ErickCalle/Monitoreo-Consumo-Combustible-La-Paz-Bolivia/CAP5/cap5.tex

% !TEX root = ../main.tex
% ============================================================================
% CAPÍTULO 5 — ANÁLISIS DE COSTOS Y PRESUPUESTO
% ============================================================================

\chapter{ANÁLISIS DE COSTOS Y PRESUPUESTO}

Este capítulo cuantifica el costo de desarrollar, fabricar y validar el sistema descrito en los Capítulos 3 y 4, y evalúa su viabilidad económica frente a alternativas comerciales existentes. El desglose sigue el mismo criterio de agrupación funcional ya establecido en la lista de materiales del Capítulo~3 (Tabla~\ref{bom}) y en la tabla de componentes del prototipo del Capítulo~4 (Tabla~\ref{tab:componentes_protoboard}). Así, cada partida de costo puede rastrearse hasta el componente físico concreto que la origina, en lugar de quedar como una cifra agregada sin respaldo.

Los montos se expresan en bolivianos (Bs), moneda de referencia ya utilizada en el resto del proyecto de grado (por ejemplo, \texttt{FUEL\_PRICE\_BS\_PER\_L} en el firmware), con una columna equivalente en dólares (USD) para los componentes que se cotizan internacionalmente (LCSC, JLCPCB, AliExpress). Dado que el tipo de cambio BOB/USD ha tenido variaciones significativas en el mercado boliviano en los últimos años, las conversiones de este capítulo usan el tipo de cambio paralelo vigente al momento de la cotización, 11,60\,Bs/USD (agosto de 2026), y no un valor fijo asumido de antemano ni el tipo de cambio oficial, que en este periodo no refleja el costo real de acceso a dólares para la importación de componentes.

\section{Costos de componentes electrónicos}

Esta sección desglosa el costo de los componentes electrónicos en los mismos cuatro bloques funcionales de la Tabla~\ref{bom}: procesamiento, alimentación, interfaz CAN y periféricos. Las cantidades de cada fila provienen directamente de esa tabla; aquí solo se añaden el precio unitario y el subtotal por bloque.

\subsection{Costos del módulo de procesamiento (ESP32-S3)}

\begin{table}[H]
	\centering
	\captionsetup{labelformat=simple, labelsep=newline, textfont=it, labelfont=bf, justification=raggedright, singlelinecheck=false}
	\caption{Costo del módulo de procesamiento}
	\label{tab:costo_procesamiento}
	\begin{tabularx}{\textwidth}{X >{\centering\arraybackslash}p{1.6cm} >{\centering\arraybackslash}p{2.6cm} >{\centering\arraybackslash}p{2.6cm} >{\centering\arraybackslash}p{2.6cm}}
		\toprule
		\rowcolor[rgb]{0.851, 0.851, 0.851}
		Componente & Cant. & Precio unit. (USD) & Precio unit. (Bs) & Subtotal (Bs) \\
		\midrule
		Módulo ESP32-S3-WROOM-1-N16R8 (DevKitC-1, prototipo) & 1 & 9,48 & 110 & 110 \\
		\bottomrule
	\end{tabularx}
	\vspace{2mm}
	\\
	\begin{minipage}{\linewidth}
		\small
		\textit{Nota.} Precio del módulo de desarrollo completo (\textit{DevKitC-1}); la versión final en PCB propia podría usar el módulo suelto a menor costo, a cambio de requerir un programador externo para el primer flasheo.
	\end{minipage}
\end{table}

\subsection{Costos de la etapa de alimentación (buck y LDOs)}

\begin{table}[H]
	\centering
	\captionsetup{labelformat=simple, labelsep=newline, textfont=it, labelfont=bf, justification=raggedright, singlelinecheck=false}
	\caption{Costo de la etapa de alimentación de dos rieles}
	\label{tab:costo_alimentacion}
	\begin{tabularx}{\textwidth}{X >{\centering\arraybackslash}p{1.6cm} >{\centering\arraybackslash}p{2.6cm} >{\centering\arraybackslash}p{2.6cm} >{\centering\arraybackslash}p{2.6cm}}
		\toprule
		\rowcolor[rgb]{0.851, 0.851, 0.851}
		Componente & Cant. & Precio unit. (USD) & Precio unit. (Bs) & Subtotal (Bs) \\
		\midrule
		Convertidor buck síncrono TPS54302DDCR & 1 & 0,2538 & 2,94 & 2,94 \\
		LDO AMS1117-3,3 (riel 1) & 1 & 0,2039 & 2,37 & 2,37 \\
		LDO AP2112K-3,3TRG1 (riel 2) & 1 & 0,2043 & 2,37 & 2,37 \\
		Diodo Schottky SS34 (protección polaridad) & 1 & 0,039 & 0,45 & 0,45 \\
		Fusible PTC reseteable 1812L150/33GR & 1 & 0,0575 & 0,67 & 0,67 \\
		Inductor de potencia 10~\textmu H & 1 & 1,3769 & 15,97 & 15,97 \\
		Condensadores y resistencias pasivas (Tabla~\ref{bom}) & 16 & 0,7323 & 8,49 & 135,91 \\
		\bottomrule
	\end{tabularx}
	\vspace{2mm}
	\\
	\begin{minipage}{\linewidth}
		\small
		\textit{Nota.} Los pasivos se cotizan por cinta/carrete completo, por lo que a cantidad de prototipo su costo unitario es mayor que en producción en volumen; se diluye al escalar (Subsección~\ref{sec:costo_beneficio}).
	\end{minipage}
\end{table}

\subsection{Costos de la interfaz CAN (transceptor y protección)}

\begin{table}[H]
	\centering
	\captionsetup{labelformat=simple, labelsep=newline, textfont=it, labelfont=bf, justification=raggedright, singlelinecheck=false}
	\caption{Costo de la interfaz de bus CAN}
	\label{tab:costo_can}
	\begin{tabularx}{\textwidth}{X >{\centering\arraybackslash}p{1.6cm} >{\centering\arraybackslash}p{2.6cm} >{\centering\arraybackslash}p{2.6cm} >{\centering\arraybackslash}p{2.6cm}}
		\toprule
		\rowcolor[rgb]{0.851, 0.851, 0.851}
		Componente & Cant. & Precio unit. (USD) & Precio unit. (Bs) & Subtotal (Bs) \\
		\midrule
		Transceptor CAN SN65HVD230 & 1 & 1,5216 & 17,65 & 17,65 \\
		Resistor control de pendiente (10~k$\Omega$) & 1 & 0,0912 & 1,06 & 1,06 \\
		Resistor de terminación 120~$\Omega$ (\textit{footprint} opcional, no poblado) & 0 & --- & --- & 0{,}00 \\
		Condensador de desacople & 1 & 0,4296 & 4,98 & 4,98 \\
		\bottomrule
	\end{tabularx}
	\vspace{2mm}
	\\
	\begin{minipage}{\linewidth}
		\small
		\textit{Nota.} El resistor de terminación no se puebla por defecto (Tabla~\ref{bom}, nota $^{a}$): el dispositivo se conecta en derivación a un bus CAN que el vehículo ya termina, por eso su costo es cero y no una omisión.
	\end{minipage}
\end{table}

\subsection{Costos de periféricos (MicroSD, OLED, conectores)}

\begin{table}[H]
	\centering
	\captionsetup{labelformat=simple, labelsep=newline, textfont=it, labelfont=bf, justification=raggedright, singlelinecheck=false}
	\caption{Costo de periféricos de almacenamiento, visualización y conexión}
	\label{tab:costo_perifericos}
	\begin{tabularx}{\textwidth}{X >{\centering\arraybackslash}p{1.6cm} >{\centering\arraybackslash}p{2.6cm} >{\centering\arraybackslash}p{2.6cm} >{\centering\arraybackslash}p{2.6cm}}
		\toprule
		\rowcolor[rgb]{0.851, 0.851, 0.851}
		Componente & Cant. & Precio unit. (USD) & Precio unit. (Bs) & Subtotal (Bs) \\
		\midrule
		Zócalo MicroSD (\textit{push-push}) & 1 & 0,1318 & 1,53 & 1,53 \\
		Tarjeta MicroSD (capacidad de referencia) & 1 & 3,2141 & 37,28 & 37,28 \\
		Pantalla OLED SSD1306 I\textsuperscript{2}C 0,96 & 1 & 2,686 & 31,16 & 31,16 \\
		Conector OBD-II tipo A con cable & 1 & 0,8 & 9,28 & 9,28 \\
		LEDs indicadores + resistencias limitadoras & 4 & 0,2120 & 2,46 & 9,84 \\
		Resistencias \textit{pull-up} SPI/I\textsuperscript{2}C (Tabla~\ref{bom}) & 6 & 0,0460 & 0,53 & 3,20 \\
		\bottomrule
	\end{tabularx}
	\vspace{2mm}
	\\
	\begin{minipage}{\linewidth}
		\small
		\textit{Nota.} La capacidad de la tarjeta MicroSD es más una decisión de autonomía de registro que de costo: dado el tamaño de fila estimado en el Capítulo~4 ($\approx$100 bytes/fila a 1 muestra/s), incluso una tarjeta de 8~GB excede ampliamente los requisitos de años de uso continuo, así que pagar por mayor capacidad no tiene sentido.
	\end{minipage}
\end{table}

\section{Costos de desarrollo y software}

El conjunto de herramientas de desarrollo de firmware empleado (Visual Studio Code, la extensión PlatformIO IDE y el \textit{framework} \texttt{arduino-esp32}) es de uso libre y sin costo de licenciamiento, criterio de selección ya justificado en la Sección de herramientas del Capítulo~3. El costo real de esta partida no está en licencias, entonces, sino en el tiempo de ingeniería invertido en el diseño de hardware, el firmware y la interfaz web. La tarifa de la Tabla~\ref{tab:costo_horas} se deja deliberadamente en 0\,Bs/h: el objetivo de este capítulo es el costo de materiales y fabricación, no el valor de mercado de las horas de un proyecto de grado, así que el total de horas queda documentado como referencia de esfuerzo, no como partida monetaria.

\begin{table}[H]
	\centering
	\captionsetup{labelformat=simple, labelsep=newline, textfont=it, labelfont=bf, justification=raggedright, singlelinecheck=false}
	\caption{Costo estimado de horas de ingeniería por etapa de desarrollo}
	\label{tab:costo_horas}
	\begin{tabularx}{\textwidth}{X >{\centering\arraybackslash}p{2.6cm} >{\centering\arraybackslash}p{2.6cm} >{\centering\arraybackslash}p{2.6cm}}
		\toprule
		\rowcolor[rgb]{0.851, 0.851, 0.851}
		Etapa & Horas estimadas & Tarifa (Bs/h) & Subtotal (Bs) \\
		\midrule
		Diseño de esquemático y PCB & 8 & 0 & 0 \\
		Desarrollo de firmware (adquisición, cálculo, almacenamiento) & 28 & 0 & 0 \\
		Desarrollo del panel web (HMI) & 28 & 0 & 0 \\
		Pruebas, calibración y depuración & 120 & 0 & 0 \\
		\midrule
		\textbf{Total} & \textbf{184} & --- & \textbf{0} \\
		\bottomrule
	\end{tabularx}
	\vspace{2mm}
	\\
	\begin{minipage}{\linewidth}
		\small
		\textit{Nota.} Horas estimadas a partir de la dedicación real del autor ($\approx$4\,h/día): 2 días para la PCB, 1 semana para firmware y panel web cada uno, y 1 mes para la calibración.
	\end{minipage}
\end{table}

\section{Costos de fabricación y ensamblaje}

\subsection{Costos de la placa preliminar (Robokit)}
\label{sec:costo_pcb_preliminar}

La placa preliminar en Altium Designer descrita en la Sección~\ref{sec:placa_preliminar} (Capítulo~4) es, hasta el momento, la única placa de este proyecto efectivamente fabricada y ensamblada; por eso es la que se usa como \textbf{costo real del prototipo} en el presupuesto consolidado de este capítulo (Tabla~\ref{tab:presupuesto_total}). Se encargó localmente a Robokit (La Paz), lo que evita el envío internacional y la aduana que sí aplican a una fabricación en JLCPCB (Subsección~\ref{sec:costo_pcb_final}).

\begin{table}[H]
	\centering
	\captionsetup{labelformat=simple, labelsep=newline, textfont=it, labelfont=bf, justification=raggedright, singlelinecheck=false}
	\caption{Costo de fabricación de la placa preliminar en Robokit}
	\label{tab:costo_pcb_preliminar}
	\begin{tabularx}{\textwidth}{X >{\centering\arraybackslash}p{2cm} >{\centering\arraybackslash}p{2.6cm}}
		\toprule
		\rowcolor[rgb]{0.851, 0.851, 0.851}
		Concepto & Cantidad & Subtotal (Bs) \\
		\midrule
		Fabricación de PCB (Robokit, La Paz) & 1 & 150,00 \\
		Ensamblaje (soldadura manual, propia) & --- & 0,00 \\
		\midrule
		\textbf{Total} & --- & \textbf{150,00} \\
		\bottomrule
	\end{tabularx}
	\vspace{2mm}
	\\
	\begin{minipage}{\linewidth}
		\small
		\textit{Nota.} Cotización y fabricación locales (La Paz), sin envío internacional ni aduana; el ensamblaje manual, hecho por el propio autor, no tiene costo adicional (mismo criterio de tarifa 0\,Bs/h de la Tabla~\ref{tab:costo_horas}).
	\end{minipage}
\end{table}

La lista de materiales real de esta placa (16 referencias, exportada desde Altium Designer) muestra que su etapa de alimentación es una regulación lineal simple (7805 + transistor de paso TIP42C) y no la conversión conmutada de dos rieles de la Tabla~\ref{tab:costo_alimentacion} —esa etapa es específica de la placa final—; el módulo ESP32-S3, el transceptor CAN, la pantalla OLED y la tarjeta microSD son los mismos ya presupuestados en las Tablas~\ref{tab:costo_procesamiento}, \ref{tab:costo_can} y~\ref{tab:costo_perifericos}, reutilizados desde la etapa de protoboard y conectados a esta placa mediante los conectores de la Tabla~\ref{tab:costo_placa_preliminar_bom} en vez de cableado suelto. Los indicadores LED y sus resistencias limitadoras también coinciden con los ya contabilizados en la Tabla~\ref{tab:costo_perifericos}, por lo que no se repiten aquí. Los precios de la Tabla~\ref{tab:costo_placa_preliminar_bom} se tomaron de LCSC a partir de las referencias de fabricante exportadas desde Altium Designer; las tres partidas sin coincidencia exacta en el catálogo (capacitor de 22\,\textmu F, header de 8 pines y conector de 4 pines) se estiman por interpolación directa desde variantes de la misma familia con precio confirmado, no por un valor arbitrario.

\begin{table}[H]
	\centering
	\captionsetup{labelformat=simple, labelsep=newline, textfont=it, labelfont=bf, justification=raggedright, singlelinecheck=false}
	\caption{Componentes adicionales de la placa preliminar (etapa de alimentación y conectores)}
	\label{tab:costo_placa_preliminar_bom}
	\begin{tabularx}{\textwidth}{X >{\centering\arraybackslash}p{1.6cm} >{\centering\arraybackslash}p{2.2cm} >{\centering\arraybackslash}p{2.2cm} >{\centering\arraybackslash}p{2.2cm}}
		\toprule
		\rowcolor[rgb]{0.851, 0.851, 0.851}
		Componente & Cant. & Precio unit. (USD) & Precio unit. (Bs) & Subtotal (Bs) \\
		\midrule
		Regulador lineal 7805 (TO-252) & 1 & 0,0979 & 1,14 & 1,14 \\
		Transistor de paso TIP42C (TO-220) & 1 & 0,1777 & 2,06 & 2,06 \\
		Capacitor electrolítico 220\,\textmu F & 1 & 0,1400 & 1,62 & 1,62 \\
		Capacitor electrolítico 22\,\textmu F & 1 & 0,1200 & 1,39 & 1,39 \\
		Capacitor cerámico 100\,nF & 2 & 0,0200 & 0,23 & 0,46 \\
		Resistor THT 47\,$\Omega$ 1\,W & 1 & 0,0112 & 0,13 & 0,13 \\
		Conector de entrada de alimentación, 4~pines (WJ301V-5.0) & 1 & 0,1700 & 1,97 & 1,97 \\
		Header 4~pines (pantalla OLED) & 1 & 0,0198 & 0,23 & 0,23 \\
		Header 6~pines (transceptor SN65HVD230) & 1 & 0,0298 & 0,35 & 0,35 \\
		Header 8~pines (módulo microSD) & 1 & 0,0400 & 0,46 & 0,46 \\
		\midrule
		\textbf{Total} & --- & --- & --- & \textbf{9,81} \\
		\bottomrule
	\end{tabularx}
	\vspace{2mm}
	\\
	\begin{minipage}{\linewidth}
		\small
		\textit{Nota.} Precios de referencia LCSC (por ejemplo, \texttt{KS104M050C07RR0VH2FP0} para el capacitor de 100\,nF), convertidos a bolivianos al tipo de cambio de este capítulo (11,60\,Bs/USD).
	\end{minipage}
\end{table}

\subsection{Costo de la carcasa del prototipo}

La carcasa impresa en 3D para la placa preliminar (Capítulo~3, Sección~\ref{sec:carcasa_prototipo}) se costea por peso de material: PLA a 130\,Bs el rollo de 1\,kg, impresión con impresora propia (sin costo de servicio de impresión).

\begin{table}[H]
	\centering
	\captionsetup{labelformat=simple, labelsep=newline, textfont=it, labelfont=bf, justification=raggedright, singlelinecheck=false}
	\caption{Costo de material de la carcasa del prototipo}
	\label{tab:costo_carcasa}
	\begin{tabularx}{\textwidth}{X >{\centering\arraybackslash}p{2cm} >{\centering\arraybackslash}p{2.6cm}}
		\toprule
		\rowcolor[rgb]{0.851, 0.851, 0.851}
		Pieza & Peso (g) & Subtotal (Bs) \\
		\midrule
		Base (impresa) & 21 & 2,73 \\
		Tapa (impresa) & 16 & 2,08 \\
		\midrule
		\textbf{Total} & \textbf{37} & \textbf{4,81} \\
		\bottomrule
	\end{tabularx}
	\vspace{2mm}
	\\
	\begin{minipage}{\linewidth}
		\small
		\textit{Nota.} PLA a 130\,Bs/kg (0,13\,Bs/g); no incluye costo de mano de obra propia (Tabla~\ref{tab:costo_horas}) ni desgaste de la impresora.
	\end{minipage}
\end{table}

\subsection{Costos de manufactura de la placa final (JLCPCB)}
\label{sec:costo_pcb_final}

A diferencia de la placa preliminar, la placa final documentada en el Capítulo~3 (diseñada en Altium Designer) todavía no se ha mandado a fabricar; esta subsección presenta su cotización de referencia, relevante si el proyecto avanza hacia esa versión más profesional o hacia una serie piloto para varios vehículos de transporte público. Se cotiza sobre el lote mínimo estándar de JLCPCB para placas de dos capas (Tabla~\ref{jlcpcb}, Capítulo~3), habitualmente de 5 unidades, que es también el tamaño de lote recomendado para tener margen ante fallas de soldadura o defectos de una unidad individual durante las pruebas iniciales.

\begin{table}[H]
	\centering
	\captionsetup{labelformat=simple, labelsep=newline, textfont=it, labelfont=bf, justification=raggedright, singlelinecheck=false}
	\caption{Costo de fabricación de PCB en JLCPCB}
	\label{tab:costo_pcb}
	\begin{tabularx}{\textwidth}{X >{\centering\arraybackslash}p{1.6cm} >{\centering\arraybackslash}p{2.2cm} >{\centering\arraybackslash}p{2.2cm} >{\centering\arraybackslash}p{2.2cm}}
		\toprule
		\rowcolor[rgb]{0.851, 0.851, 0.851}
		Concepto & Cantidad & Precio unit. (USD) & Precio unit. (Bs) & Subtotal (Bs) \\
		\midrule
		Fabricación de PCB (lote mínimo, 2 capas, 1~oz) & 1 & 4,00 & 46,40 & 46,40 \\
		Envío internacional (DHL/courier) & 1 & 38,00 & 440,80 & 440,80 \\
		Impuestos/aduana de importación (si aplica) & 1 & - & - & - \\
		\bottomrule
	\end{tabularx}
	\vspace{2mm}
	\\
	\begin{minipage}{\linewidth}
		\small
		\textit{Nota.} El envío y la aduana suelen pesar más que la fabricación misma en lotes de prototipo pequeños importados a Bolivia; conviene cotizarlos por separado.
	\end{minipage}
\end{table}

\subsection{Costos de ensamblaje SMD de la placa final}

Para la placa final, el ensamblaje de los componentes de montaje superficial puede resolverse por dos vías con una disyuntiva clara de costo contra riesgo: el servicio de ensamblaje (PCBA) del propio fabricante, o el soldado manual con estación de aire caliente/soldadora de precisión. La placa preliminar (Sección~\ref{sec:costo_pcb_preliminar}), en cambio, ya se ensambló manualmente por el propio autor, sin necesidad de esta disyuntiva.

\begin{table}[H]
	\centering
	\captionsetup{labelformat=simple, labelsep=newline, textfont=it, labelfont=bf, justification=raggedright, singlelinecheck=false}
	\caption{Comparación de estrategias de ensamblaje SMD}
	\label{tab:costo_ensamblaje}
	\begin{tabularx}{\textwidth}{>{\raggedright\arraybackslash}p{3.2cm} X X}
		\toprule
		\rowcolor[rgb]{0.851, 0.851, 0.851}
		Criterio & Ensamblaje PCBA (JLCPCB) & Soldadura manual \\
		\midrule
		Costo & 1\,440,60 Bs (124,19 USD; incluye \textit{setup} + componentes + mano de obra) & Solo costo de componentes; tiempo propio no facturado \\
		Riesgo técnico & Bajo: máquina \textit{pick-and-place} coloca el TPS54302DDCR (SOT-23-6) sin riesgo de puente de soldadura & Medio-alto en los pasivos 0603 y el regulador \textit{buck}, componentes de paso fino \\
		Tiempo de entrega & Sujeto al lote de fabricación + envío & Inmediato una vez recibida la PCB desnuda \\
		Recomendado cuando & Se fabrica más de una unidad, o no se dispone de estación de retrabajo SMD & Se ensambla una sola unidad de prototipo y ya se cuenta con el equipo de soldadura \\
		\bottomrule
	\end{tabularx}
	\vspace{2mm}
	\\
	\begin{minipage}{\linewidth}
		\small
		\textit{Nota.} Comparación de referencia para la futura placa final; la placa preliminar ya construida (Tabla~\ref{tab:costo_pcb_preliminar}) usó soldadura manual (columna derecha). Elaboración propia.
	\end{minipage}
\end{table}

\section{Costos de pruebas y validación}

El precio del litro de gasolina (6,96\,Bs) es el mismo valor de referencia (\texttt{FUEL\_PRICE\_BS\_PER\_L}) que usa el firmware para calcular el costo del viaje (Capítulo~3), y los 22,03~L de combustible corresponden a la suma de los totales reales de aforo tanque lleno del Capítulo~4 (Nissan Vanette 12,96~L + Changan Honor 9,07~L, Tablas~\ref{tab:comparacion_consumo_vanette}/\ref{tab:comparacion_consumo_changan}): el consumo efectivamente gastado en los nueve tramos de prueba, no la capacidad de los tanques.

\begin{table}[H]
	\centering
	\captionsetup{labelformat=simple, labelsep=newline, textfont=it, labelfont=bf, justification=raggedright, singlelinecheck=false}
	\caption{Costos asociados a la fase de pruebas y validación (Capítulo 4)}
	\label{tab:costo_pruebas}
	\begin{tabularx}{\textwidth}{X >{\centering\arraybackslash}p{2.6cm} >{\centering\arraybackslash}p{2.6cm} >{\centering\arraybackslash}p{2.6cm}}
		\toprule
		\rowcolor[rgb]{0.851, 0.851, 0.851}
		Concepto & Cantidad & Precio unit. (Bs) & Subtotal (Bs) \\
		\midrule
		Adaptador ELM327 Bluetooth (referencia de validación) & 1 & 85,00 & 85,00 \\
		Suscripción \textit{Car Scanner} Premium (3 meses) & 1 & 22,99 & 22,99 \\
		Combustible para trayectos de prueba tanque a tanque (Sección~\ref{sec:protocolo_tanque}, Cap.~4) & 22,03~L & 6,96 & 153,33 \\
		Instrumento de medición de corriente (tester) & 1 & 55,00 & 55,00 \\
		\midrule
		\textbf{Total} & --- & --- & \textbf{316,32} \\
		\bottomrule
	\end{tabularx}
	\vspace{2mm}
	\\
	\begin{minipage}{\linewidth}
		\small
		\textit{Nota.} Elaboración propia.
	\end{minipage}
\end{table}

\section{Presupuesto total del proyecto}

La Tabla~\ref{tab:presupuesto_total} consolida los subtotales de las secciones anteriores, usando la placa preliminar de Robokit (Sección~\ref{sec:costo_pcb_preliminar}) como fabricación real del prototipo. El presupuesto se presenta también en su forma de \textit{costo marginal por unidad adicional} (Tabla~\ref{tab:presupuesto_total}, última fila), escalando esta vez hacia la placa final en Altium Designer y su fabricación en JLCPCB (Sección~\ref{sec:costo_pcb_final}), relevante si el proyecto avanza hacia esa versión más profesional o hacia una pequeña serie de dispositivos para varios vehículos de transporte público, escenario directamente ligado a la motivación planteada en el Capítulo~1.

\begin{table}[H]
	\centering
	\captionsetup{labelformat=simple, labelsep=newline, textfont=it, labelfont=bf, justification=raggedright, singlelinecheck=false}
	\caption{Presupuesto total del proyecto, por categoría}
	\label{tab:presupuesto_total}
	\begin{tabularx}{\textwidth}{X >{\centering\arraybackslash}p{3.5cm} >{\centering\arraybackslash}p{3cm}}
		\toprule
		\rowcolor[rgb]{0.851, 0.851, 0.851}
		Categoría & Subtotal (Bs) & \%~del total \\
		\midrule
		Componentes electrónicos (Tablas~\ref{tab:costo_procesamiento}, \ref{tab:costo_can}, \ref{tab:costo_perifericos} y~\ref{tab:costo_placa_preliminar_bom}) & 235,79 & 33,35\,\% \\
		Desarrollo y software (Tabla~\ref{tab:costo_horas}) & 0,00 & 0,00\,\% \\
		Fabricación y ensamblaje, placa preliminar (Tablas~\ref{tab:costo_pcb_preliminar} y~\ref{tab:costo_carcasa}) & 154,81 & 21,90\,\% \\
		Pruebas y validación (Tabla~\ref{tab:costo_pruebas}) & 316,32 & 44,75\,\% \\
		\midrule
		\textbf{Total del prototipo} & \textbf{706,92} & \textbf{100\,\%} \\
		\midrule
		Costo marginal estimado por unidad adicional, placa final$^{a}$ & 772,22 & --- \\
		\bottomrule
	\end{tabularx}
	\vspace{2mm}
	\\
	\begin{minipage}{\linewidth}
		\small
		\textit{Nota.} $^{a}$Estimado para la placa final (JLCPCB), no para el total del prototipo (placa preliminar de Robokit); detalle del cálculo a continuación.
	\end{minipage}
\end{table}

El costo marginal excluye las horas de diseño de hardware/firmware (Tabla~\ref{tab:costo_horas}), un costo de desarrollo único (\textit{non-recurring engineering}) que no se repite por unidad fabricada, e incluye los componentes (386,66\,Bs) más la fabricación de PCB y el ensamblaje PCBA a prorrata del lote mínimo de 5 unidades de JLCPCB (Tablas~\ref{tab:costo_pcb}/\ref{tab:costo_ensamblaje}: $(487{,}20+1\,440{,}60)/5 = 385{,}56$\,Bs), es decir $386{,}66+385{,}56=772{,}22$\,Bs por unidad adicional dentro del mismo lote.

\begin{figure}[H]
	\centering
	\caption{Distribución porcentual del presupuesto total del proyecto por categoría}
	\label{fig:pastel_presupuesto}
	

	\vspace{2pt}
	{\footnotesize\textit{Nota.} Gráfico de pastel: las cuatro categorías son mutuamente excluyentes y suman el 100\,\%~del presupuesto, lo que comunica de forma más directa que una tabla de números. Elaboración propia a partir de \texttt{CODIGOS/presupuesto\_pie.py} \citep{CalleGitHub2026}.}
\end{figure}

\subsection{Precio de venta estimado (utilidad e IVA)}

Los costos anteriores son costos directos, sin margen de ganancia ni impuestos. La Tabla~\ref{tab:precio_venta} aplica una utilidad del 20\,\%, valor de referencia habitual en la formulación de proyectos de la carrera, y luego el Impuesto al Valor Agregado (IVA) vigente en Bolivia (13\,\%) sobre el precio ya con utilidad, sobre tres bases de costo distintas. La primera y la tercera parten del prototipo tal como se construyó (706,92\,Bs, fila ``Total del prototipo'' de la Tabla~\ref{tab:presupuesto_total}); la tercera, además, resta el combustible de las pruebas tanque a tanque (153,33\,Bs, Tabla~\ref{tab:costo_pruebas}), bajo el supuesto de que esas pruebas ya se realizaron y ese gasto no se traslada a un comprador de esta misma unidad. La segunda es el costo marginal por unidad adicional si se escalara a la placa final (772,22\,Bs, fila ``Costo marginal estimado por unidad adicional'' de la misma tabla), que ya excluye por completo la Tabla~\ref{tab:costo_pruebas} (no solo el combustible, también ELM327 y el tester), al no ser un gasto que se repita al producir una unidad adicional.

\begin{table}[H]
	\centering
	\captionsetup{labelformat=simple, labelsep=newline, textfont=it, labelfont=bf, justification=raggedright, singlelinecheck=false}
	\caption{Precio de venta estimado, prototipo actual vs. unidad adicional}
	\label{tab:precio_venta}
	\begin{tabularx}{\textwidth}{X >{\centering\arraybackslash}p{2.4cm} >{\centering\arraybackslash}p{2.6cm} >{\centering\arraybackslash}p{2.6cm}}
		\toprule
		\rowcolor[rgb]{0.851, 0.851, 0.851}
		Concepto & Este prototipo (Bs) & Unidad adicional, placa final (Bs) & Este prototipo, sin combustible de prueba$^{a}$ (Bs) \\
		\midrule
		Costo directo (Tabla~\ref{tab:presupuesto_total}) & 706,92 & 772,22 & 553,59 \\
		Utilidad (20\,\%) & 141,38 & 154,44 & 110,72 \\
		\midrule
		Subtotal (costo + utilidad) & 848,30 & 926,66 & 664,31 \\
		IVA (13\,\%) & 110,28 & 120,47 & 86,36 \\
		\midrule
		\textbf{Precio de venta estimado} & \textbf{958,58} & \textbf{1\,047,13} & \textbf{750,67} \\
		\bottomrule
	\end{tabularx}
	\vspace{2mm}
	\\
	\begin{minipage}{\linewidth}
		\small
		\textit{Nota.} Utilidad y IVA aplicados de forma secuencial (utilidad sobre el costo directo, IVA sobre el precio ya con utilidad), no simultánea sobre el mismo costo base. El 20\,\%~de utilidad es un valor de referencia, no una cotización de mercado; puede ajustarse sin afectar el resto del capítulo. $^{a}$706,92\,Bs $-$ 153,33\,Bs de combustible (Tabla~\ref{tab:costo_pruebas}) $=$ 553,59\,Bs; a diferencia de la columna del centro, aquí sí se conservan el ELM327 y el tester dentro del costo, ya que son instrumentos físicos y no un insumo consumido.
	\end{minipage}
\end{table}

\section{Análisis de viabilidad económica}

\subsection{Comparación con soluciones comerciales existentes}

El sistema propuesto se contrasta contra dos categorías de alternativas ya mencionadas en los Antecedentes del Capítulo~1: los adaptadores OBD-II genéricos de bajo costo combinados con una aplicación móvil (por ejemplo, ELM327 + \textit{Car Scanner}, ya usado como referencia de validación en el Capítulo~4), y las plataformas de telemetría de flota comerciales orientadas a empresas de transporte.

\begin{table}[H]
	\centering
	\captionsetup{labelformat=simple, labelsep=newline, textfont=it, labelfont=bf, justification=raggedright, singlelinecheck=false}
	\caption{Comparación funcional y de costo frente a alternativas comerciales}
	\label{tab:comparacion_comercial}
	\begin{tabularx}{\textwidth}{>{\raggedright\arraybackslash}p{3.4cm} X X X}
		\toprule
		\rowcolor[rgb]{0.851, 0.851, 0.851}
		Criterio & Sistema propuesto & ELM327 + app comercial & Telemetría de flota comercial \\
		\midrule
		Costo inicial & 772,22 Bs$^{a}$ (Tabla~\ref{tab:presupuesto_total}) & 85,00 Bs (Tabla~\ref{tab:costo_pruebas}) & Desde 58\,000 Bs$^{b}$ (USD 5\,000, \textit{FuelForce}, pago único); el resto de proveedores cobra el hardware por separado, sin monto público \\
		Costo recurrente & Ninguno (sin suscripción) & Suscripción \textit{Car Scanner} Premium: 22,99\,Bs cada 3 meses & USD 4 a 100 por vehículo/mes según proveedor$^{b}$ ($\approx$46 a 1\,160\,Bs/mes) \\
		Registro local sin conexión a internet & Sí (microSD) & Depende de la app & Generalmente requiere conectividad \\
		Panel propio, sin dependencia de un tercero & Sí (SoftAP local) & No (depende del proveedor de la app) & No (plataforma del proveedor) \\
		Código y diseño abiertos, personalizables & Sí & No & No \\
		Corrección/\allowbreak calibración específica del vehículo & Sí (\texttt{FUEL\_\allowbreak CALIBRATION\_\allowbreak FACTOR}, tabla VE) & Limitada o inexistente & Variable según proveedor \\
		\bottomrule
	\end{tabularx}
	\vspace{2mm}
	\\
	\begin{minipage}{\linewidth}
		\small
		\textit{Nota.} Elaboración propia. $^{a}$Costo marginal escalando a la placa final (Tabla~\ref{tab:presupuesto_total}), no el total del prototipo, que aún incluye instrumentos de validación ajenos a una unidad desplegable. $^{b}$Precios internacionales de referencia; fuentes detalladas a continuación.
	\end{minipage}
\end{table}

Los precios de telemetría de flota no tienen cotización pública para el mercado boliviano; se tomaron de \textit{Fleetio}, ``6 Best Fuel Monitoring Systems: 2025 Comparison Guide'' (\texttt{fleetio.com/blog/fuel-monitoring-systems}, consultado en agosto de 2026): Fleetio USD 4--10/vehículo/mes; Motive desde USD~25/vehículo/mes más costo de dispositivos ELD; Samsara USD 27--33/vehículo/mes (software; hardware aparte); Geotab USD 35--100/vehículo/mes (software; hardware aparte); y FuelForce desde USD~5\,000 en pago único por funcionalidad, en vez de suscripción. La conversión a bolivianos usa el mismo tipo de cambio de este capítulo (11,60\,Bs/USD).

\begin{figure}[H]
	\centering
	\caption{Comparación de costo inicial entre el sistema propuesto y alternativas comerciales}
	\label{fig:barras_comparacion_comercial}
	

	\vspace{2pt}
	{\footnotesize\textit{Nota.} Barras horizontales: los nombres de las tres alternativas se leen mejor como etiquetas de eje. Escala logarítmica en el costo porque los valores abarcan casi tres órdenes de magnitud (85 a 58\,000\,Bs), con el valor exacto en cada barra. El dato de telemetría de flota es de un único proveedor (\textit{FuelForce}, pago único; Tabla~\ref{tab:comparacion_comercial}), no un promedio del rubro. Elaboración propia.}
\end{figure}

\subsection{Análisis costo-beneficio}
\label{sec:costo_beneficio}

El beneficio económico del sistema no proviene de evitar un gasto de compra (como en la comparación anterior), sino de la reducción de consumo de combustible que su uso puede inducir en el conductor al hacer visible, en tiempo real, un comportamiento de manejo ineficiente. El mecanismo exacto por el que un sistema de monitoreo reduce el consumo es de naturaleza conductual (retroalimentación al conductor) y no una modificación mecánica del vehículo, así que su magnitud solo puede estimarse una vez completada la comparación de consumo del Capítulo~4 (Tablas~\ref{tab:comparacion_consumo_vanette} y~\ref{tab:comparacion_consumo_changan}) entre trayectos con y sin atención activa al panel del dispositivo.

El periodo de recuperación de la inversión (\textit{payback period}) se estima como:

\begin{equation}
	T_{recuperación}\,[\text{meses}] = \frac{\text{Costo total del prototipo (Tabla~\ref{tab:presupuesto_total})}}{\text{Ahorro mensual estimado}\,[\text{Bs/mes}]}
	\label{eq:payback}
\end{equation}

donde el ahorro mensual se obtiene de multiplicar la reducción porcentual de consumo por retroalimentación al conductor (valor de literatura, ya que no se midió en este proyecto) por el gasto mensual de combustible típico del vehículo evaluado, a su vez estimado a partir del kilometraje mensual habitual (también de literatura) y el consumo promedio real observado en el Capítulo~4 (totales de aforo de las Tablas~\ref{tab:comparacion_consumo_vanette}/\ref{tab:comparacion_consumo_changan}).

El kilometraje mensual no se midió para estos vehículos: se usa un valor representativo (200\,km/día $\times$ 30 días) dentro del rango de 150 a 300\,km/día que reporta la literatura de operación de buses urbanos en servicio de todo el día \citep{PPIAF_UrbanBusToolkit_kpvpd}, igual para ambos vehículos al no existir un dato diferenciado por unidad. El consumo promedio sí es un dato real: el total de aforo de tanque lleno entre la distancia total recorrida en los nueve tramos de prueba del Capítulo~4. La reducción de consumo atribuible al monitoreo tampoco se midió en este proyecto —requeriría un diseño experimental adicional, por ejemplo contrastar el mismo trayecto con el panel visible frente al panel oculto para el conductor—; se usa en su lugar el efecto promedio reportado por un metaanálisis de 17 estudios sobre sistemas de retroalimentación \textit{eco-driving} a bordo, $6{,}6\,\%$ de mejora en economía de combustible \citep{Sanguinetti2020EcoDriving}.

\begin{table}[H]
	\centering
	\captionsetup{labelformat=simple, labelsep=newline, textfont=it, labelfont=bf, justification=raggedright, singlelinecheck=false}
	\caption{Estimación del periodo de recuperación de la inversión}
	\label{tab:payback}
	\begin{tabularx}{\textwidth}{X >{\centering\arraybackslash}p{3.5cm} >{\centering\arraybackslash}p{3.5cm}}
		\toprule
		\rowcolor[rgb]{0.851, 0.851, 0.851}
		Variable & Changan Honor & Nissan Vanette \\
		\midrule
		Kilometraje mensual estimado (km)$^{a}$ & 6\,000 & 6\,000 \\
		Consumo promedio (L/100\,km, Cap.~4)$^{b}$ & 7,94 & 10,43 \\
		Gasto mensual de combustible (Bs) & 3\,315,74 & 4\,355,57 \\
		Reducción de consumo atribuible al monitoreo (\%)$^{c}$ & 6,6 & 6,6 \\
		Ahorro mensual estimado (Bs/mes) & 218,84 & 287,47 \\
		Periodo de recuperación (meses) & 3,23 & 2,46 \\
		\bottomrule
	\end{tabularx}
	\vspace{2mm}
	\\
	\begin{minipage}{\linewidth}
		\small
		\textit{Nota.} $^{a}$Valor de literatura, no medido. $^{b}$Dato real: Nissan Vanette $12{,}96/124{,}26\times100$; Changan Honor $9{,}07/114{,}25\times100$ (Tablas~\ref{tab:comparacion_consumo_vanette}/\ref{tab:comparacion_consumo_changan}). $^{c}$Valor de literatura, no medido en este proyecto; ver detalle en el texto anterior.
	\end{minipage}
\end{table}

\begin{figure}[H]
	\centering
	\caption{Punto de equilibrio (\textit{breakeven}) entre el costo del dispositivo y el ahorro acumulado de combustible}
	\label{fig:breakeven}
	

	\vspace{2pt}
	{\footnotesize\textit{Nota.} Gráfico de líneas: costo fijo y ahorro acumulado son funciones continuas del tiempo, y lo relevante es el punto de cruce entre ambas. Los periodos de recuperación (2,46 y 3,23 meses) dependen de los valores de literatura de la Tabla~\ref{tab:payback} (kilometraje y reducción de consumo), así que deben leerse como una estimación, no como una garantía. Elaboración propia.}
\end{figure}

La viabilidad económica de este proyecto, para cerrar el capítulo, no depende únicamente de recuperar el costo de un prototipo individual: depende de su potencial de escalar a una pequeña serie de unidades para el transporte público de La Paz. En ese escenario, el costo marginal por unidad (Tabla~\ref{tab:presupuesto_total}), ya sin las horas de diseño amortizadas por este primer desarrollo, es la cifra económicamente relevante, y no el presupuesto total del prototipo aquí calculado.
