ErickCalle/Monitoreo-Consumo-Combustible-La-Paz-Bolivia/CAP2/CAP2.1.tex

\section{Sistema de inyección electrónica}
\subsection{Evolución de los sistemas de alimentación de combustible}

La evolución de los sistemas de alimentación de combustible en los vehículos ha pasado desde el carburador mecánico hasta sistemas electrónicos de inyección monopunto, multipunto e inyección directa, cada uno asociado a cambios normativos sobre emisiones y avances en electrónica del motor\citep{web1,web10,web14}.

\begin{itemize}
    \item \textbf{Finales del siglo XIX -- 1900}:  
    Los primeros motores de gasolina utilizan mezcladores mecánicos rudimentarios; el carburador se consolida como dispositivo estándar para crear la mezcla aire–combustible\citep{web10, web14}.

    \item \textbf{1912 -- 1930s}:  
    Primeros ensayos de bombas de inyección de gasolina en motores de aviación; en 1937 se aplica en serie la inyección de combustible en motores de avión, sentando las bases para los sistemas de inyección modernos\citep{web14}.

    \item \textbf{1945 -- 1950s}:  
    Primera aplicación en serie de inyección de gasolina en vehículos de carretera; se mantienen sistemas principalmente mecánicos o electromecánicos, usados en modelos deportivos o de alta gama\citep{web14}.

    \item \textbf{1967}:  
    Bosch introduce el sistema D‑Jetronic, el primer sistema de inyección electrónica de gasolina de producción masiva, sustituyendo parcialmente al carburador en Europa\citep{web1}.

    \item \textbf{1970s}:  
    La crisis del petróleo y las normas de emisiones obligan a abandonar parcialmente el carburador; se extienden sistemas de inyección electrónica continuos (por ejemplo KE‑Jetronic) y se empiezan a usar en modelos de serie de fabricantes como Mercedes‑Benz y otros\citep{web1,web14}.

    \item \textbf{1980s}:  
    Aparecen sistemas digitales de gestión del motor (por ejemplo Motronic de Bosch), integrando inyección electrónica multipunto y encendido electrónico; marcas como Volkswagen, BMW y Mercedes adoptan estos sistemas en múltiples modelos\citep{web7}.

    \item \textbf{1990}:  
    Se difunden sistemas de inyección electrónica monopunto y multipunto indirecta en vehículos comerciales de bajo costo (por ejemplo Suzuki Samurai 1990 y Suzuki Jimny 2000)\citep{web10}.

    \item \textbf{1990s -- 2000s}:  
    Implantación masiva del carburador en motores de gasolina reemplazado por inyección electrónica multipunto (por ejemplo General Motors, Ford, Honda, etc.); se adopta el catalizador de tres vías, lo que exige un control muy preciso de la mezcla aire–combustible\citep{web1,web7,web10}.

    \item \textbf{2000s -- 2010s}:  
    Desarrollo de sistemas de inyección directa de gasolina (GDI) en modelos de alta eficiencia y potencia (por ejemplo Toyota, Mazda, BMW, VW, GM); se combinan turbocompresores y control electrónico avanzado para reducir consumo y emisiones\citep{web1,web7}.

    \item \textbf{2010 -- actualidad}:  
    La inyección directa se vuelve estándar en muchos motores de gasolina y se introducen sistemas flexibles de inyección múltiple por ciclo, combinados con sistemas híbridos y electrificación parcial de la alimentación (bomba eléctrica de alta presión, inyección piezoeléctrica en diesel)\citep{web1,web7}.
\end{itemize}

\begin{figure}[h]
	\centering
	
	% 1. El caption automático estilo APA 7 (Título conciso arriba)
	\caption{Línea de tiempo de la evolución en los sistemas de alimentación de combustible}
	\label{fig:evolucion_combustible}
	\vspace{0.3cm}
	
	% 2. La imagen ajustada exactamente al límite del margen del texto
	
	\vspace{0.2cm}
	
	% 3. La nota de la figura según APA 7 (Con descripción técnica)
	\begin{flushleft}
		\footnotesize \textit{Nota.} Cronología del desarrollo tecnológico en la dosificación de combustible, destacando la transición desde sistemas mecánicos por carburador hasta esquemas de inyección electrónica directa controlados por computadora. Elaboración propia con base en \citep{web1}, \citep{web10} y \citep{web7}.
	\end{flushleft}
\end{figure}

\subsection{Tipos de sistemas de inyección electrónica}% (monopunto, multipunto, directa)

Los sistemas de inyección electrónica pueden clasificarse según la forma en que suministran el combustible hacia el motor. Entre los más utilizados se encuentran la inyección monopunto, multipunto y directa, cada una con diferentes características de funcionamiento, eficiencia y complejidad tecnológica \citep{Bosch_Automotive, web_inyeccion1}.

\subsubsection{Inyección monopunto}

La inyección monopunto, también conocida como \textit{Single Point Injection} (SPI) o \textit{Throttle Body Injection} (TBI), utiliza un único inyector ubicado en el cuerpo de aceleración para suministrar combustible a todos los cilindros del motor. Su funcionamiento es similar al carburador, pero con control electrónico de la dosificación de combustible \citep{Bosch_Automotive}.

Este sistema fue ampliamente utilizado durante la transición entre carburadores y sistemas de inyección electrónica modernos debido a su bajo costo y simplicidad. Sin embargo, presenta menor precisión en la distribución del combustible y menor eficiencia energética en comparación con sistemas más avanzados \citep{web_inyeccion2}.

Entre sus principales ventajas se encuentran:
\begin{itemize}
    \item Menor costo de implementación.
    \item Diseño simple y mantenimiento reducido.
    \item Mejor control de emisiones respecto al carburador.
\end{itemize}

No obstante, sus desventajas incluyen:
\begin{itemize}
    \item Distribución desigual del combustible.
    \item Menor rendimiento y eficiencia.
    \item Mayor consumo comparado con sistemas modernos.
\end{itemize}

\subsubsection{Inyección multipunto}

La inyección multipunto o \textit{Multi Point Injection} (MPI) emplea un inyector independiente para cada cilindro del motor. Los inyectores se encuentran ubicados en el múltiple de admisión, permitiendo una dosificación más precisa de combustible hacia cada cilindro \citep{Bosch_Automotive, web_inyeccion1}.

Este sistema mejora significativamente el rendimiento del motor, el consumo de combustible y las emisiones contaminantes. Dependiendo de la estrategia de control de la ECU, la inyección puede realizarse de forma simultánea, secuencial o semisecuencial \citep{web_inyeccion2}.

Entre sus ventajas destacan:
\begin{itemize}
    \item Mejor atomización y distribución del combustible.
    \item Reducción del consumo y emisiones.
    \item Mayor eficiencia y respuesta del motor.
\end{itemize}

Sin embargo:
\begin{itemize}
    \item Requiere mayor cantidad de sensores y componentes electrónicos.
    \item Presenta mayor complejidad de diagnóstico y mantenimiento.
\end{itemize}

\subsubsection{Diferencia entre monopunto y multipunto}
De acuerdo con Motorpasión, la inyección directa puede considerarse una evolución de la inyección multipunto, debido a que ambos sistemas utilizan un inyector por cilindro, pero difieren principalmente en la ubicación donde se introduce el combustible. En la inyección multipunto, el combustible es suministrado en el colector de admisión antes de ingresar a la cámara de combustión ver Figura \ref{fig:Multi}, mientras que en la inyección directa el combustible es pulverizado directamente dentro del cilindro, permitiendo una combustión más eficiente y un mejor aprovechamiento energético \citep{Motorpasion_Inyeccion}.

\begin{figure}[h]
	\centering
	
	% 1. El caption automático estilo APA 7 (Título conciso arriba)
	\caption{Diferencias estructurales entre los sistemas de inyección monopunto y multipunto}
	\label{fig:Multi}
	\vspace{0.3cm}
	
	% 2. La imagen ajustada proporcionalmente al ancho del texto
	
	\vspace{0.2cm}
	
	% 3. La nota de la figura según APA 7 (Con descripción técnica)
	\begin{flushleft}
		\footnotesize \textit{Nota.} Comparación esquemática del posicionamiento y cantidad de inyectores en la galería de admisión, contrastando el suministro centralizado (monopunto) frente al flujo independiente por cilindro (multipunto). Tomado de \citep{Motorpasion_Inyeccion}.
	\end{flushleft}
\end{figure}

\subsubsection{Inyección directa}

La inyección directa de gasolina o \textit{Gasoline Direct Injection} (GDI) introduce el combustible directamente dentro de la cámara de combustión a alta presión, eliminando el paso previo por el múltiple de admisión \citep{Bosch_GDI, web_inyeccion3}.

Este sistema permite un control mucho más preciso de la mezcla aire-combustible, incrementando la eficiencia térmica del motor y reduciendo el consumo de combustible. Además, puede trabajar junto con turbocompresores y estrategias avanzadas de \mbox{control electrónico \citep{Bosch_GDI}}.

Entre sus principales ventajas se encuentran:
\begin{itemize}
    \item Mayor eficiencia energética.
    \item Mejor desempeño y potencia.
    \item Reducción de emisiones contaminantes.
\end{itemize}

Como desventajas:
\begin{itemize}
    \item Mayor complejidad electrónica y mecánica.
    \item Costos elevados de mantenimiento.
    \item Sensibilidad a la calidad del combustible.
\end{itemize}

A continuacion en la Tabla \ref{tab:INye} se compara los distintos tipos de sistemas de inyección electrónica.

\begin{table}[h]
	\centering
	% Título separado bajo norma estricta APA 7
	\captionsetup{labelformat=simple, labelsep=newline, textfont=it, labelfont=bf}
	\caption{Comparación entre los tipos de sistemas de inyección electrónica}
	\label{tab:INye}
	\vspace{0.3cm}
	
	% Se usa tabularx para un autoajuste milimétrico a los márgenes
	\begin{tabularx}{\linewidth}{p{3.8cm} X X X}
		\toprule % Línea superior APA 7
		\rowcolor[rgb]{0.851, 0.851, 0.851}
		\textbf{Característica} & \textbf{Inyección monopunto} & \textbf{Inyección multipunto} & \textbf{Inyección directa} \\
		\midrule % Línea divisoria de encabezado APA 7
		Cantidad de inyectores & Un solo inyector para todos los cilindros & Un inyector por cilindro & Un inyector por cilindro \\
		\addlinespace
		Ubicación de inyección & Cuerpo de aceleración & Colector de admisión & Dentro de la cámara de combustión \\
		\addlinespace
		Formación de mezcla & Antes del múltiple de admisión & Antes de ingresar al cilindro & Dentro del cilindro \\
		\addlinespace
		Precisión de dosificación & Baja & Media-Alta & Alta \\
		\addlinespace
		Consumo de combustible & Mayor & Moderado & Menor \\
		\addlinespace
		Eficiencia energética & Baja & Buena & Muy alta \\
		\addlinespace
		Complejidad electrónica & Baja & Media & Alta \\
		\bottomrule % Línea inferior de cierre APA 7
	\end{tabularx}
	\vspace{0.2cm}
	
	\begin{flushleft}
		\footnotesize \textit{Nota.} Elaboración propia con base en~\citep{Motorpasion_Inyeccion}, \citep{Bosch_Automotive} y~\citep{Bosch_GDI}.
	\end{flushleft}
\end{table}

Actualmente, la inyección directa es ampliamente utilizada en vehículos modernos debido a sus ventajas en eficiencia, desempeño y cumplimiento de normativas ambientales \citep{Bosch_GDI, web_inyeccion3}.

\subsection{Componentes principales del sistema de inyección}% (inyectores, bomba, regulador, sensores)

El sistema de inyección electrónica está conformado por diversos componentes encargados de suministrar, regular y controlar la cantidad de combustible necesaria para el correcto funcionamiento del motor. Estos elementos trabajan de manera conjunta bajo la supervisión de la unidad de control electrónico (ECU), permitiendo optimizar el rendimiento, el consumo de combustible y las emisiones contaminantes \citep{Bosch_Automotive, Bosch_GDI}.

\subsubsection{Inyectores}

Los inyectores son dispositivos electromecánicos encargados de pulverizar el combustible hacia el múltiple de admisión o directamente dentro de la cámara de combustión, dependiendo del tipo de sistema de inyección utilizado. Su funcionamiento es controlado electrónicamente por la ECU mediante pulsos eléctricos que determinan el tiempo de apertura y la cantidad de combustible inyectada \citep{Bosch_GDI}.

La correcta atomización del combustible es fundamental para lograr una combustión eficiente, reducir emisiones contaminantes y mejorar el desempeño del motor. En sistemas modernos de inyección directa, los inyectores trabajan a altas presiones y permiten múltiples inyecciones por ciclo de combustión.

Entre las principales funciones de los inyectores se encuentran:
\begin{itemize}
    \item Dosificar la cantidad de combustible requerida.
    \item Pulverizar el combustible en partículas finas.
    \item Mejorar la mezcla aire-combustible.
    \item Reducir consumo y emisiones.
\end{itemize}

\subsubsection{Bomba de combustible}

La bomba de combustible tiene la función de suministrar el combustible desde el tanque hacia los inyectores manteniendo una presión adecuada dentro del sistema. En vehículos modernos generalmente se utiliza una bomba eléctrica ubicada dentro del tanque de combustible \citep{web_bomba_combustible}.

La presión generada por la bomba depende del tipo de sistema de inyección. Los sistemas multipunto trabajan con presiones moderadas, mientras que los sistemas de inyección directa requieren bombas de alta presión capaces de alimentar los inyectores directamente en la cámara de combustión.

Entre sus funciones principales destacan:
\begin{itemize}
    \item Transportar combustible desde el tanque.
    \item Mantener presión constante en el sistema.
    \item Garantizar el suministro adecuado al motor.
\end{itemize}

\subsubsection{Regulador de presión}

El regulador de presión es el componente encargado de mantener estable la presión del combustible dentro del riel de inyectores ver Figura \ref{fig:Inye}, evitando variaciones que puedan afectar la mezcla aire-combustible \citep{Bosch_Automotive}.

Cuando la presión excede el valor establecido, el regulador permite el retorno del exceso de combustible hacia el tanque. En sistemas modernos, esta regulación puede realizarse electrónicamente mediante sensores y módulos de control integrados.

Sus principales funciones son:
\begin{itemize}
    \item Estabilizar la presión de combustible.
    \item Proteger inyectores y conductos.
    \item Garantizar una dosificación precisa.
\end{itemize}

\begin{figure}[h]
	\centering
	
	% 1. El caption automático estilo APA 7 (Título conciso arriba)
	\caption{Componentes principales y distribución del sistema de inyección electrónica}
	\label{fig:Inye}
	\vspace{0.3cm}
	
	% 2. La imagen ajustada proporcionalmente al ancho del texto
	
	\vspace{0.2cm}
	
	% 3. La nota de la figura según APA 7 (Con descripción técnica)
	\begin{flushleft}
		\footnotesize \textit{Nota.} Disposición física y conectividad de los elementos constitutivos del sistema, incluyendo unidades de control, sensores de monitoreo de parámetros y actuadores para la dosificación de combustible. Elaboración propia con base en~\citep{Fundamentos_Inyeccion}.
	\end{flushleft}
\end{figure}

\subsubsection{Sensores}

Los sensores son dispositivos encargados de medir diferentes variables de funcionamiento del motor y enviar esta información a la ECU para que pueda calcular la cantidad exacta de combustible necesaria en cada condición de operación \citep{Bosch_Automotive, web_sensores_motor}.

Entre los sensores más importantes del sistema de inyección electrónica se encuentran:
\begin{itemize}
    \item Sensor MAF (\textit{Mass Air Flow}): mide el flujo de aire que ingresa al motor.
    \item Sensor MAP (\textit{Manifold Absolute Pressure}): mide la presión del múltiple de admisión.
    \item Sensor TPS (\textit{Throttle Position Sensor}): detecta la posición de la mariposa de aceleración.
    \item Sensor ECT (\textit{Engine Coolant Temperature}): mide la temperatura del refrigerante.
    \item Sensor de oxígeno o lambda: controla la cantidad de oxígeno presente en los gases de escape.
\end{itemize}

La información proporcionada por estos sensores permite que la ECU ajuste continuamente la mezcla aire-combustible, optimizando el rendimiento del motor y reduciendo emisiones contaminantes.

\subsection{Control de la mezcla aire-combustible}

El control de la mezcla aire-combustible constituye uno de los procesos fundamentales en los sistemas modernos de inyección electrónica, debido a su influencia directa sobre la eficiencia térmica del motor, el consumo de combustible y la formación de emisiones contaminantes durante la combustión \citep{Fundamentos_Inyeccion, Bosch_GDI}.

La mezcla aire-combustible se define como la proporción entre la masa de aire y la masa de combustible que ingresa al cilindro para llevar a cabo el proceso de combustión. En motores a gasolina, la relación estequiométrica ideal se aproxima a 14,7:1, es decir, 14,7 partes de aire por cada parte de combustible \citep{Bosch_Automotive}. Esta condición permite una combustión más eficiente y favorece el funcionamiento adecuado del convertidor catalítico.

Para evaluar la calidad de la mezcla, se utiliza el factor lambda ($\lambda$), definido como:

\begin{equation}
	\lambda = \frac{(A/F)_{\mathrm{real}}}{(A/F)_{\mathrm{estequiometrico}}}
	\label{eq:lambda}
\end{equation}

Donde $(A/F)_{\mathrm{real}}$ representa la relación aire-combustible presente en el motor y $(A/F)_{\mathrm{estequiometrico}}$ corresponde a la relación ideal para la combustión completa.

Las variaciones del factor lambda afectan de manera significativa tanto las emisiones contaminantes como el desempeño del motor. Las mezclas ricas incrementan la emisión de monóxido de carbono (CO) e hidrocarburos no quemados (HC), mientras que las mezclas pobres pueden favorecer la formación de óxidos de nitrógeno (NO$_x$) y provocar una disminución de la potencia entregada por el motor \citep{Combustion_Emissions_2020}.

El control de esta mezcla es realizado por la unidad de control electrónico (ECU), la cual recibe información de distintos sensores del motor para ajustar de forma continua el tiempo de inyección y mantener condiciones de combustión adecuadas. Entre los sensores más relevantes se encuentran el sensor MAF, el sensor MAP, el sensor TPS, el sensor ECT y, de manera especial, el sensor de oxígeno o sensor lambda, encargado de medir la concentración de oxígeno presente en los gases de escape \citep{Bosch_Automotive, Fundamentos_Inyeccion}.

A partir de la señal proporcionada por el sensor lambda, la ECU puede implementar un control en lazo cerrado (\textit{closed loop}), mediante el cual corrige de forma dinámica la cantidad de combustible inyectado para mantener el valor de $\lambda$ cercano a 1. Este mecanismo mejora la eficiencia del motor, reduce el consumo de combustible y contribuye a la disminución de las emisiones contaminantes \citep{Bosch_GDI}.

Finalmente, diversos estudios han demostrado que un control preciso de la mezcla aire-combustible tiene un impacto significativo en la reducción de emisiones vehiculares y en la optimización del desempeño energético de los motores de combustión interna. En este sentido, el desarrollo de estrategias avanzadas de control electrónico ha permitido mejorar el funcionamiento del motor bajo diferentes condiciones de carga, velocidad y operación \citep{Combustion_Emissions_2020}.

\subsection{Relación del sistema de inyección con el consumo de combustible}

El sistema de inyección electrónica tiene una relación directa con el consumo de combustible, debido a que la cantidad de combustible suministrada al motor depende del tiempo de apertura del inyector. En este contexto, la duración del pulso de inyección constituye una variable fundamental para estimar el consumo instantáneo, ya que representa el tiempo durante el cual el inyector permanece abierto y permite el paso del combustible hacia la cámara de combustión \citep{article2020fuelconsumption}.

De acuerdo con el artículo de referencia, el consumo instantáneo puede determinarse a partir de la medición de la duración del pulso de inyección, estableciéndose una correlación muy alta entre ambas variables, con un coeficiente de 0,99 \cite{article2020fuelconsumption}. Esto indica que, al incrementarse el ancho del pulso, aumenta también la cantidad de combustible inyectado; por el contrario, una reducción del tiempo de apertura disminuye el caudal de combustible y, en consecuencia, el consumo del motor \citep{article2020fuelconsumption}.

\begin{figure}[h]
	\centering
	
	% 1. El caption automático estilo APA 7 (Título conciso arriba)
	\caption{Relación entre el sistema de inyección y el consumo de combustible}
	\label{fig:sistema_inyeccion}
	\vspace{0.3cm}
	
	% 2. La imagen ajustada proporcionalmente al ancho del texto
	
	\vspace{0.2cm}
	
	% 3. La nota de la figura según APA 7 (Con descripción técnica)
	\begin{flushleft}
		\footnotesize \textit{Nota.} Diagrama de bloques que ilustra cómo los parámetros medidos por la ECU (tiempo de inyección y flujo de masa de aire) impactan en el cálculo matemático del consumo instantáneo de combustible. Tomado de~\citep{Youtube_Inyeccion_2024}.
	\end{flushleft}
\end{figure}

La Figura \ref{fig:sistema_inyeccion} ilustra el proceso de adquisición y procesamiento de señales dentro del sistema de gestión del motor, donde las variables de entrada son procesadas por la unidad de control hasta generar la salida hacia el inyector. En particular, la señal de salida del pulso de inyección es el parámetro que permite regular la mezcla aire-combustible y, por tanto, influye de manera directa en el gasto de combustible durante la operación del motor \citep{article2020fuelconsumption}.

Por ello, el análisis del pulso de inyección resulta útil para estudiar el comportamiento real del motor bajo diferentes condiciones de operación, así como para evaluar estrategias orientadas a mejorar la eficiencia energética y reducir el consumo específico de combustible \citep{article2020fuelconsumption}.
%-------------------------2.6----------------
\section{Modelos matemáticos para el consumo del combustible}
\subsection{Concepto de consumo de combustible}

El consumo de combustible se define como la cantidad de combustible que utiliza un motor o vehículo para desarrollar un recorrido o mantener su operación durante un periodo determinado. Este parámetro constituye una de las variables más importantes en el análisis del desempeño automotriz, debido a que refleja de manera directa la eficiencia energética del sistema de propulsión y su impacto económico y ambiental \citep{PosadaHenao2016, EstimacionAlgoritmoUPS}.

Desde el punto de vista técnico, el consumo puede expresarse en términos de volumen o masa de combustible por unidad de distancia recorrida, como litros por cada 100 km (L/100 km), o por unidad de tiempo, como litros por hora (L/h), dependiendo del tipo de evaluación que se requiera \citep{PosadaHenao2016}. En motores de combustión interna, este indicador no solo depende de la demanda de potencia, sino también de las condiciones de operación del vehículo, tales como la velocidad, la carga, la pendiente del terreno, la resistencia aerodinámica y el estado del sistema de inyección \citep{ConsumoVehiculos2002, PosadaHenao2016}.

En términos generales, un menor consumo de combustible se asocia con una mejor eficiencia del motor, siempre que se mantengan condiciones adecuadas de potencia y funcionamiento. Sin embargo, este comportamiento puede variar en función de la estrategia de control del motor, la calidad de la combustión y las características del trayecto o ciclo de conducción \citep{EstimacionAlgoritmoUPS, ConsumoVehiculos2002}.

Por esta razón, el estudio del consumo de combustible constituye una base fundamental para el desarrollo de modelos matemáticos que permitan estimar, comparar y optimizar el desempeño de los motores en diferentes condiciones de operación \citep{PosadaHenao2016}.

\subsection{Métodos de estimación del consumo}

La estimación del consumo de combustible ha sido abordada mediante distintos enfoques matemáticos y experimentales, cuyo objetivo principal es determinar con precisión la cantidad de combustible utilizada por un vehículo durante su operación. En términos generales, estos métodos pueden clasificarse en modelos basados en variables de conducción, modelos fundamentados en parámetros del motor y modelos estadísticos o híbridos que combinan distintas señales del sistema vehicular \citep{EstimacionConsumoTransporte2004, EstimacionAlgoritmoUPS}.

Los modelos basados en variables de conducción utilizan información como la velocidad, la distancia recorrida, la aceleración y las condiciones de operación del vehículo para aproximar el consumo. Este tipo de enfoque resulta útil cuando no se dispone de acceso directo a variables internas del motor, aunque su precisión puede verse limitada por las variaciones propias del ciclo de conducción y por la topografía de la ruta \citep{ConsumoVehiculos2002, EstimacionConsumoTransporte2004}.

Por otro lado, los modelos basados en parámetros del motor emplean señales obtenidas desde la unidad de control electrónico o mediante el puerto OBD-II, tales como el flujo másico de aire (MAF), la posición del acelerador (TPS), las revoluciones por minuto (RPM) y la relación aire-combustible. Estos modelos presentan una mayor capacidad de representación del comportamiento real del motor, ya que incorporan variables directamente relacionadas con la formación de la mezcla y la entrega de combustible \citep{MAFFuelConsumption2024, ResearchOBD2018}.

Adicionalmente, existen métodos estadísticos y de aprendizaje automático que permiten construir relaciones empíricas entre variables de operación y consumo de combustible. Aunque estos enfoques pueden ofrecer buenos niveles de predicción, requieren bases de datos representativas y procesos de calibración adecuados para asegurar su validez en diferentes condiciones de uso \citep{EstimatingRegression2018, ResearchOBD2018}.

En este contexto en la Tabla \ref{tab:estim} se muestra, la selección del método de estimación depende de la disponibilidad de datos, el nivel de precisión requerido y la complejidad aceptable del modelo . Para aplicaciones en tiempo real, los modelos basados en sensores como el MAF representan una alternativa adecuada, debido a que permiten relacionar directamente la masa de aire admitida por el motor con la cantidad de combustible necesaria para mantener una combustión eficiente \citep{MAFFuelConsumption2024, Bosch_GDI}.

\begin{table}[h]
	\centering
	% Título separado bajo norma estricta APA 7
	\captionsetup{labelformat=simple, labelsep=newline, textfont=it, labelfont=bf}
	\caption{Comparación de métodos para la estimación del consumo de combustible}
	\label{tab:estim}
	\vspace{0.3cm}
	
	% Usamos tabularx para una distribución fluida y equilibrada de las columnas
	\begin{tabularx}{\linewidth}{p{2.5cm} X X X}
		\toprule % Línea superior APA 7
		\rowcolor[rgb]{0.851, 0.851, 0.851}
		\textbf{Método} & \textbf{Principio} & \textbf{Ventajas} & \textbf{Limitaciones} \\
		\midrule % Línea divisoria de encabezado APA 7
		Estadístico & Relaciona consumo con variables observables como velocidad o distancia. & Simple y económico. & Menor precisión en condiciones variables. \\
		\addlinespace
		Mecanicista & Usa fuerzas resistivas y demanda de potencia del vehículo. & Más físico y explicativo. & Requiere mayor cantidad de parámetros y calibración. \\
		\addlinespace
		Basado en sensores & Utiliza señales directas de la ECU como MAF, MAP, TPS o sonda lambda. & Ideal para la estimación y monitoreo en tiempo real. & Depende de la tasa de refresco y calidad de los sensores. \\
		\bottomrule % Línea inferior de cierre APA 7
	\end{tabularx}
	\vspace{0.2cm}
	
	\begin{flushleft}
		\footnotesize \textit{Nota.} Elaboración propia.
	\end{flushleft}
\end{table}

\subsection{Relación aire-combustible (AFR)}

La relación aire-combustible, conocida como \textit{Air-Fuel Ratio} (AFR), expresa la proporción existente entre la masa de aire y la masa de combustible que ingresan al cilindro durante el proceso de combustión. Este parámetro es fundamental en el análisis del funcionamiento de los motores de combustión interna, ya que determina la calidad de la mezcla y condiciona directamente la eficiencia térmica, el consumo de combustible y la generación de emisiones contaminantes \citep{AFRLambdaHPAcademy, AFRAnsed}.

En motores a gasolina, la relación estequiométrica de referencia es aproximadamente 14,7:1, lo que significa que se requieren 14,7 partes de aire por cada parte de combustible para lograr una combustión ideal \citep{AFRLambdaHPAcademy, Bosch_Automotive}. Bajo esta condición, el combustible puede oxidarse de manera más completa y se favorece el funcionamiento adecuado de los sistemas de postratamiento, como el convertidor catalítico.

Cuando la relación aire-combustible es inferior a la estequiométrica, la mezcla se considera rica, debido al exceso de combustible presente en la cámara de combustión. En este caso, aumenta la probabilidad de generar monóxido de carbono (CO) e hidrocarburos no quemados (HC), debido a una combustión incompleta \citep{AFRAnsed}. Por el contrario, cuando la relación aire-combustible es superior a la estequiométrica, la mezcla es pobre, lo que implica un exceso de aire. Esta condición puede disminuir el consumo de combustible, pero también puede afectar la potencia del motor y favorecer la formación de óxidos de nitrógeno (NO$_x$) \citep{AFRLambdaHPAcademy, Combustion_Emissions_2020}.

\begin{figure}[h]
	\centering
	
	% 1. El caption automático estilo APA 7 (Título conciso arriba)
	\caption{Curva estequiométrica del factor lambda y respuesta del sensor de oxígeno}
	\label{fig:factor_lambda}
	\vspace{0.3cm}
	
	% 2. La imagen ajustada proporcionalmente al ancho del texto
	
	\vspace{0.2cm}
	
	% 3. La nota de la figura según APA 7 (Con descripción técnica)
	\begin{flushleft}
		\footnotesize \textit{Nota.} Comportamiento de la señal de voltaje generada por el sensor de oxígeno en función del factor lambda, detallando las regiones de transición entre mezcla rica y mezcla pobre. Adaptado de~\citep{Fundamentos_Inyeccion}.
	\end{flushleft}
\end{figure}

La AFR está estrechamente relacionada con el factor lambda ($\lambda$), el cual permite expresar qué tan lejos se encuentra la mezcla real respecto de la condición estequiométrica ver Tabla \ref{tab:afr} En términos generales, el control de la AFR constituye una estrategia esencial para mantener una combustión eficiente y adaptar la entrega de combustible a las condiciones de carga, velocidad y demanda del motor \citep{Bosch_GDI, Fundamentos_Inyeccion}.

Para el cálculo final del consumo, es fundamental definir la relación aire-combustible ($AFR$), la cual se expresa como la proporción entre la masa de aire y la masa de combustible:

\begin{equation}
	AFR = \frac{m_{aire}}{m_{combustible}}
\end{equation}

En los sistemas de gestión modernos, esta relación se normaliza mediante el factor $\lambda$ (lambda), que relaciona el $AFR$ real medido por la sonda de oxígeno con el valor estequiométrico ideal:

\begin{equation}
	\lambda = \frac{AFR_{real}}{AFR_{estequiometrico}}
\end{equation}

Si $\lambda = 1$, la mezcla es estequiométrica; si $\lambda < 1$, la mezcla es rica (exceso de combustible), y si $\lambda > 1$, la mezcla es pobre (exceso de aire) ver Figura \ref{fig:factor_lambda}.

Por esta razón, el análisis de la relación aire-combustible es indispensable dentro de los modelos matemáticos de estimación del consumo de combustible, ya que permite vincular la cantidad de aire admitida con la masa de combustible requerida para sostener una operación eficiente del motor.

\begin{table}[htbp]
	\centering
	% Título separado bajo norma estricta APA 7
	\captionsetup{labelformat=simple, labelsep=newline, textfont=it, labelfont=bf}
	\caption{Interpretación de la relación aire-combustible y el factor lambda}
	\label{tab:afr}
	\vspace{0.3cm}
	
	% Usamos tabularx para un autoajuste milimétrico a los márgenes
	\begin{tabularx}{\linewidth}{p{3.8cm} p{2.8cm} p{2.2cm} X}
		\toprule % Línea superior APA 7
		\rowcolor[rgb]{0.851, 0.851, 0.851}
		\textbf{Condición} & \textbf{Relación AFR} & \textbf{Factor $\lambda$} & \textbf{Efecto principal y aplicación} \\
		\midrule % Línea divisoria de encabezado APA 7
		\textbf{Mezcla rica} & AFR $<$ 14,7:1 & $\lambda < 1$ & Mayor consumo de combustible y aumento de emisiones de CO y HC. Típica en aceleraciones a plena carga. \\
		\addlinespace
		\textbf{Mezcla estequiométrica} & AFR = 14,7:1 & $\lambda = 1$ & Combustión completa y eficiente, operación óptima del catalizador. Condición ideal de crucero. \\
		\addlinespace
		\textbf{Mezcla pobre} & AFR $>$ 14,7:1 & $\lambda > 1$ & Menor consumo de combustible, incremento de temperatura en la cámara y emisiones de NOx. \\
		\bottomrule % Línea inferior de cierre APA 7
	\end{tabularx}
	\vspace{0.2cm}
	
	\begin{flushleft}
		\footnotesize \textit{Nota.} Comportamiento físico-químico de la dosificación de la mezcla aire-combustible en motores de gasolina y su impacto en la eficiencia y emisiones. Elaboración propia.
	\end{flushleft}
\end{table}

\subsection{Modelo basado en el sensor MAF}

El sensor MAF (\textit{Mass Air Flow}) es uno de los sensores más importantes dentro de los sistemas modernos de inyección electrónica, debido a que permite medir la cantidad de aire que ingresa al motor. Esta información es utilizada por la unidad de control electrónico (ECU) para calcular la cantidad adecuada de combustible necesaria para mantener una combustión eficiente \citep{Bosch_Automotive, Fundamentos_Inyeccion}. 

El funcionamiento del sensor MAF se basa generalmente en el principio de hilo caliente (\textit{Hot Wire}). En este sistema, un filamento metálico es calentado eléctricamente a una temperatura constante. Cuando el aire atraviesa el conducto de admisión, enfría el filamento y provoca una variación en la corriente eléctrica necesaria para mantener la temperatura estable. La ECU interpreta esta variación como una medida del flujo de aire que entra al motor \citep{Hella_MAF, Bosch_GDI}.

La información proporcionada por el sensor MAF permite mejorar el control de la mezcla aire–combustible, optimizar el consumo de combustible y reducir emisiones contaminantes. Además, este sensor es ampliamente utilizado en estrategias de monitoreo y diagnóstico automotriz debido a que el flujo de aire está directamente relacionado con la cantidad de combustible consumida por el motor \citep{Fundamentos_Inyeccion}.

La Figura \ref{fig:maf_sensor} muestra la ubicación típica y el principio de funcionamiento de un sensor MAF dentro del sistema de admisión del motor.

\begin{figure}[h]
	\centering
	
	% 1. El caption automático estilo APA 7 (Título descriptivo arriba)
	\caption{Principio de funcionamiento eléctrico y térmico del sensor MAF}
	\label{fig:maf_sensor}
	\vspace{0.3cm}
	
	% 2. La imagen ajustada proporcionalmente al ancho del texto
	
	\vspace{0.2cm}
	
	% 3. La nota de la figura según APA 7 (Con descripción técnica)
	\begin{flushleft}
		\footnotesize \textit{Nota.} Diagrama del comportamiento del flujo de masa de aire sobre el elemento térmico (hilo caliente), ilustrando cómo la transferencia de calor altera la resistencia eléctrica y la señal de salida hacia la ECU. Adaptado de~\citep{Hella_MAF}.
	\end{flushleft}
\end{figure}

Uno de los métodos más utilizados para estimar el consumo de combustible en tiempo real consiste en emplear directamente la señal del sensor MAF. Este enfoque se basa en la relación estequiométrica aire–combustible, considerando que para motores a gasolina la mezcla ideal es aproximadamente 14,7:1 \citep{Bosch_Automotive}.

El consumo de combustible puede calcularse mediante la siguiente expresión:

\begin{equation}
	FuelConsumption_{(L/h)} = \frac{MAF_{(g/s)} \times 3600}{14{,}7 \times 745}
\end{equation}

En esta expresión, los valores constantes representan:
\begin{itemize}
	\item \textbf{3600}: Factor de conversión de segundos a horas.
	\item \textbf{14,7}: Relación aire-combustible estequiométrica ideal para la gasolina.
	\item \textbf{745}: Densidad aproximada de la gasolina en $g/L$ (este valor puede oscilar entre $720$ y $775$ $g/L$ según la temperatura y el octanaje).
\end{itemize}

donde:

Para el cálculo operativo en motores a gasolina, se asumen valores estándar que permiten simplificar la monitorización en tiempo real. En este modelo, se consideran las siguientes constantes:

\begin{equation}
	AFR_{estequiometrico} = 14{,}7
\end{equation}

\begin{equation}
	\rho_{fuel} \approx 750 \, \mathrm{g/L}
\end{equation}

Es importante destacar que la densidad de la gasolina es una variable sensible a la composición química, el porcentaje de aditivos y las condiciones ambientales. En el contexto de \textbf{Bolivia}, la gasolina comercial incorpora mezclas de bioetanol (como la Gasolina Especial Plus o la Súper Etanol), lo que puede generar variaciones en la densidad y en el poder calorífico respecto a las gasolinas convencionales puras \citep{ANH_Gasolina_87}.

Sustituyendo estos valores en la fórmula general, la ecuación de consumo instantáneo se simplifica mediante un factor de conversión aproximado:

\begin{equation}
	FuelConsumption_{(L/h)} \approx MAF_{(g/s)} \times 0{,}33
\end{equation}

\subsection{Ejemplo de Cálculo Instantáneo}

Para ilustrar la sensibilidad del modelo, se propone el siguiente escenario: si el sistema (vía sensores MAP+IAT o MAF) registra un flujo de masa de aire de $10 \, g/s$, el consumo instantáneo se calcula como:

\begin{equation}
	FuelConsumption = \frac{10 \times 3600}{14{,}7 \times 745}
\end{equation}

\begin{equation}
	FuelConsumption \approx 3{,}29 \, \mathrm{L/h}
\end{equation}

Este resultado permite al sistema de gestión o al usuario final visualizar el gasto volumétrico de combustible en función de la carga del motor en un momento determinado.

Este modelo permite obtener estimaciones relativamente precisas del consumo instantáneo de combustible utilizando únicamente información proveniente del sistema OBD-II. Debido a su simplicidad y facilidad de implementación, es ampliamente utilizado en aplicaciones de telemetría, monitoreo vehicular y análisis de eficiencia energética \citep{CSSElectronics_OBD2, Hella_MAF}.

En el presente proyecto, este modelo constituye una de las principales estrategias para estimar el consumo de combustible en tiempo real mediante la adquisición de datos desde la ECU del vehículo a través del protocolo OBD-II.

\subsection{El Método Speed-Density: Origen y Evolución}

El modelo basado en los sensores MAP e IAT es técnicamente denominado el método \textbf{Speed-Density} (Velocidad-Densidad). Recibe este nombre porque el flujo de masa de aire no se mide directamente, sino que se infiere a partir de la \textit{velocidad} del motor (RPM) y la \textit{densidad} del aire en el colector de admisión.

Aunque el concepto de densidad de gases se remonta a la termodinámica clásica, su aplicación en el control electrónico de motores (ECU) fue impulsada por la necesidad de cumplir con las normativas de emisiones contaminantes en la década de 1970.
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
