ErickCalle/Monitoreo-Consumo-Combustible-La-Paz-Bolivia/GLOSARIO/glosario.tex

% !TEX root = ../main.tex
\addcontentsline{toc}{section}{GLOSARIO Y LISTA DE ABREVIATURAS}
\begin{center}
	\textbf{\Large GLOSARIO Y LISTA DE ABREVIATURAS}
\end{center}
\vspace{4mm}

Se listan a continuación, en orden alfabético, las siglas y los términos técnicos empleados a lo largo del documento cuyo significado no siempre se repite en cada capítulo donde aparecen.
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
