ErickCalle/Monitoreo-Consumo-Combustible-La-Paz-Bolivia/Images/1.png

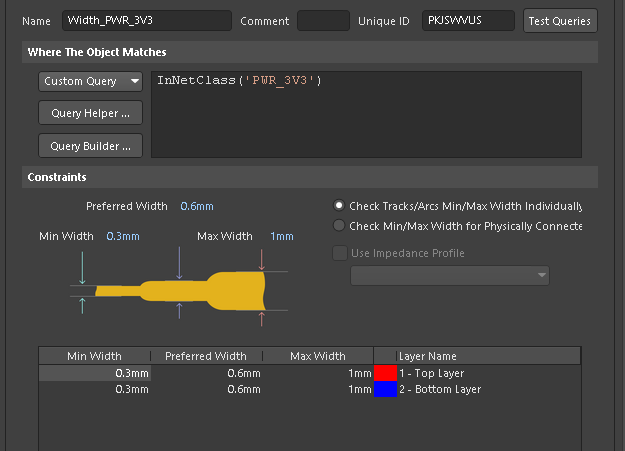
Images/1.png
