ErickCalle/Monitoreo-Consumo-Combustible-La-Paz-Bolivia/Images/2.png

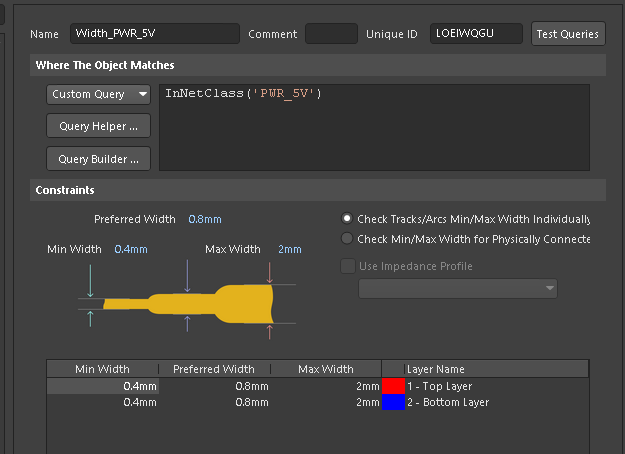
Images/2.png
