ErickCalle/Monitoreo-Consumo-Combustible-La-Paz-Bolivia/Images/3.png

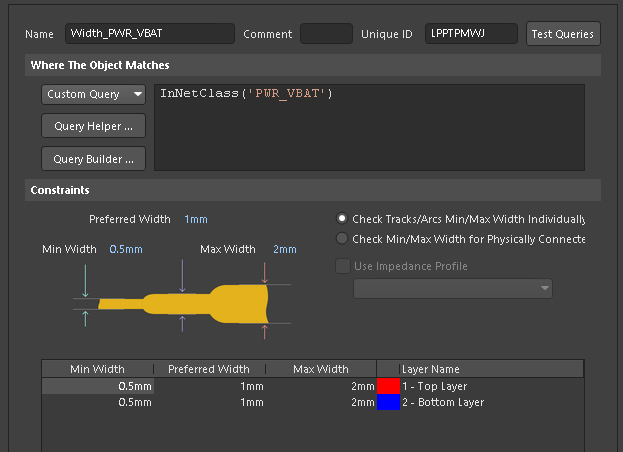
Images/3.png
