ErickCalle/Monitoreo-Consumo-Combustible-La-Paz-Bolivia/Images/3D.png

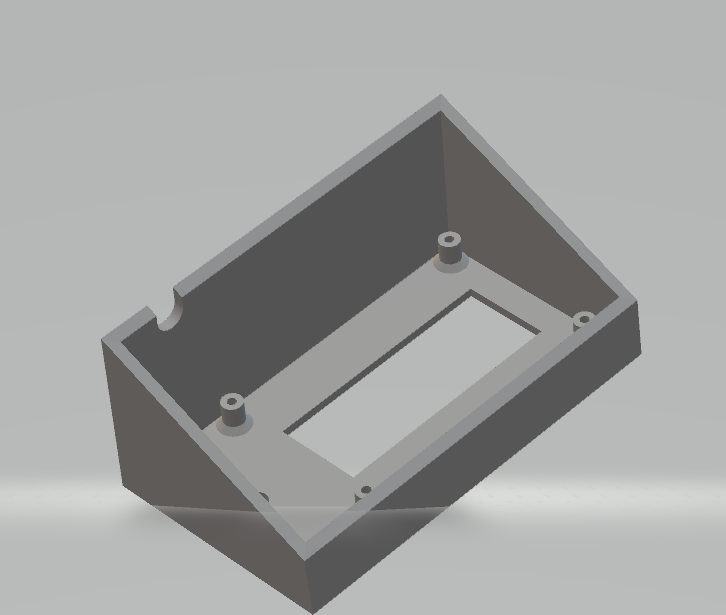
Images/3D.png
