ErickCalle/Monitoreo-Consumo-Combustible-La-Paz-Bolivia/Images/3D_PCB.png

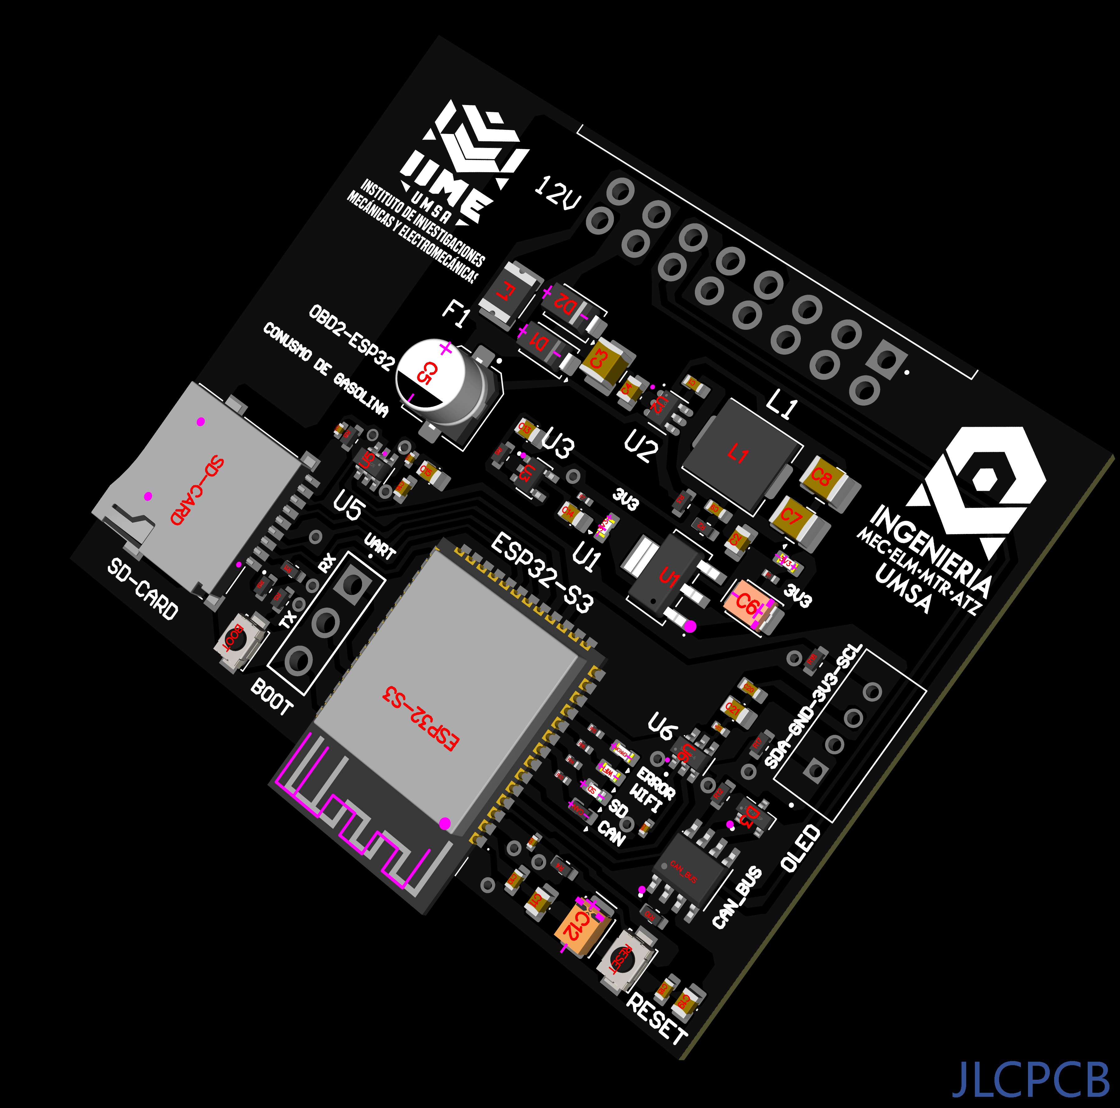
Images/3D_PCB.png
