ErickCalle/Monitoreo-Consumo-Combustible-La-Paz-Bolivia/Images/10.7_CHANGAN.png

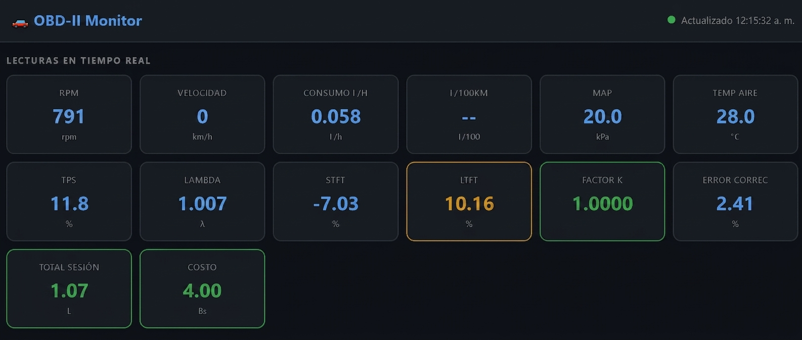
Images/10.7_CHANGAN.png
