ErickCalle/Monitoreo-Consumo-Combustible-La-Paz-Bolivia/Images/21.4 _NISSAN.png

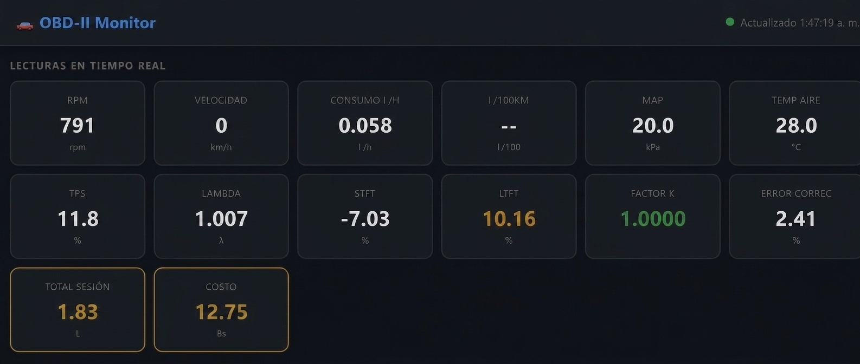
Images/21.4 _NISSAN.png
