ErickCalle/Monitoreo-Consumo-Combustible-La-Paz-Bolivia/Images/ALI.png

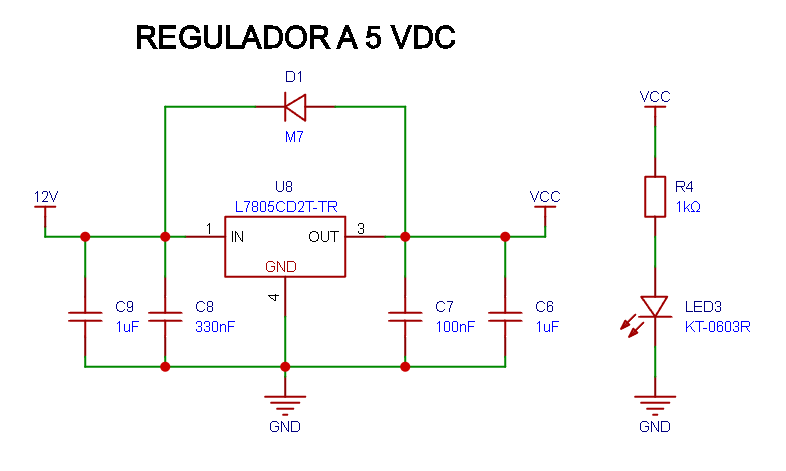
Images/ALI.png
