ErickCalle/Monitoreo-Consumo-Combustible-La-Paz-Bolivia/Images/ANH.png

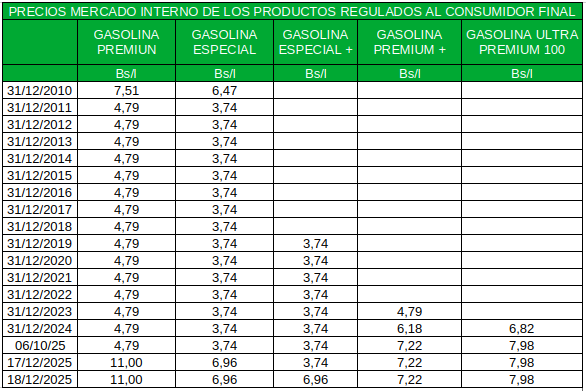
Images/ANH.png
