ErickCalle/Monitoreo-Consumo-Combustible-La-Paz-Bolivia/Images/BARRAS_CHANGAN.png

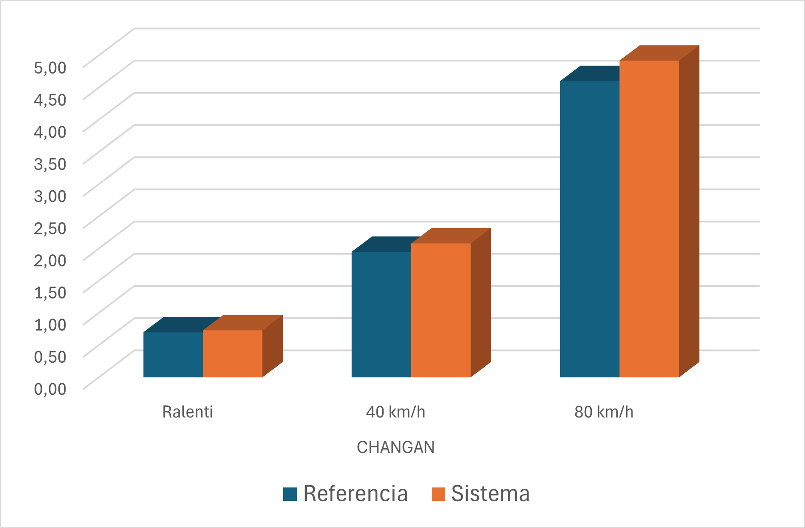
Images/BARRAS_CHANGAN.png
