ErickCalle/Monitoreo-Consumo-Combustible-La-Paz-Bolivia/Images/BDC.png

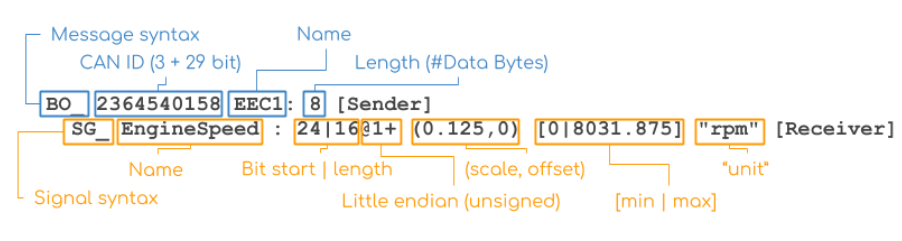
Images/BDC.png
