ErickCalle/Monitoreo-Consumo-Combustible-La-Paz-Bolivia/Images/botom.png

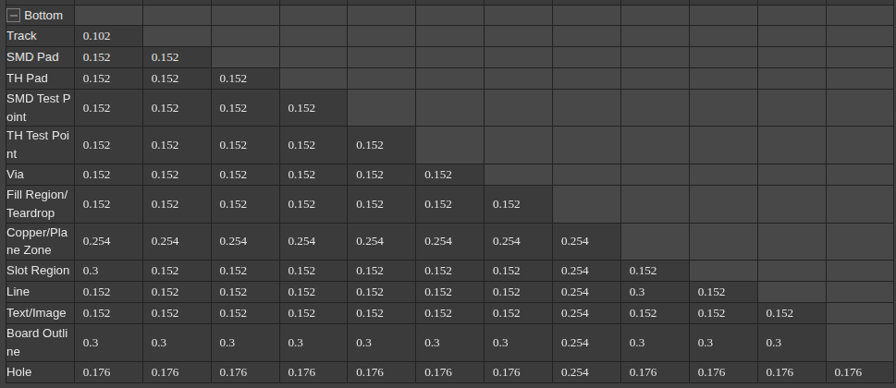
Images/botom.png
