ErickCalle/Monitoreo-Consumo-Combustible-La-Paz-Bolivia/Images/bottom_pcb_proto.jpeg

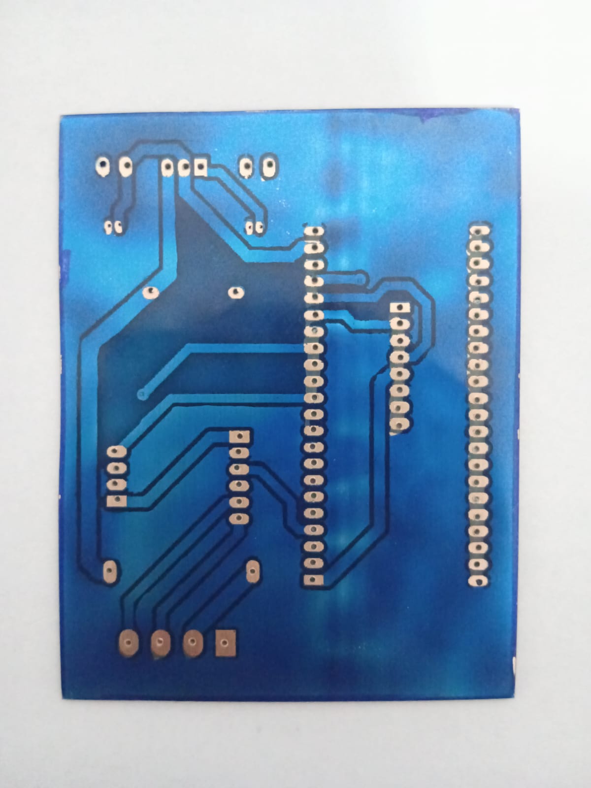
Images/bottom_pcb_proto.jpeg
