ErickCalle/Monitoreo-Consumo-Combustible-La-Paz-Bolivia/Images/can cable.png

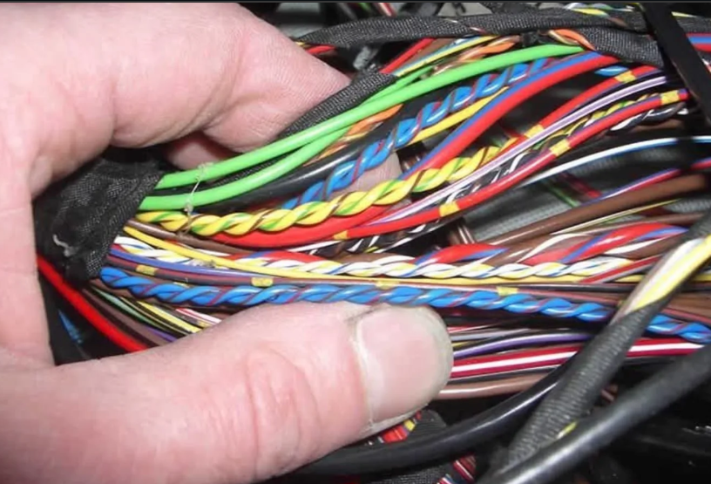
Images/can cable.png
