ErickCalle/Monitoreo-Consumo-Combustible-La-Paz-Bolivia/Images/CAN-Frame.png

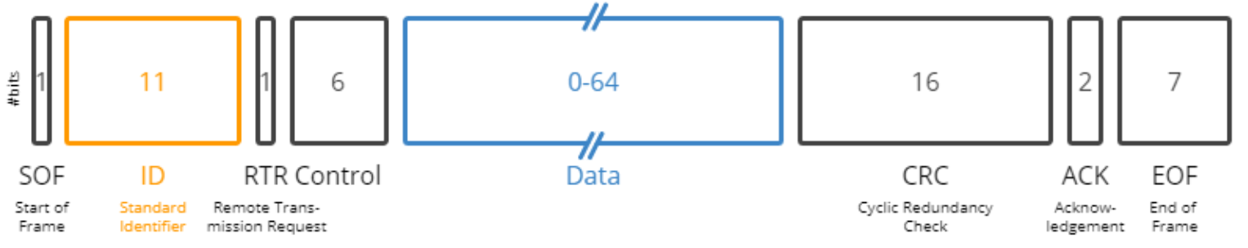
Images/CAN-Frame.png
