ErickCalle/Monitoreo-Consumo-Combustible-La-Paz-Bolivia/Images/CAN_B.png

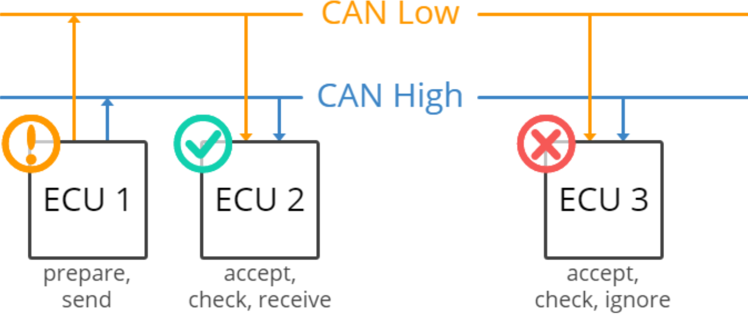
Images/CAN_B.png
