ErickCalle/Monitoreo-Consumo-Combustible-La-Paz-Bolivia/Images/can_bench.jpg

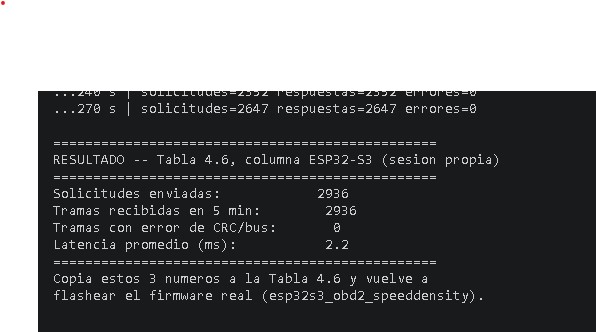
Images/can_bench.jpg
