ErickCalle/Monitoreo-Consumo-Combustible-La-Paz-Bolivia/Images/Can_Volt.png

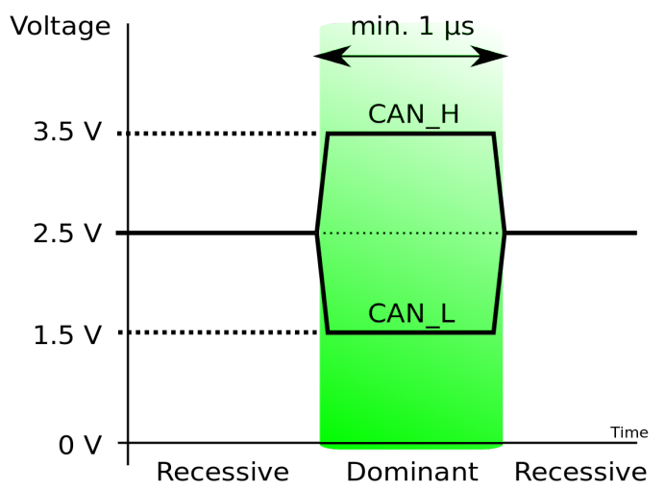
Images/Can_Volt.png
