ErickCalle/Monitoreo-Consumo-Combustible-La-Paz-Bolivia/Images/CANBUS.png

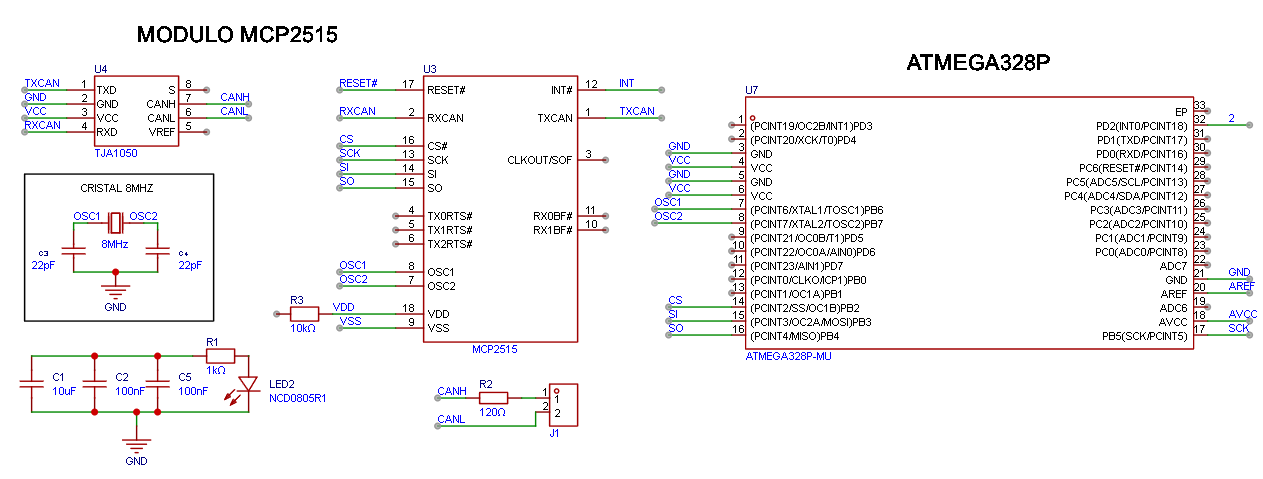
Images/CANBUS.png
