ErickCalle/Monitoreo-Consumo-Combustible-La-Paz-Bolivia/Images/Captura de pantalla 2026-03-07 124207.png

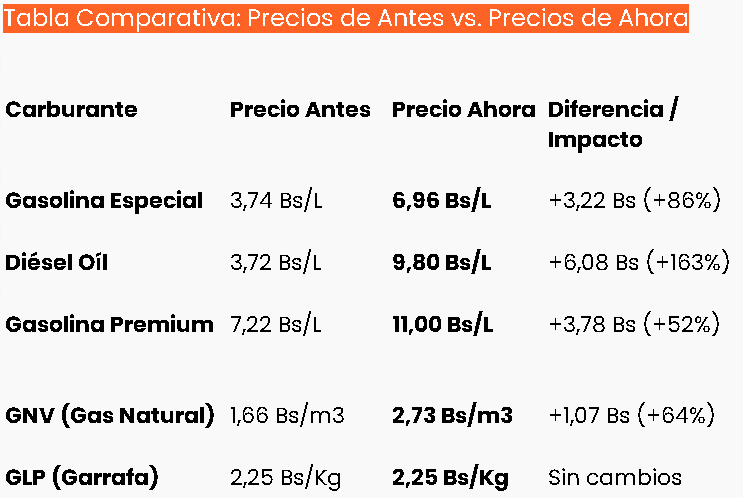
Images/Captura de pantalla 2026-03-07 124207.png
