ErickCalle/Monitoreo-Consumo-Combustible-La-Paz-Bolivia/Images/capturaCAN.png

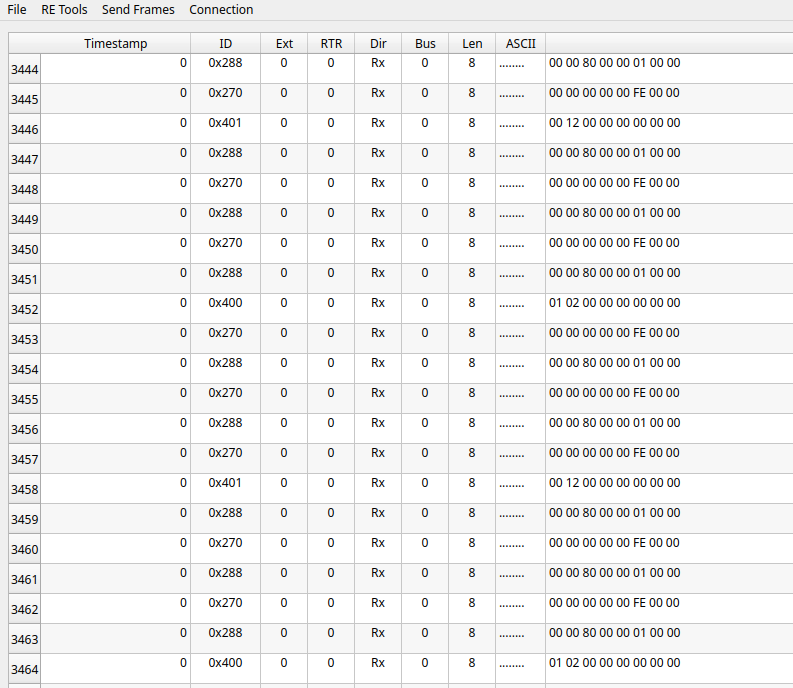
Images/capturaCAN.png
