ErickCalle/Monitoreo-Consumo-Combustible-La-Paz-Bolivia/Images/CARCASA_3D.jpg

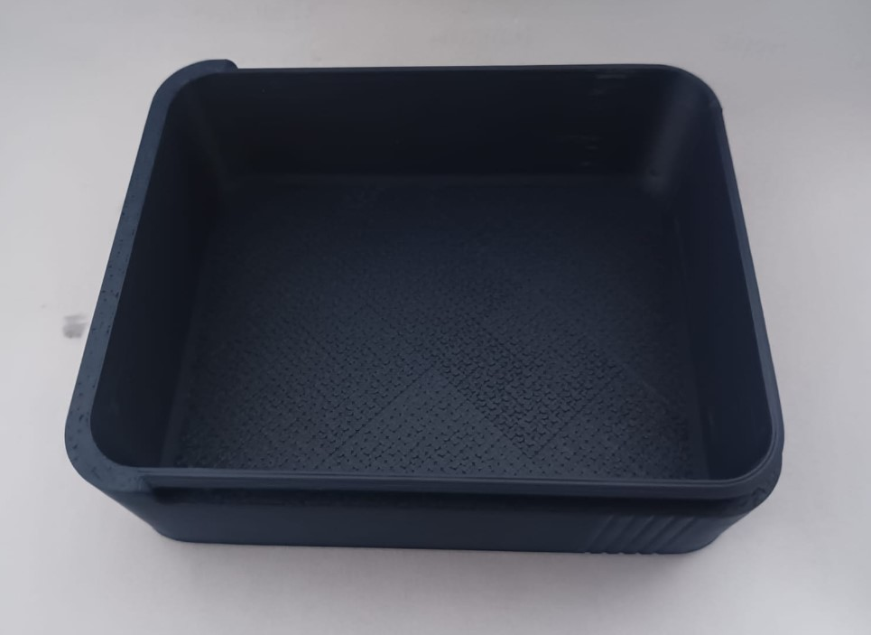
Images/CARCASA_3D.jpg
