ErickCalle/Monitoreo-Consumo-Combustible-La-Paz-Bolivia/Images/CASE3D.png

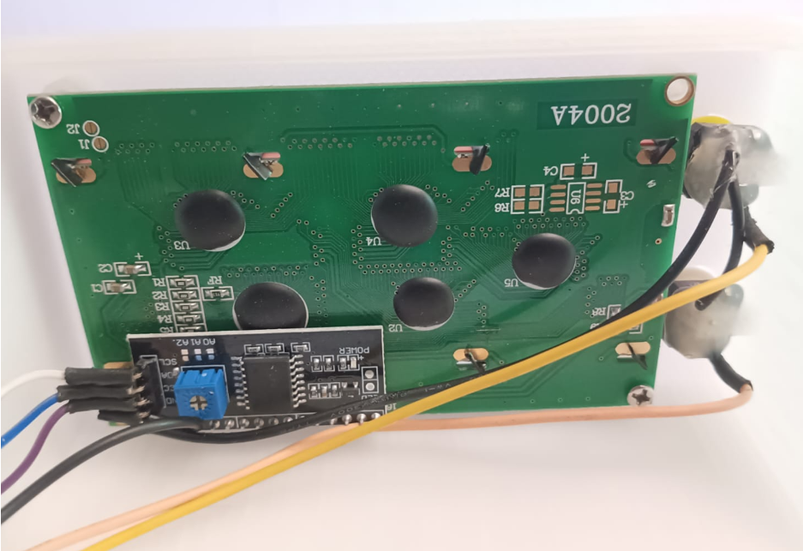
Images/CASE3D.png
