ErickCalle/Monitoreo-Consumo-Combustible-La-Paz-Bolivia/Images/changan.png

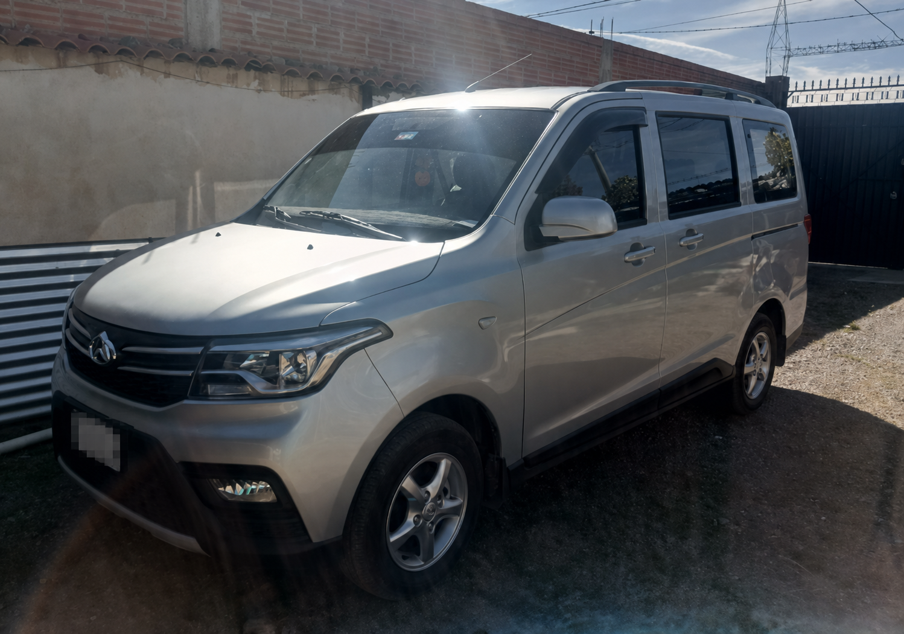
Images/changan.png
