ErickCalle/Monitoreo-Consumo-Combustible-La-Paz-Bolivia/Images/ChatGPT.png

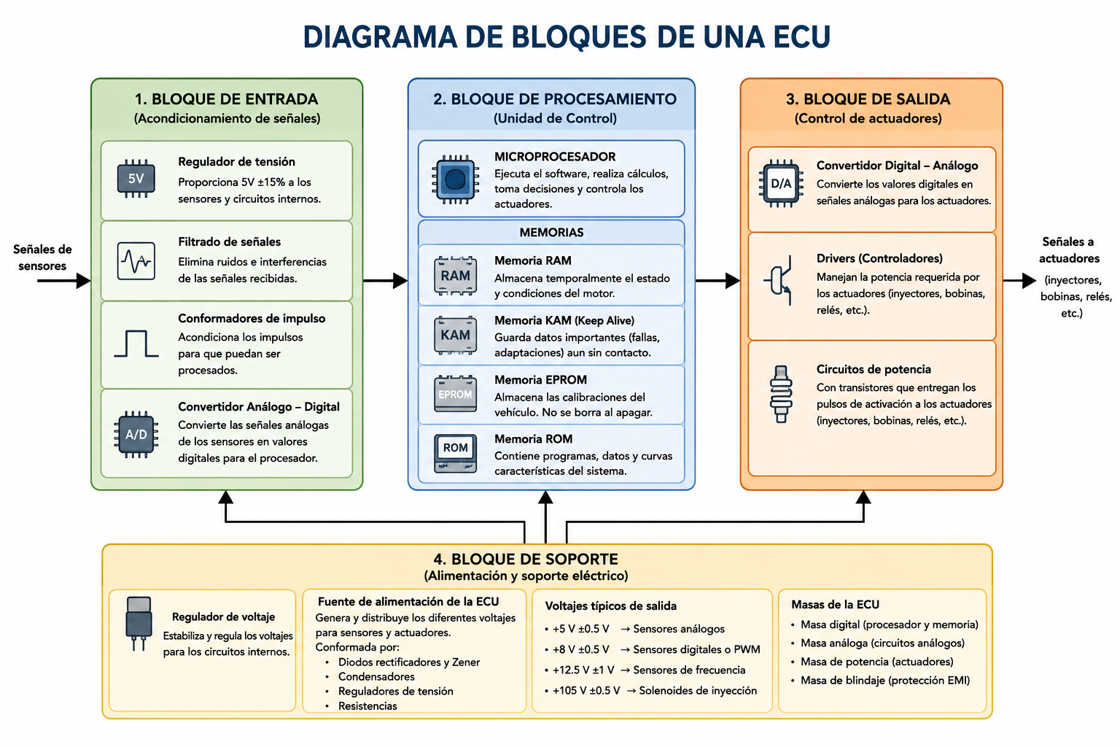
Images/ChatGPT.png
