ErickCalle/Monitoreo-Consumo-Combustible-La-Paz-Bolivia/Images/combu.png

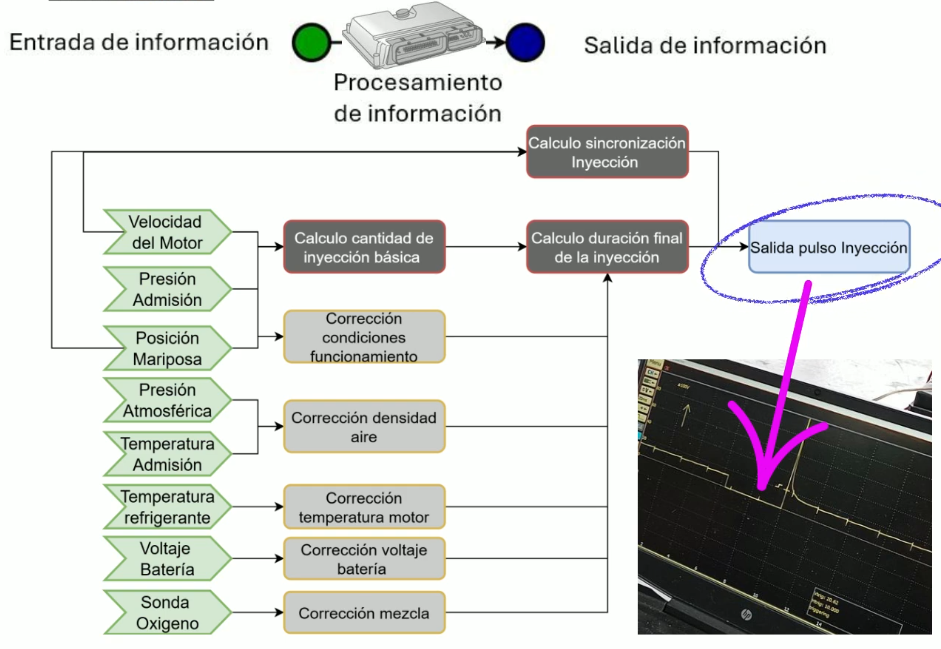
Images/combu.png
