ErickCalle/Monitoreo-Consumo-Combustible-La-Paz-Bolivia/Images/COMESP32.png

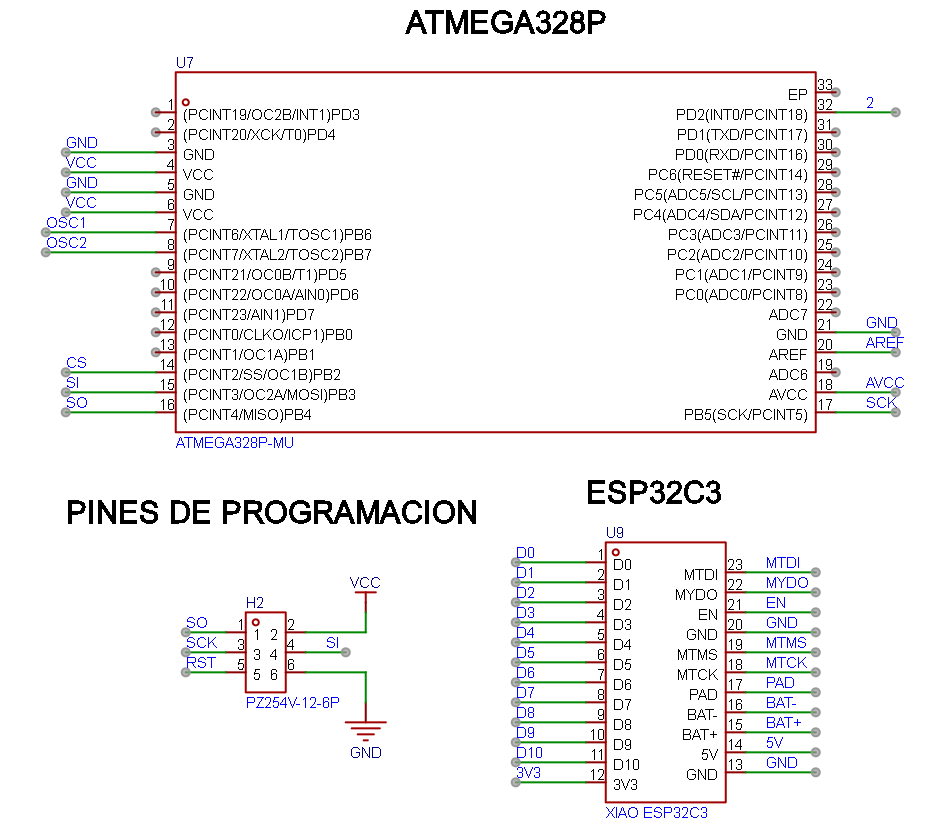
Images/COMESP32.png
