ErickCalle/Monitoreo-Consumo-Combustible-La-Paz-Bolivia/Images/COMPA.png

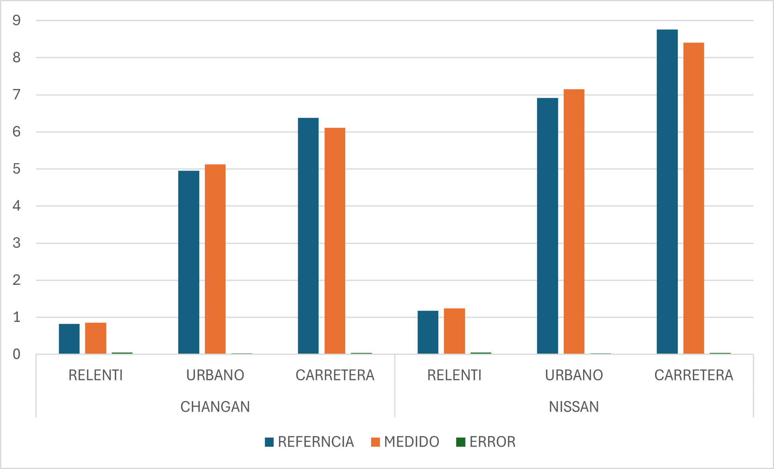
Images/COMPA.png
