ErickCalle/Monitoreo-Consumo-Combustible-La-Paz-Bolivia/Images/compo.jpeg

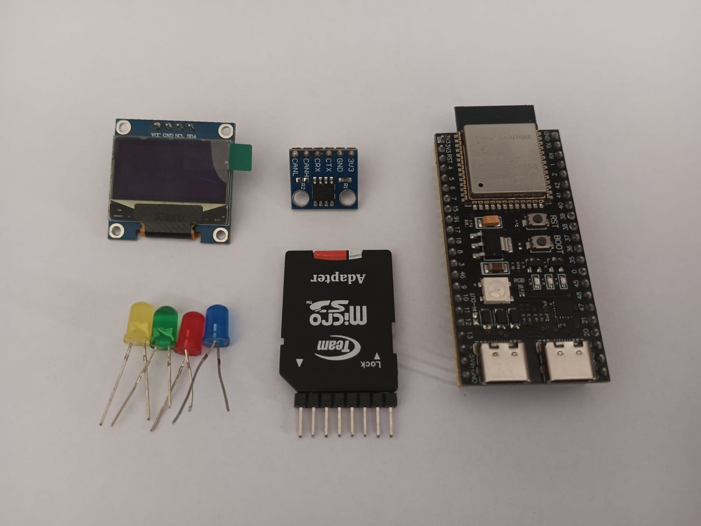
Images/compo.jpeg
