ErickCalle/Monitoreo-Consumo-Combustible-La-Paz-Bolivia/Images/Conbu.png

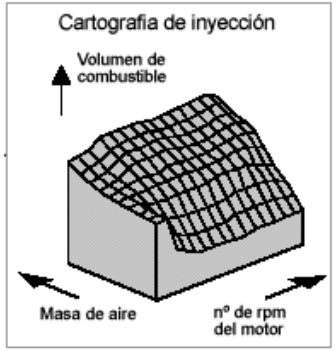
Images/Conbu.png
