ErickCalle/Monitoreo-Consumo-Combustible-La-Paz-Bolivia/Images/CONCAN.png

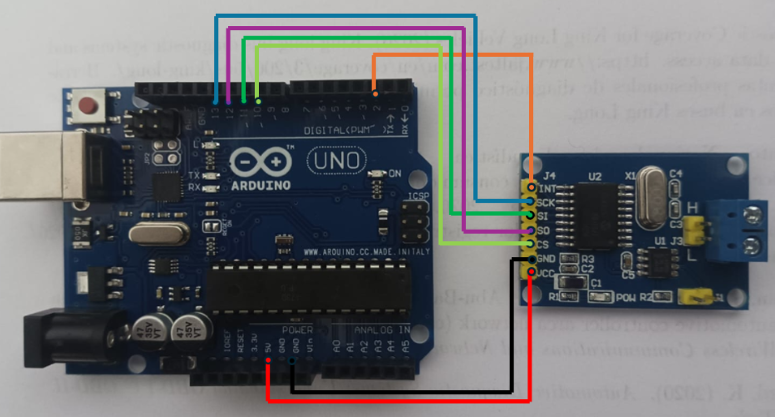
Images/CONCAN.png
