ErickCalle/Monitoreo-Consumo-Combustible-La-Paz-Bolivia/Images/CONETION FISICA.png

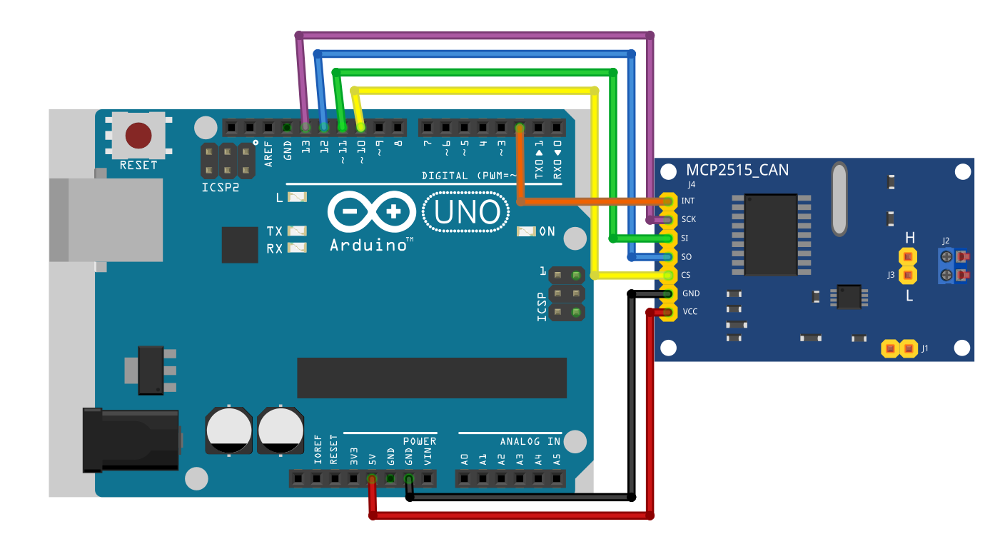
Images/CONETION FISICA.png
