ErickCalle/Monitoreo-Consumo-Combustible-La-Paz-Bolivia/Images/CONETION.png

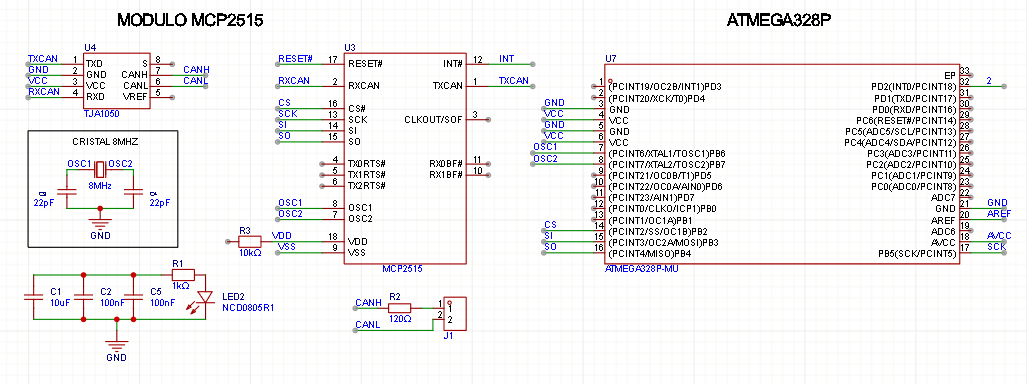
Images/CONETION.png
