ErickCalle/Monitoreo-Consumo-Combustible-La-Paz-Bolivia/Images/CONEXION FINAL F.png

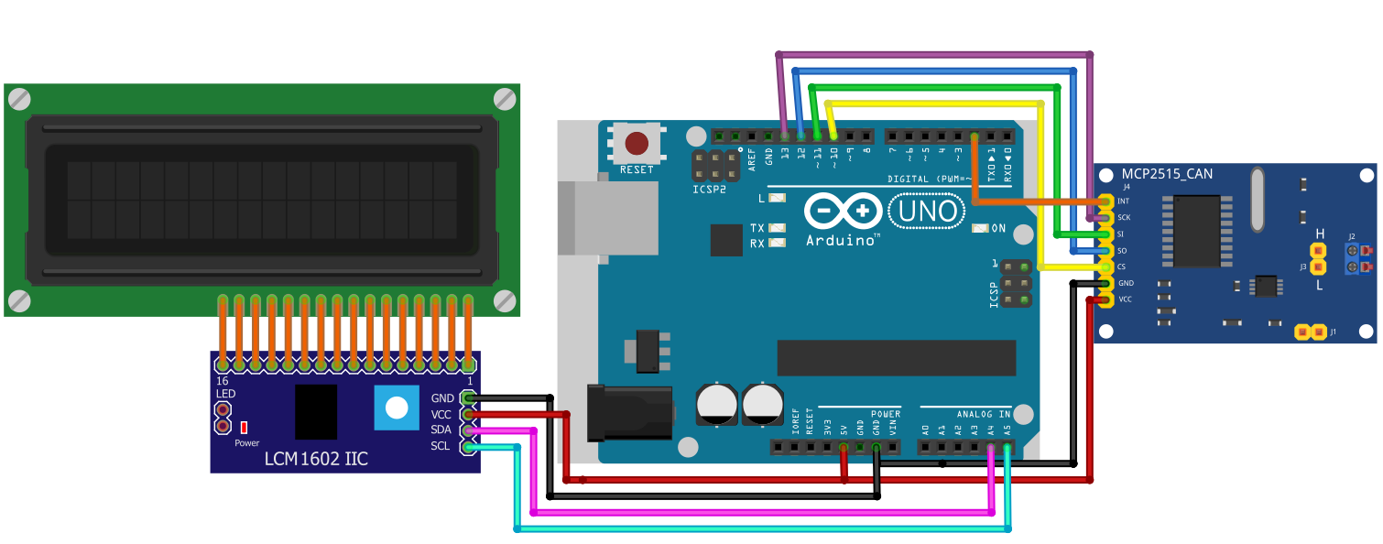
Images/CONEXION FINAL F.png
