ErickCalle/Monitoreo-Consumo-Combustible-La-Paz-Bolivia/Images/CONEXION.png

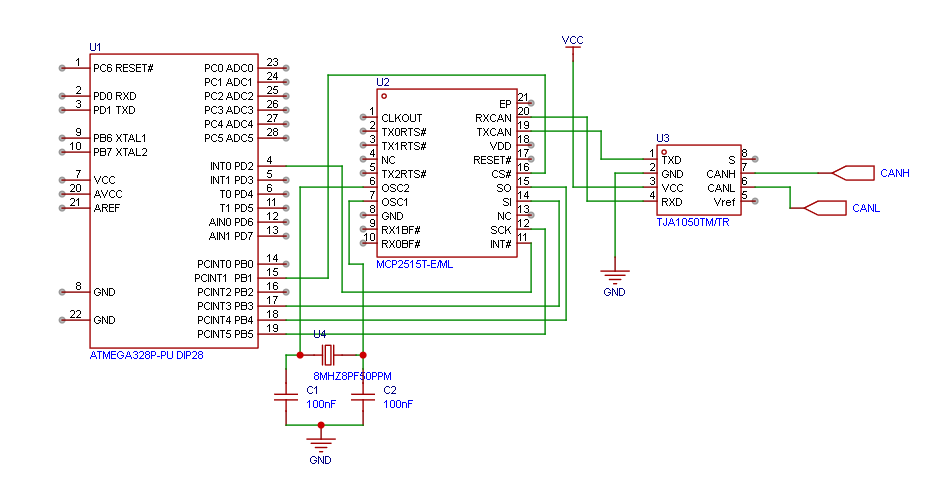
Images/CONEXION.png
