ErickCalle/Monitoreo-Consumo-Combustible-La-Paz-Bolivia/Images/CONSUMO_CHANGAN.png

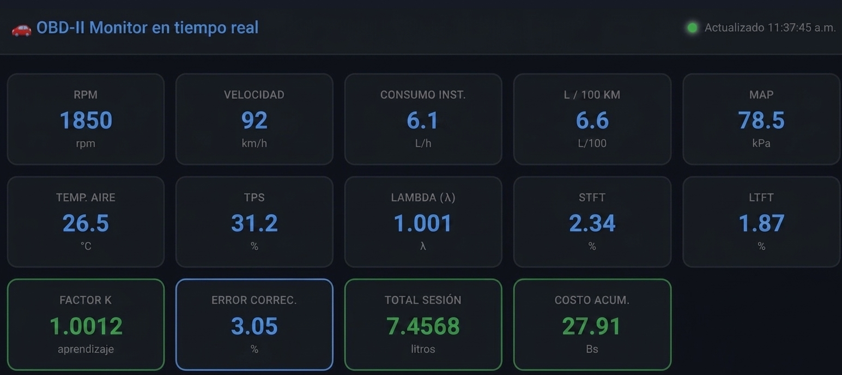
Images/CONSUMO_CHANGAN.png
