ErickCalle/Monitoreo-Consumo-Combustible-La-Paz-Bolivia/Images/CONSUMO_NISSAN.png

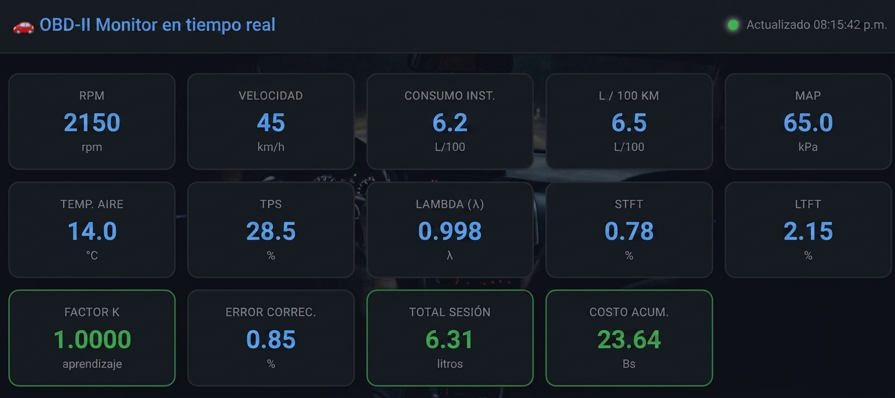
Images/CONSUMO_NISSAN.png
