ErickCalle/Monitoreo-Consumo-Combustible-La-Paz-Bolivia/Images/CONTROL.png

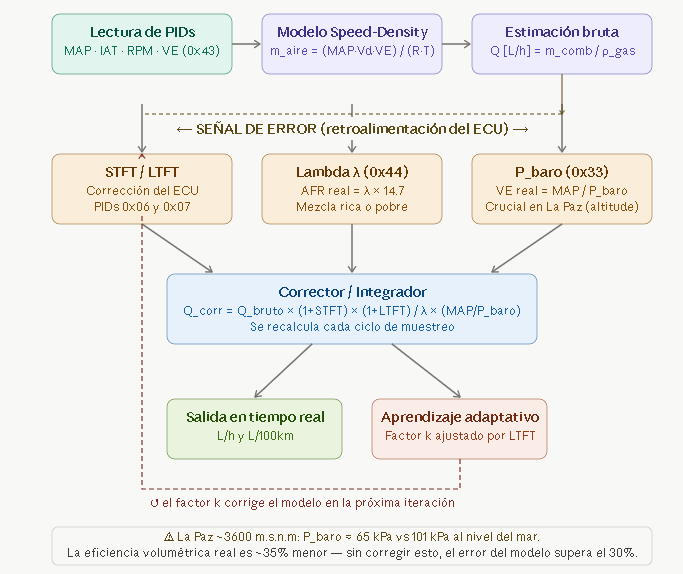
Images/CONTROL.png
