ErickCalle/Monitoreo-Consumo-Combustible-La-Paz-Bolivia/Images/CORTO.jpg

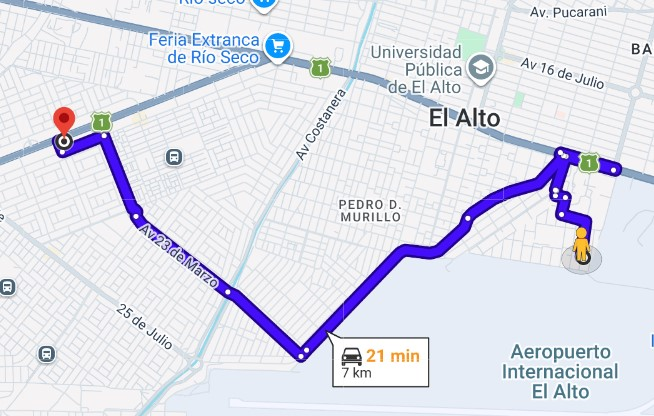
Images/CORTO.jpg
