ErickCalle/Monitoreo-Consumo-Combustible-La-Paz-Bolivia/Images/dashboard.png

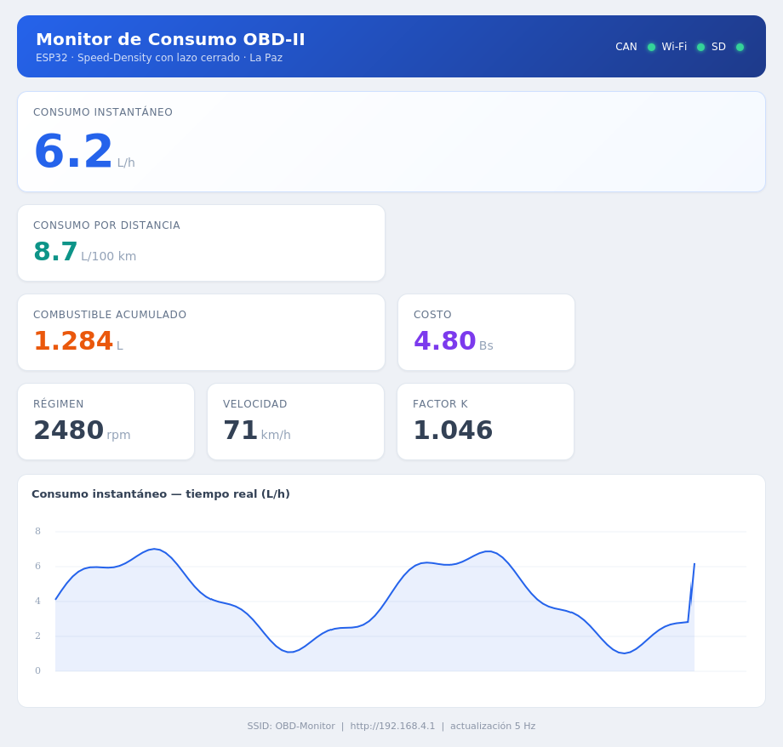
Images/dashboard.png
