ErickCalle/Monitoreo-Consumo-Combustible-La-Paz-Bolivia/Images/DIAGRAM.png

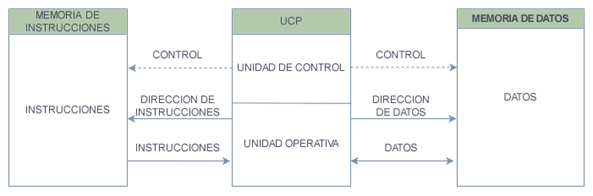
Images/DIAGRAM.png
