ErickCalle/Monitoreo-Consumo-Combustible-La-Paz-Bolivia/Images/Diagrama.png

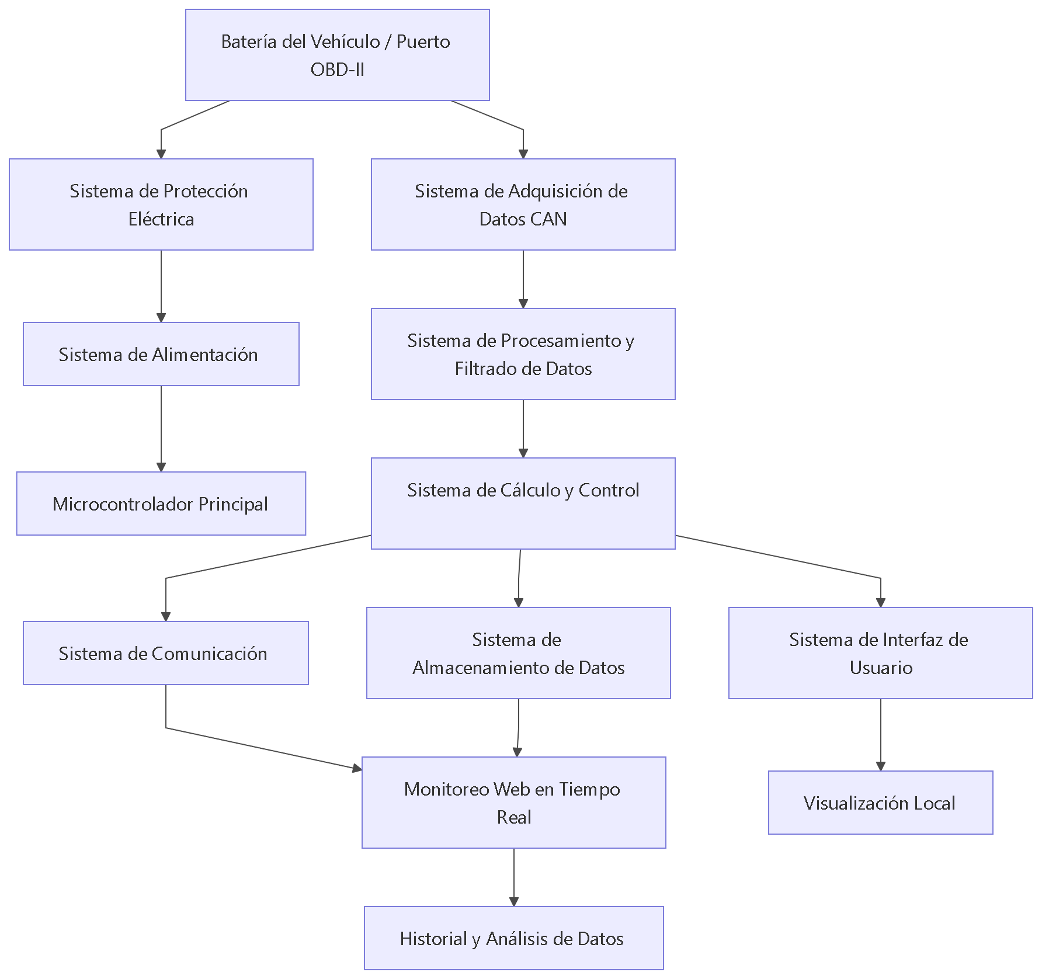
Images/Diagrama.png
