ErickCalle/Monitoreo-Consumo-Combustible-La-Paz-Bolivia/Images/dimension.png

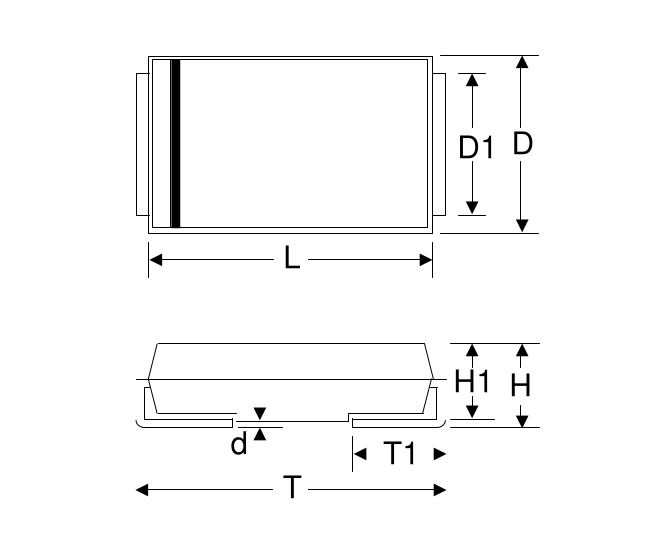
Images/dimension.png
