ErickCalle/Monitoreo-Consumo-Combustible-La-Paz-Bolivia/Images/divisor_tension.png

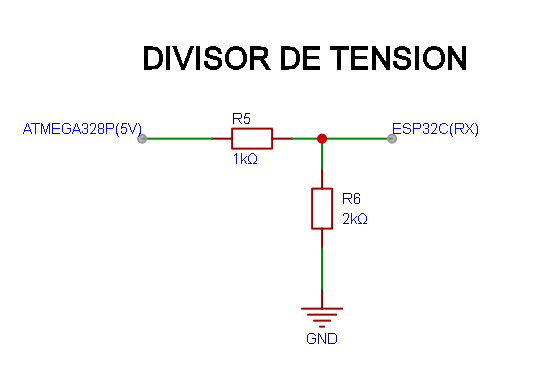
Images/divisor_tension.png
