ErickCalle/Monitoreo-Consumo-Combustible-La-Paz-Bolivia/Images/dominios_ecu.png

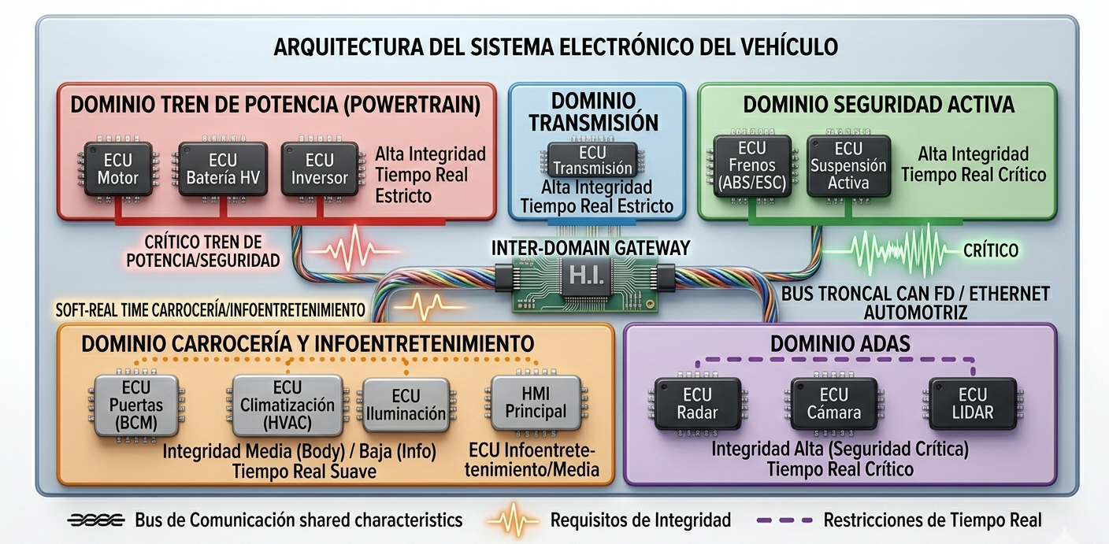
Images/dominios_ecu.png
