ErickCalle/Monitoreo-Consumo-Combustible-La-Paz-Bolivia/Images/ECU.png

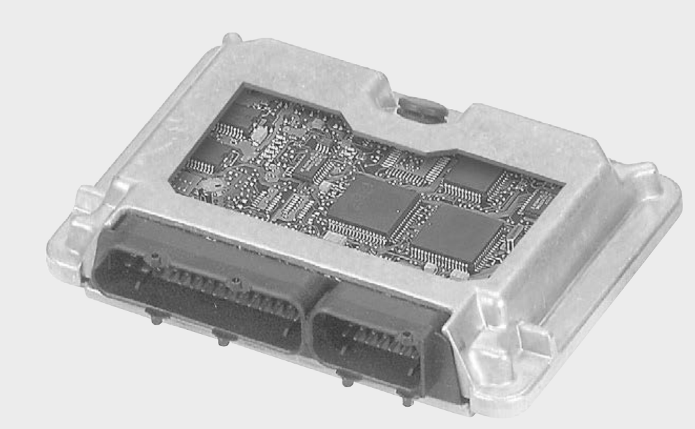
Images/ECU.png
