ErickCalle/Monitoreo-Consumo-Combustible-La-Paz-Bolivia/Images/elm327.jpg

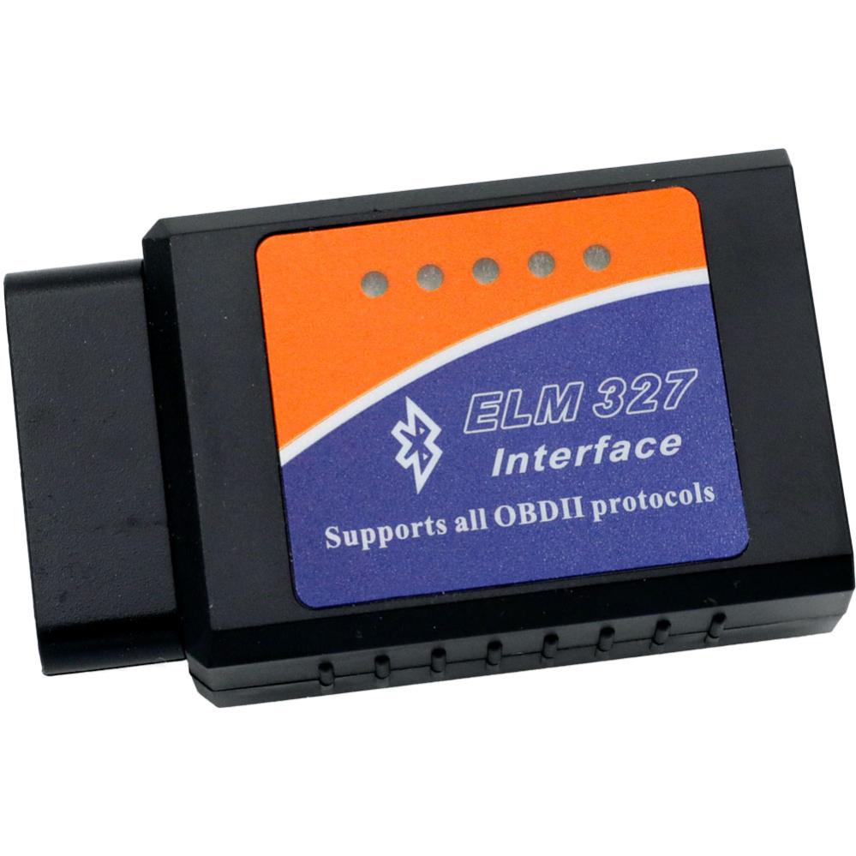
Images/elm327.jpg
