ErickCalle/Monitoreo-Consumo-Combustible-La-Paz-Bolivia/Images/elm327_bench.jpg

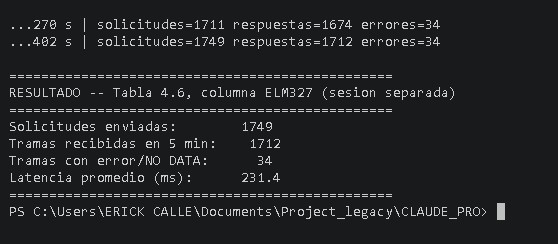
Images/elm327_bench.jpg
