ErickCalle/Monitoreo-Consumo-Combustible-La-Paz-Bolivia/Images/Error.png

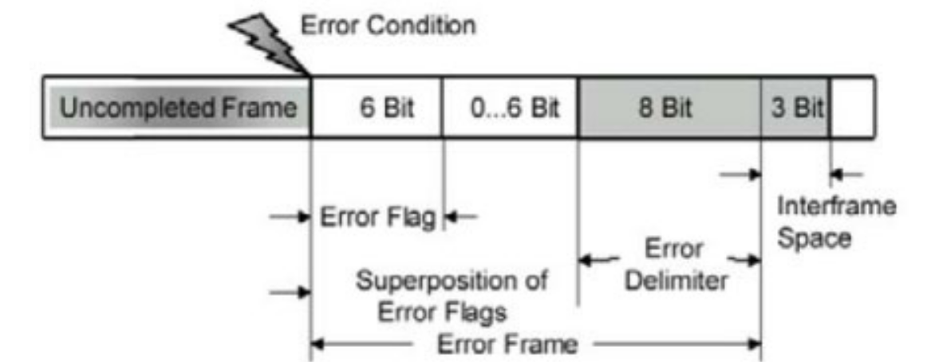
Images/Error.png
