ErickCalle/Monitoreo-Consumo-Combustible-La-Paz-Bolivia/Images/ERROR_MEDIO.png

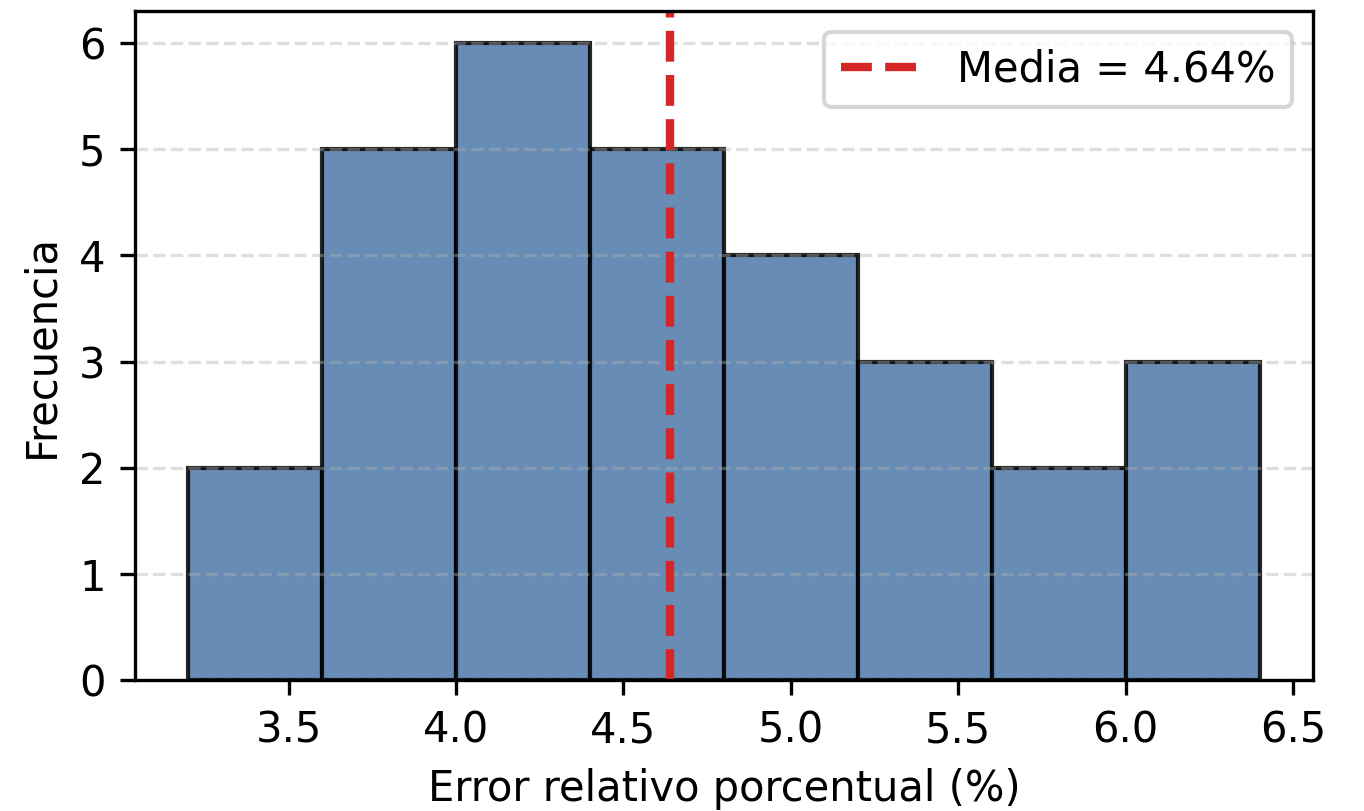
Images/ERROR_MEDIO.png
