ErickCalle/Monitoreo-Consumo-Combustible-La-Paz-Bolivia/Images/ERROR_RELA.png

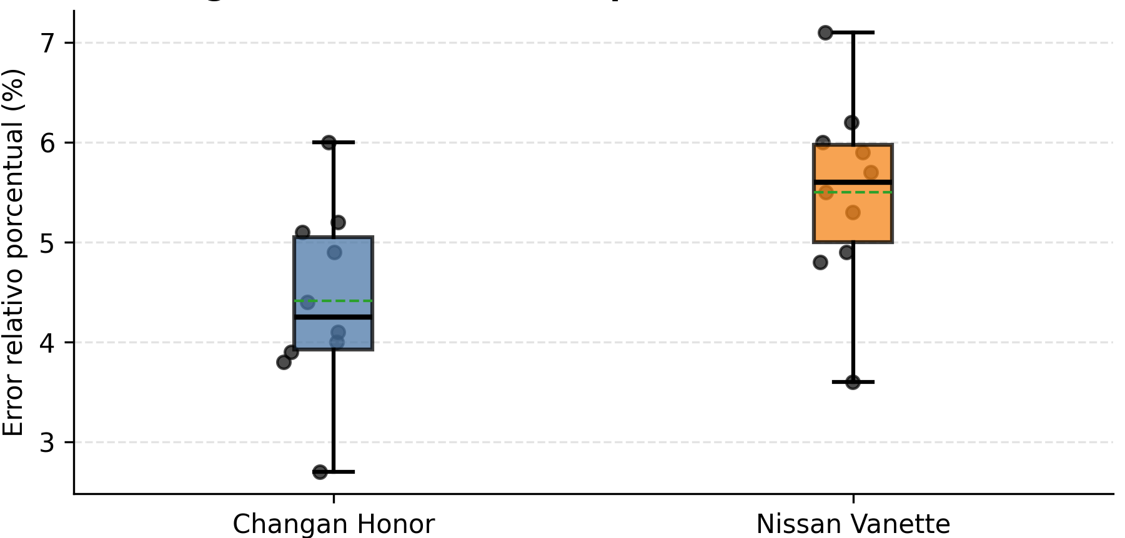
Images/ERROR_RELA.png
