ErickCalle/Monitoreo-Consumo-Combustible-La-Paz-Bolivia/Images/escaner.png

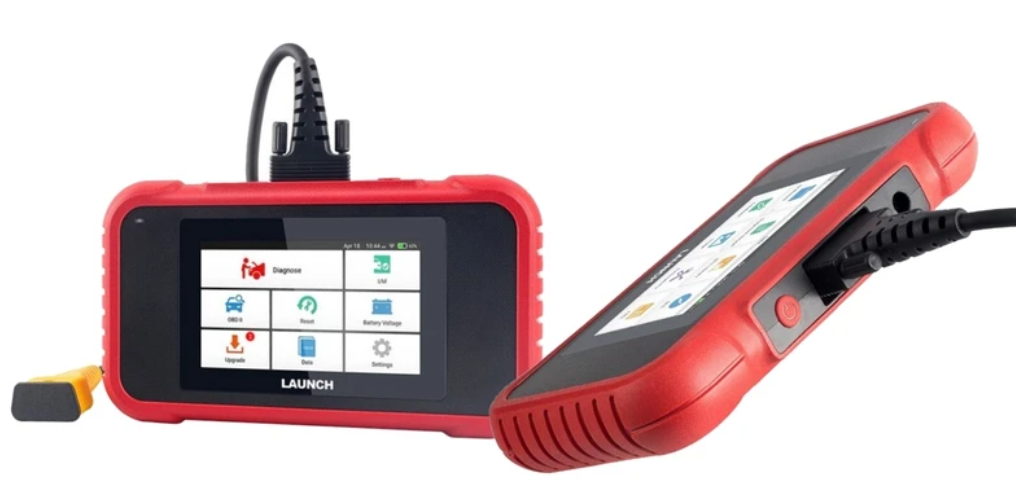
Images/escaner.png
