ErickCalle/Monitoreo-Consumo-Combustible-La-Paz-Bolivia/Images/esp32.png

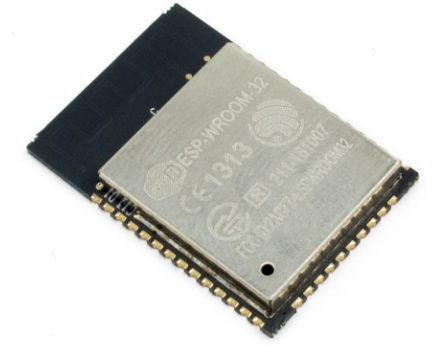
Images/esp32.png
