ErickCalle/Monitoreo-Consumo-Combustible-La-Paz-Bolivia/Images/esp32_conexion_optima.png

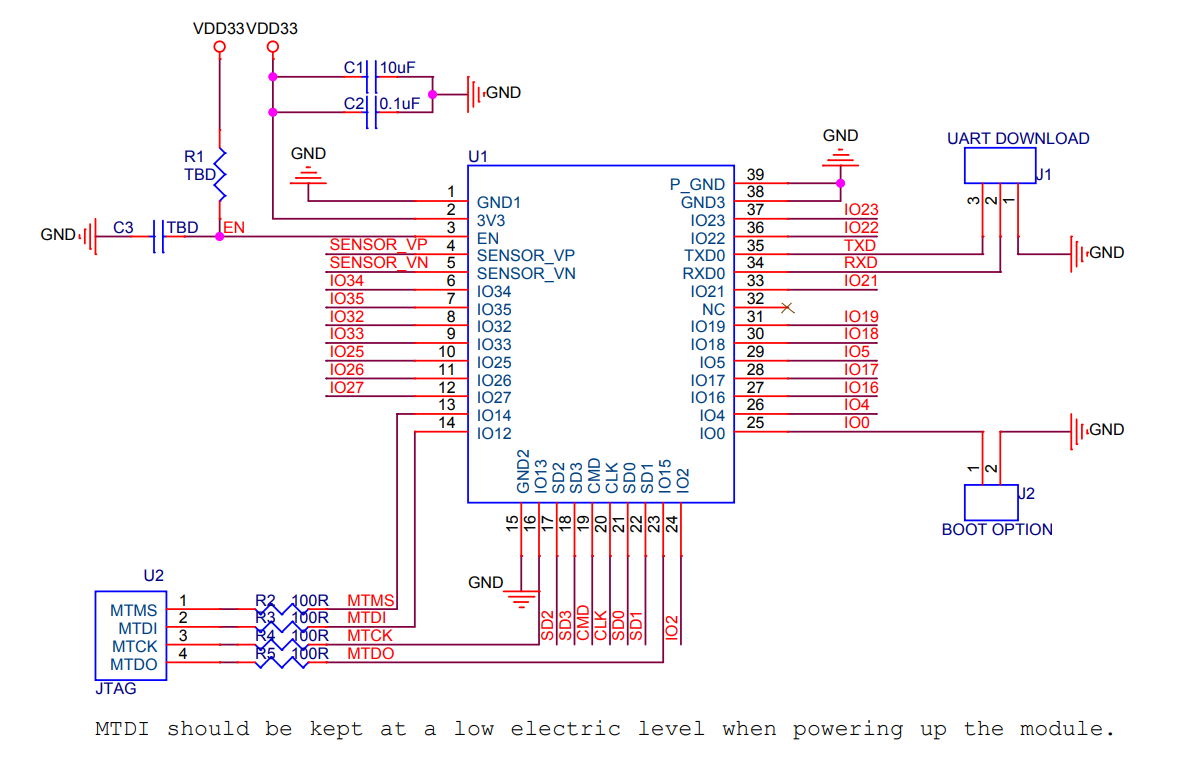
Images/esp32_conexion_optima.png
