ErickCalle/Monitoreo-Consumo-Combustible-La-Paz-Bolivia/Images/ESP32_FINAL.png

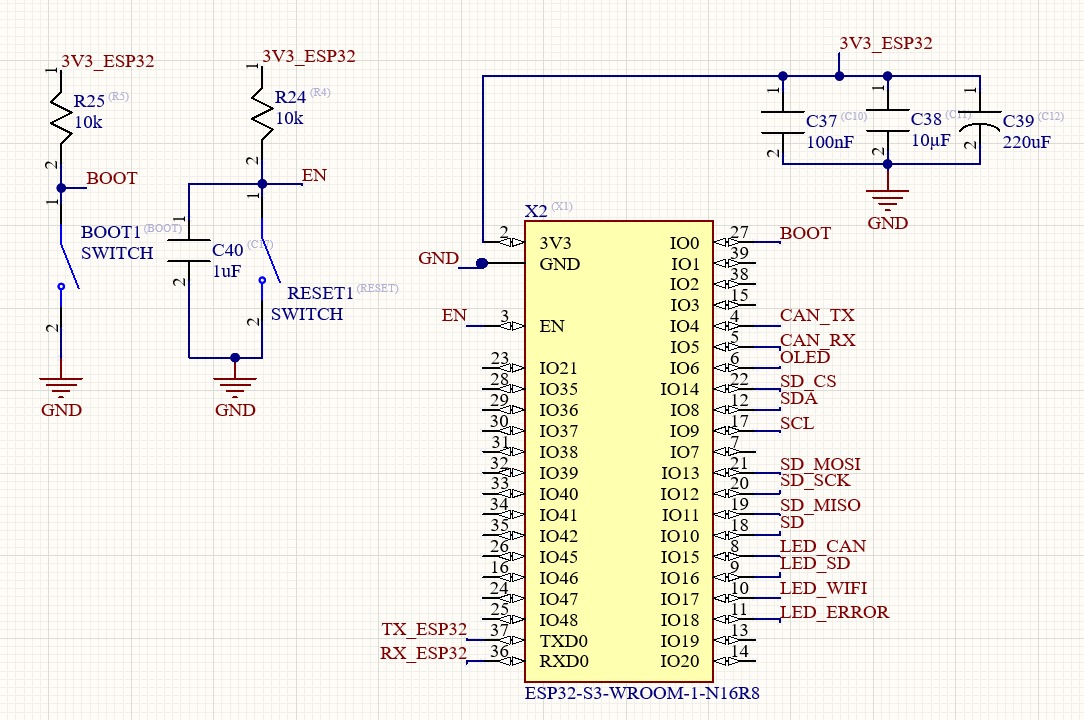
Images/ESP32_FINAL.png
