ErickCalle/Monitoreo-Consumo-Combustible-La-Paz-Bolivia/Images/esquema-inyeccion-golf.jpg

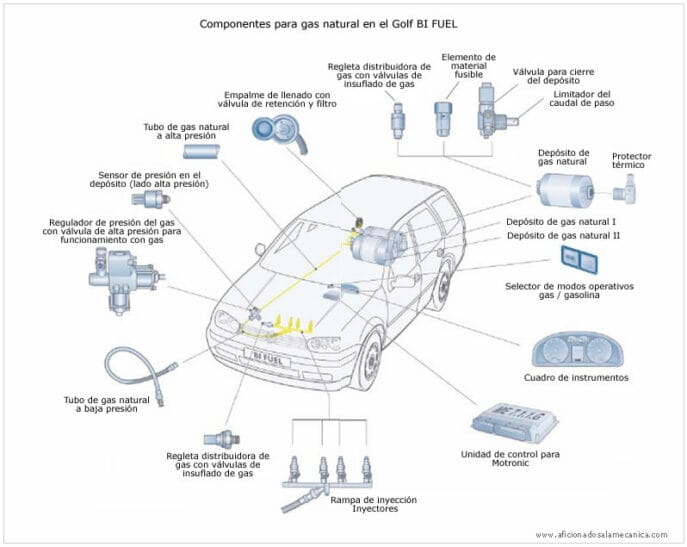
Images/esquema-inyeccion-golf.jpg
