ErickCalle/Monitoreo-Consumo-Combustible-La-Paz-Bolivia/Images/ESQUEMA_GENERAL.png

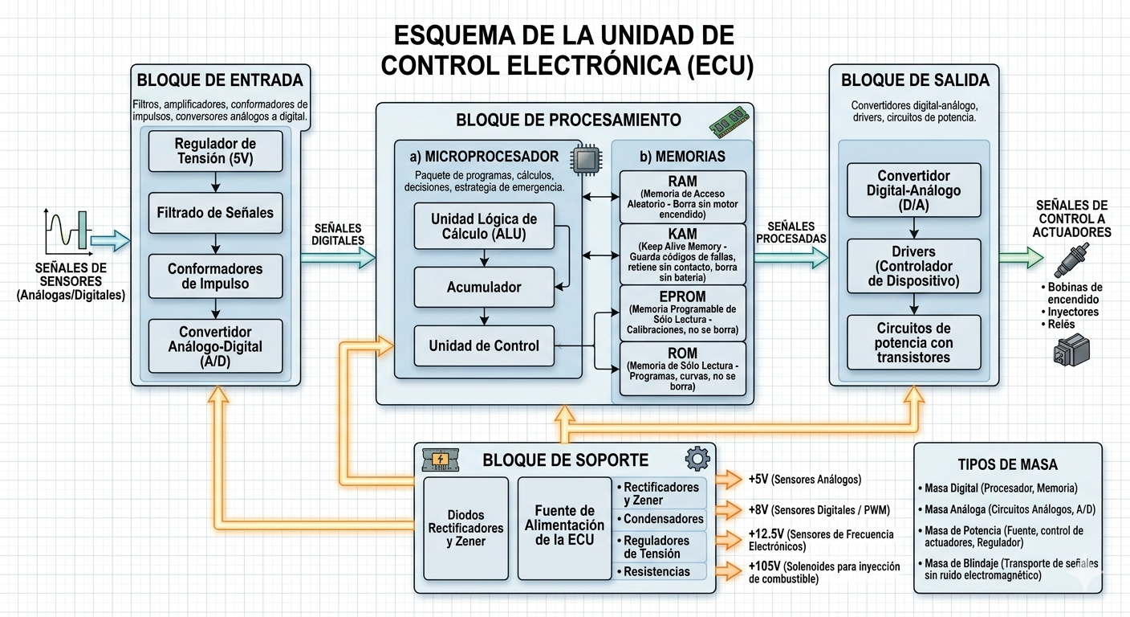
Images/ESQUEMA_GENERAL.png
