ErickCalle/Monitoreo-Consumo-Combustible-La-Paz-Bolivia/Images/esquema_obd2.png

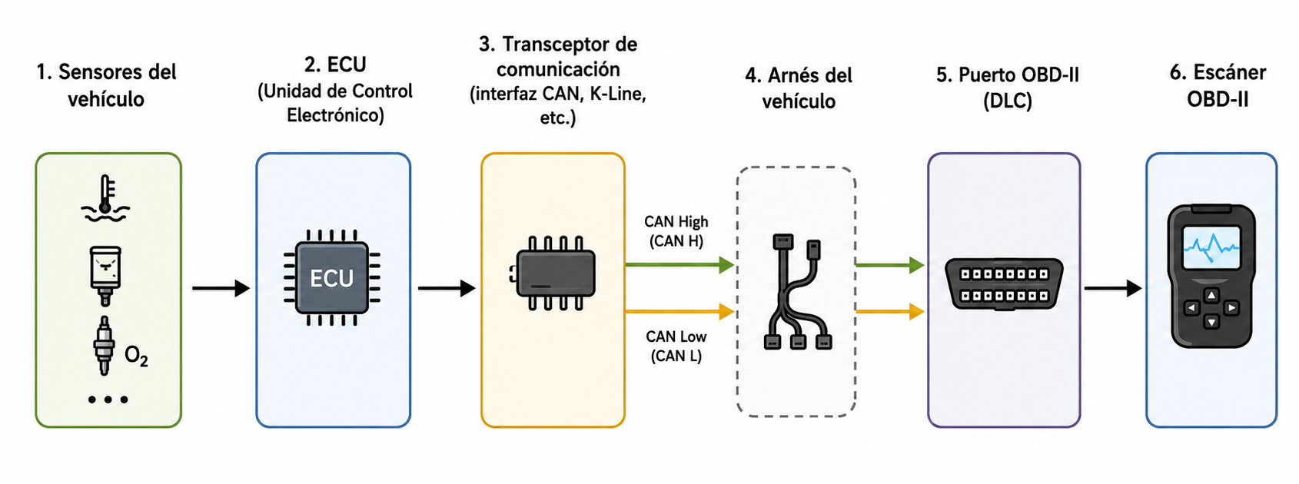
Images/esquema_obd2.png
