ErickCalle/Monitoreo-Consumo-Combustible-La-Paz-Bolivia/Images/esquematico_can_final.png

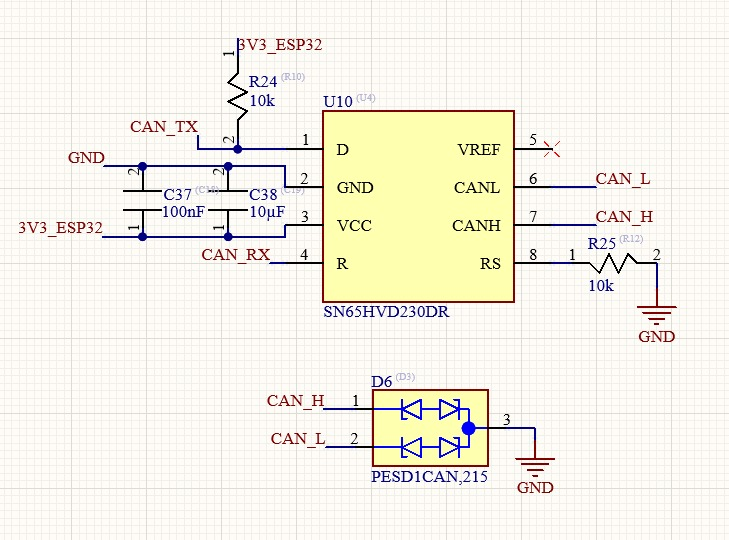
Images/esquematico_can_final.png
