ErickCalle/Monitoreo-Consumo-Combustible-La-Paz-Bolivia/Images/esquematico_pcb_proto.jpg

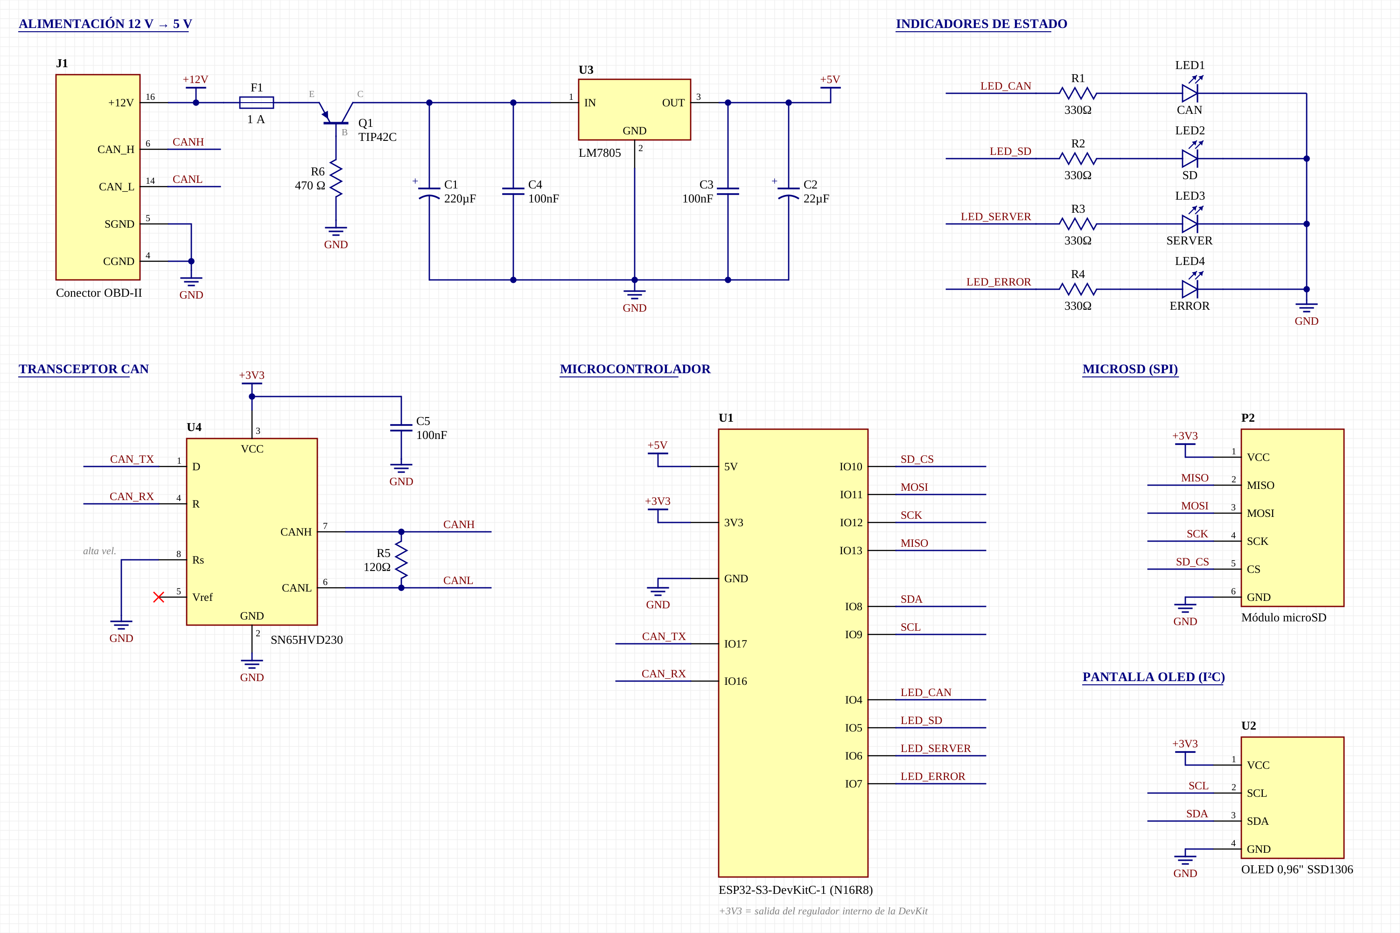
Images/esquematico_pcb_proto.jpg
