ErickCalle/Monitoreo-Consumo-Combustible-La-Paz-Bolivia/Images/ESTRUCTURA.png

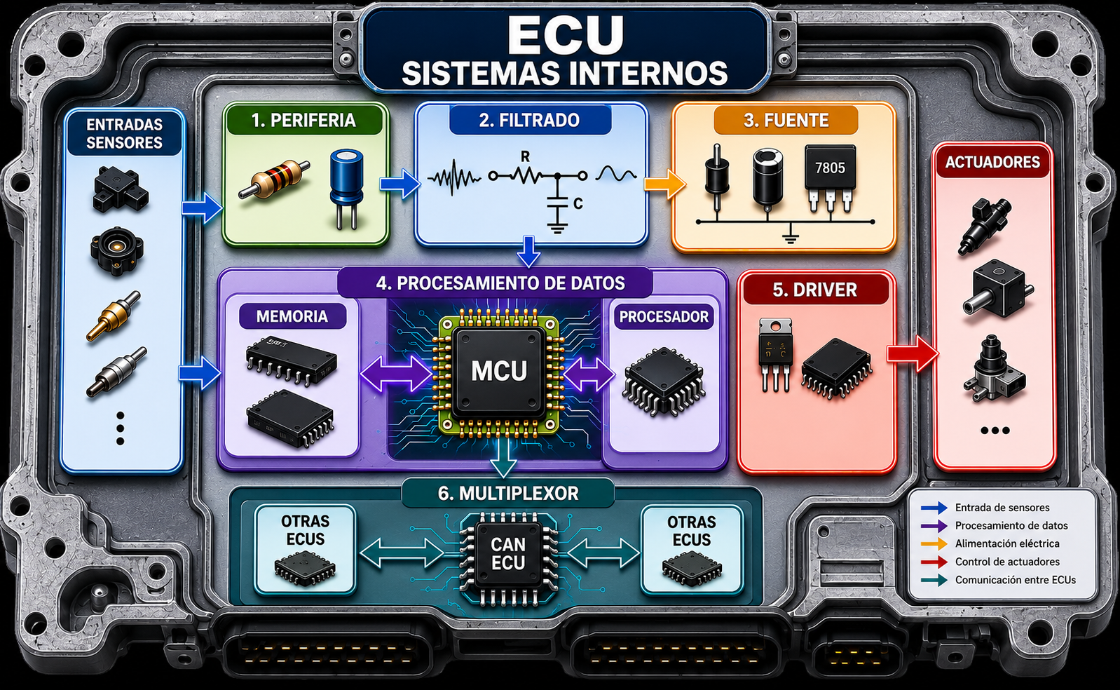
Images/ESTRUCTURA.png
