ErickCalle/Monitoreo-Consumo-Combustible-La-Paz-Bolivia/Images/ex.png

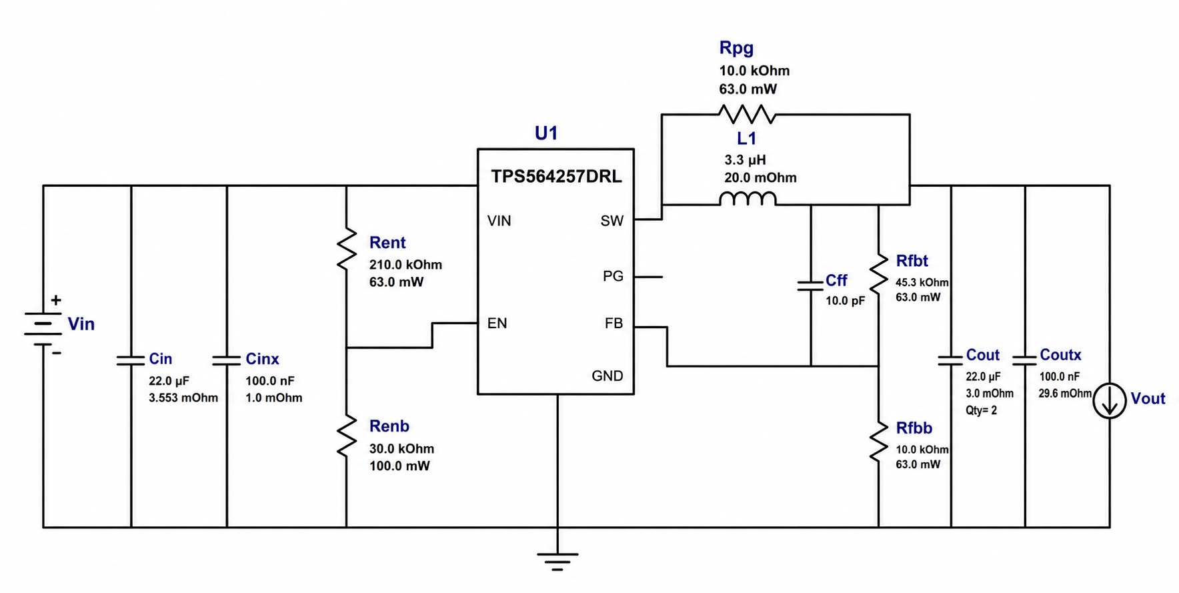
Images/ex.png
