ErickCalle/Monitoreo-Consumo-Combustible-La-Paz-Bolivia/Images/figura_breakeven.png

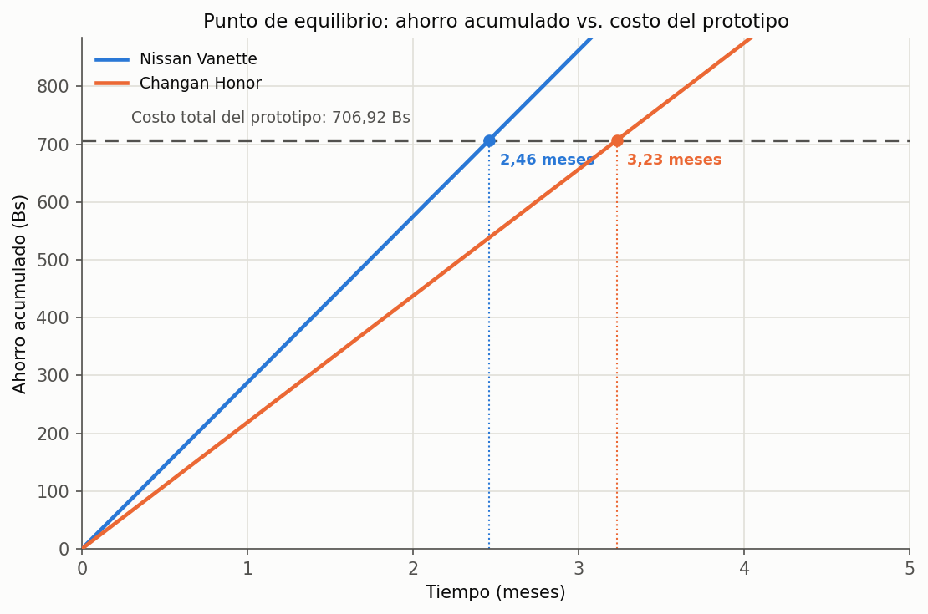
Images/figura_breakeven.png
