ErickCalle/Monitoreo-Consumo-Combustible-La-Paz-Bolivia/Images/figura_comparacion_comercial.png

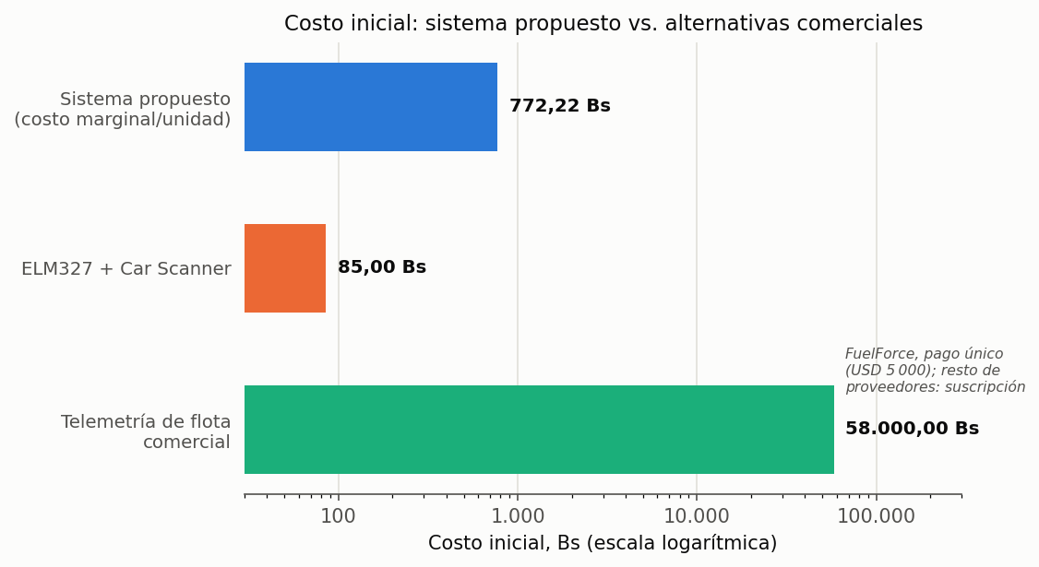
Images/figura_comparacion_comercial.png
