ErickCalle/Monitoreo-Consumo-Combustible-La-Paz-Bolivia/Images/figura_dispersion_dinamica.png

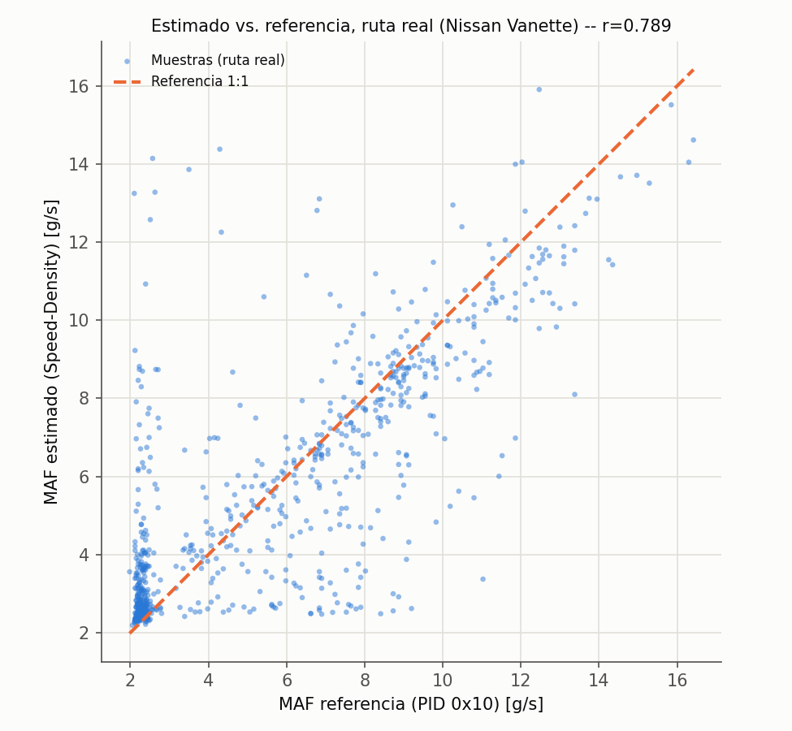
Images/figura_dispersion_dinamica.png
