ErickCalle/Monitoreo-Consumo-Combustible-La-Paz-Bolivia/Images/figura_histograma_error_dinamico.png

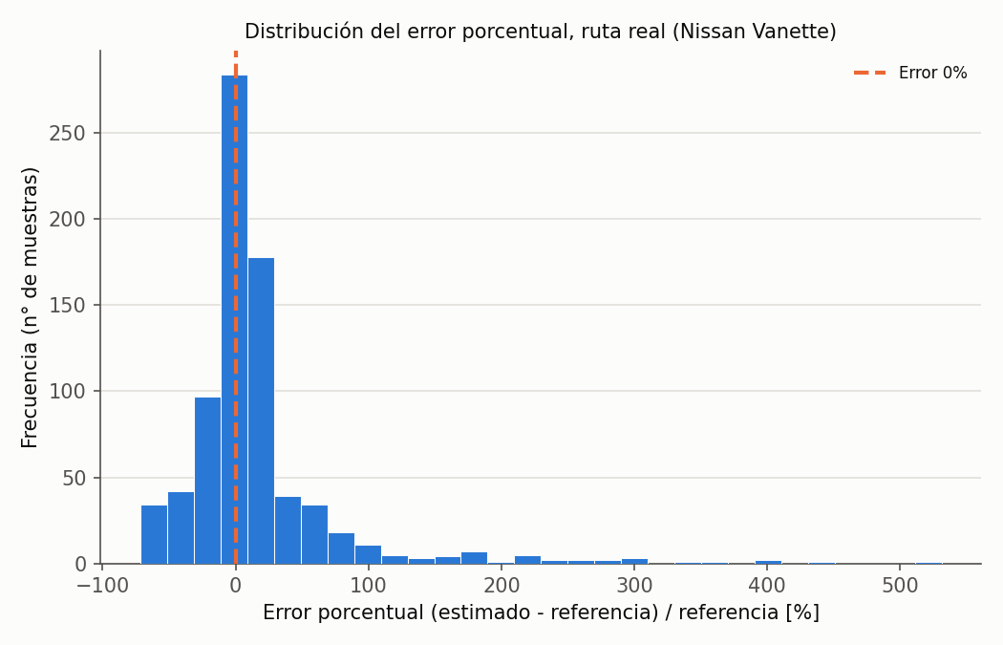
Images/figura_histograma_error_dinamico.png
