ErickCalle/Monitoreo-Consumo-Combustible-La-Paz-Bolivia/Images/figura_presupuesto_pastel.png

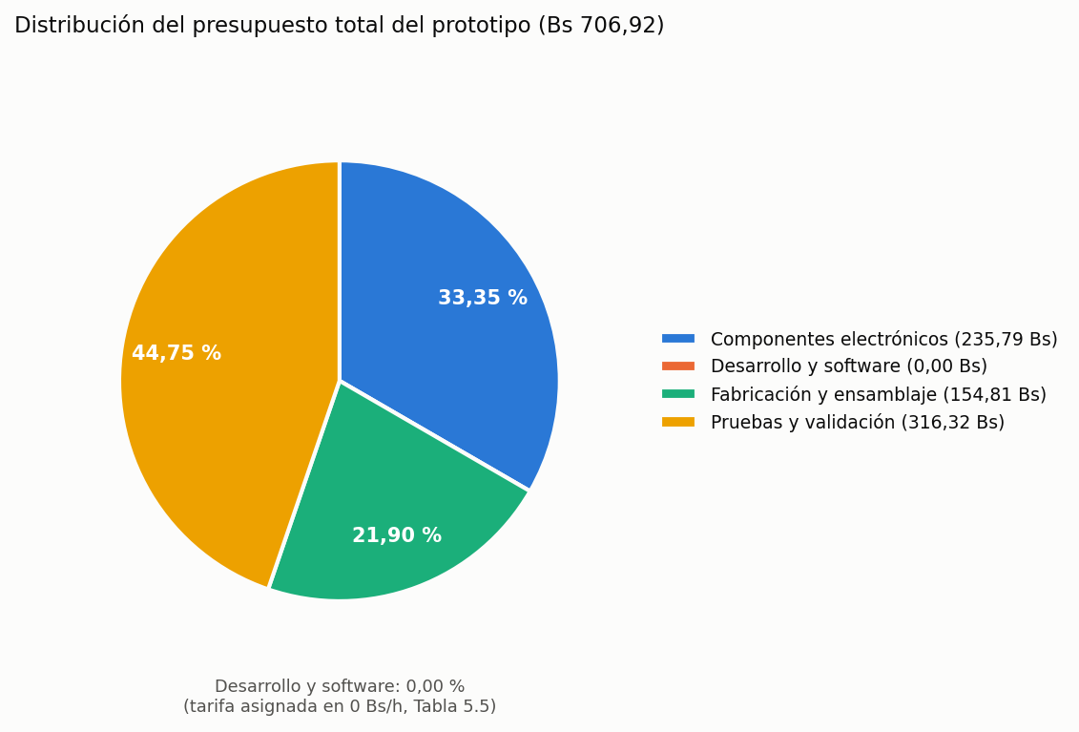
Images/figura_presupuesto_pastel.png
