ErickCalle/Monitoreo-Consumo-Combustible-La-Paz-Bolivia/Images/figura_ve_consumo_impacto.png

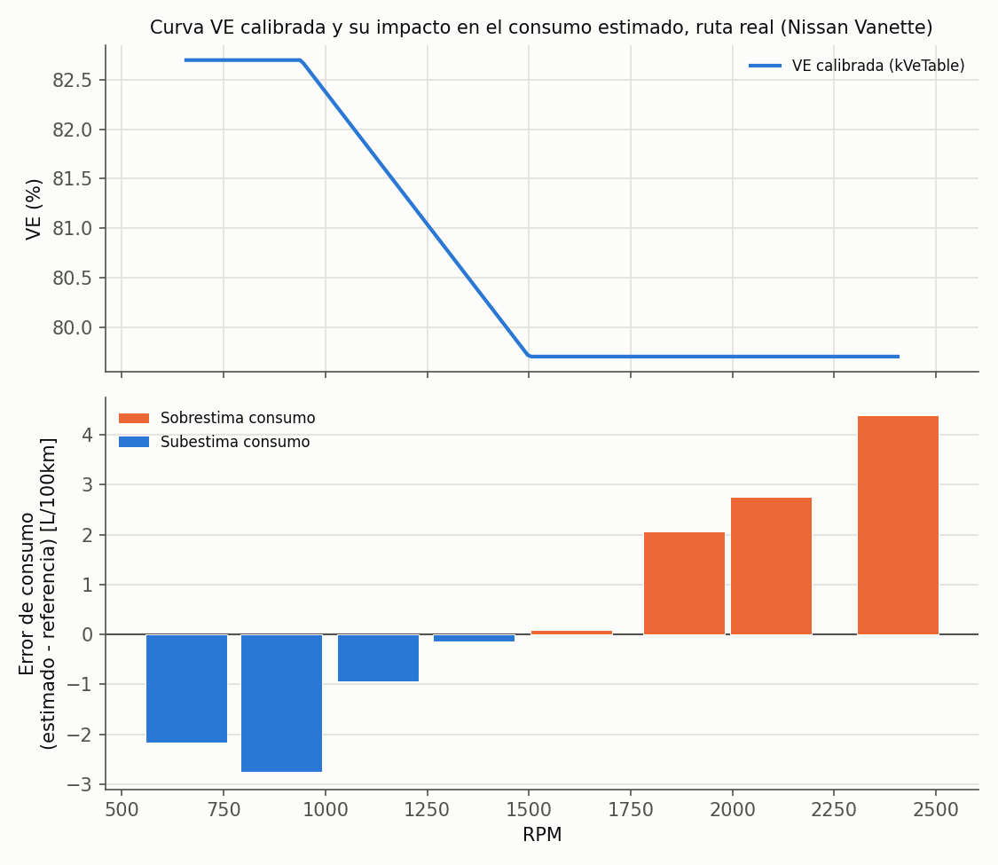
Images/figura_ve_consumo_impacto.png
