ErickCalle/Monitoreo-Consumo-Combustible-La-Paz-Bolivia/Images/figura_ws_latencia.png

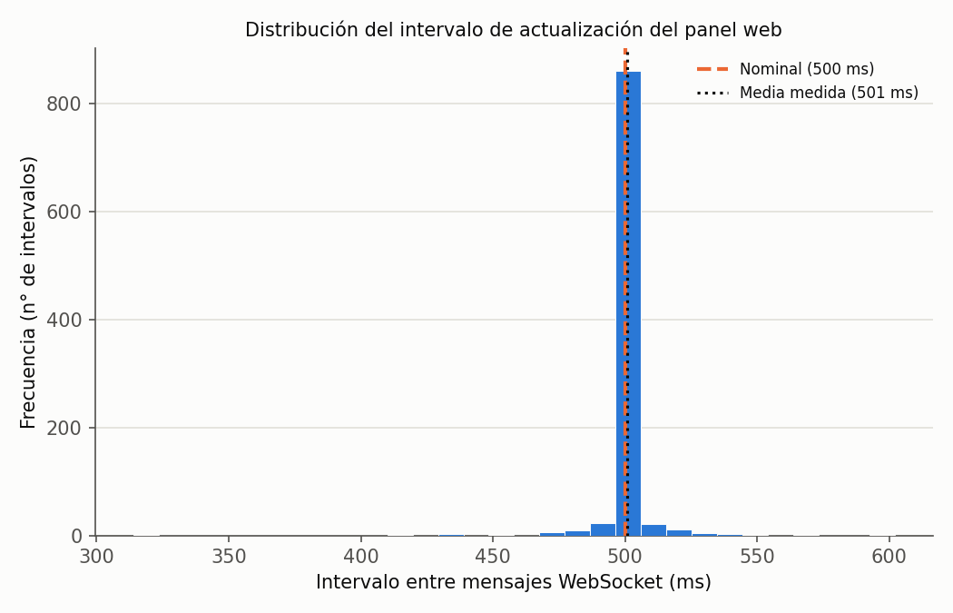
Images/figura_ws_latencia.png
