ErickCalle/Monitoreo-Consumo-Combustible-La-Paz-Bolivia/Images/FINAL.png

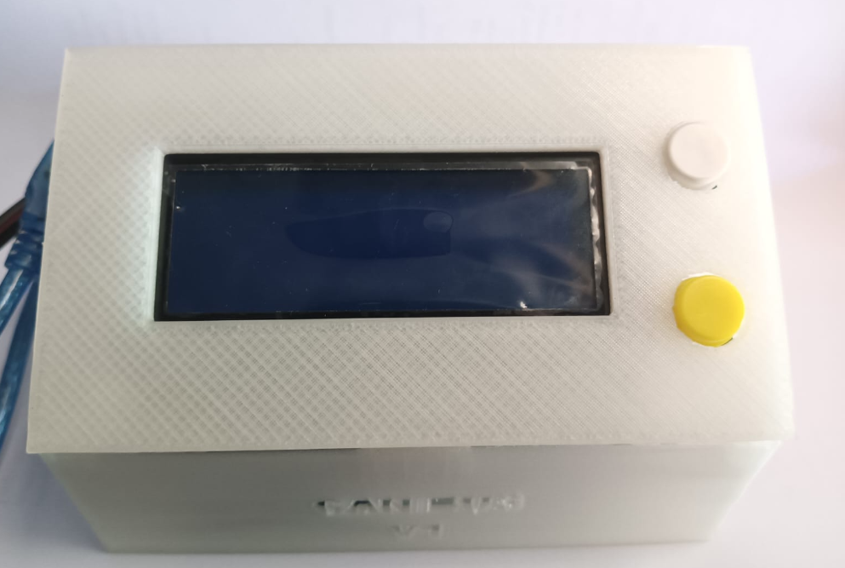
Images/FINAL.png
