ErickCalle/Monitoreo-Consumo-Combustible-La-Paz-Bolivia/Images/FIR.png

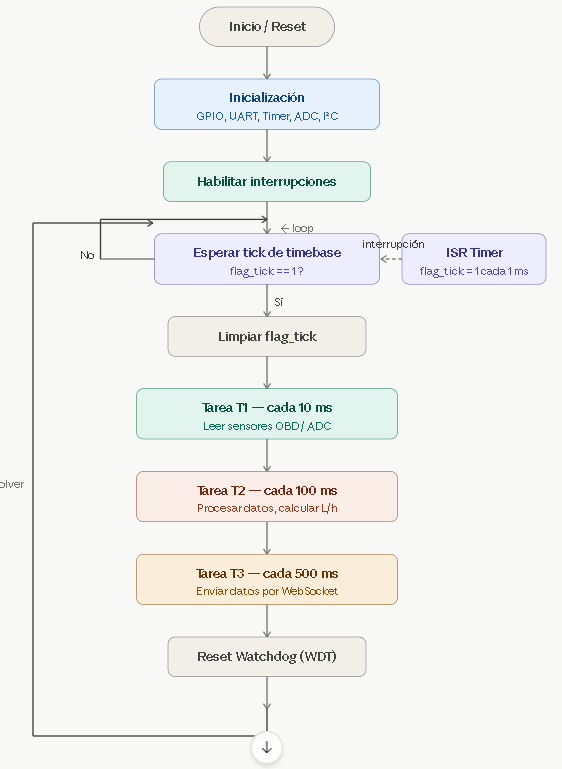
Images/FIR.png
