ErickCalle/Monitoreo-Consumo-Combustible-La-Paz-Bolivia/Images/FM.png

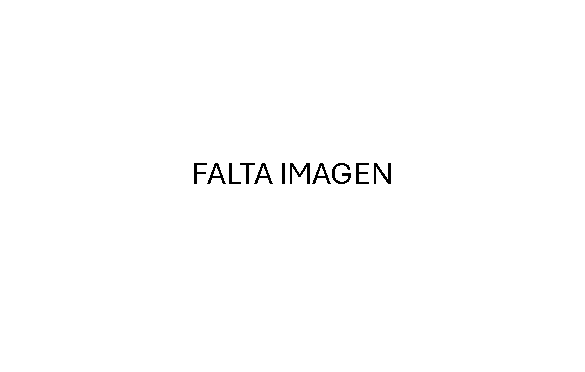
Images/FM.png
