ErickCalle/Monitoreo-Consumo-Combustible-La-Paz-Bolivia/Images/Frame.png

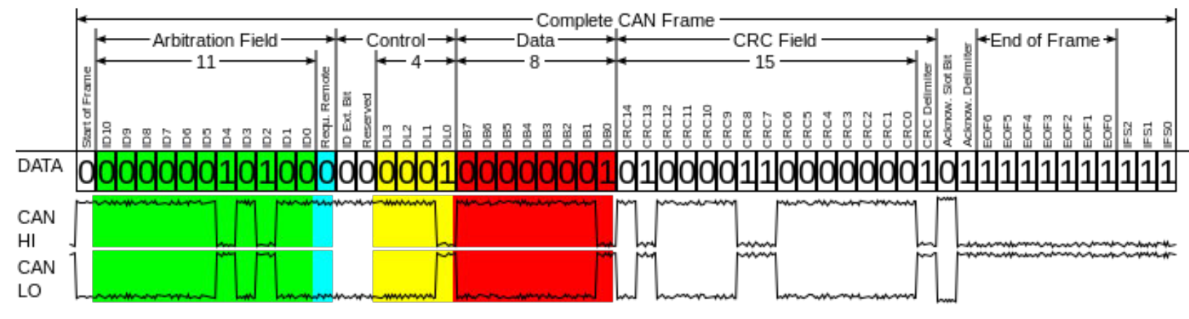
Images/Frame.png
