ErickCalle/Monitoreo-Consumo-Combustible-La-Paz-Bolivia/Images/GLP.png

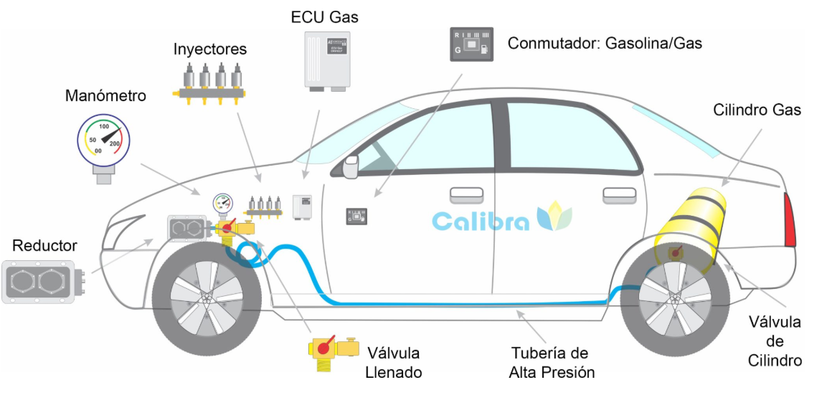
Images/GLP.png
