ErickCalle/Monitoreo-Consumo-Combustible-La-Paz-Bolivia/Images/GRAFICA_CHANGAN.png

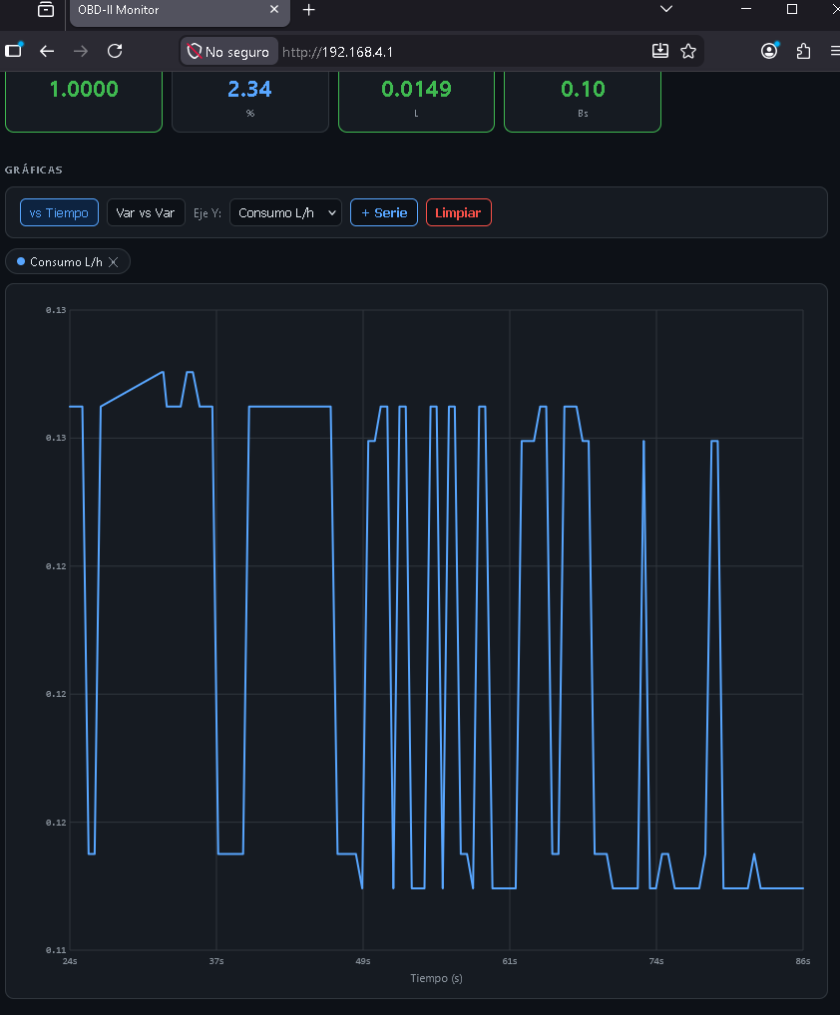
Images/GRAFICA_CHANGAN.png
