ErickCalle/Monitoreo-Consumo-Combustible-La-Paz-Bolivia/Images/GRAFICA_NISSAN.png

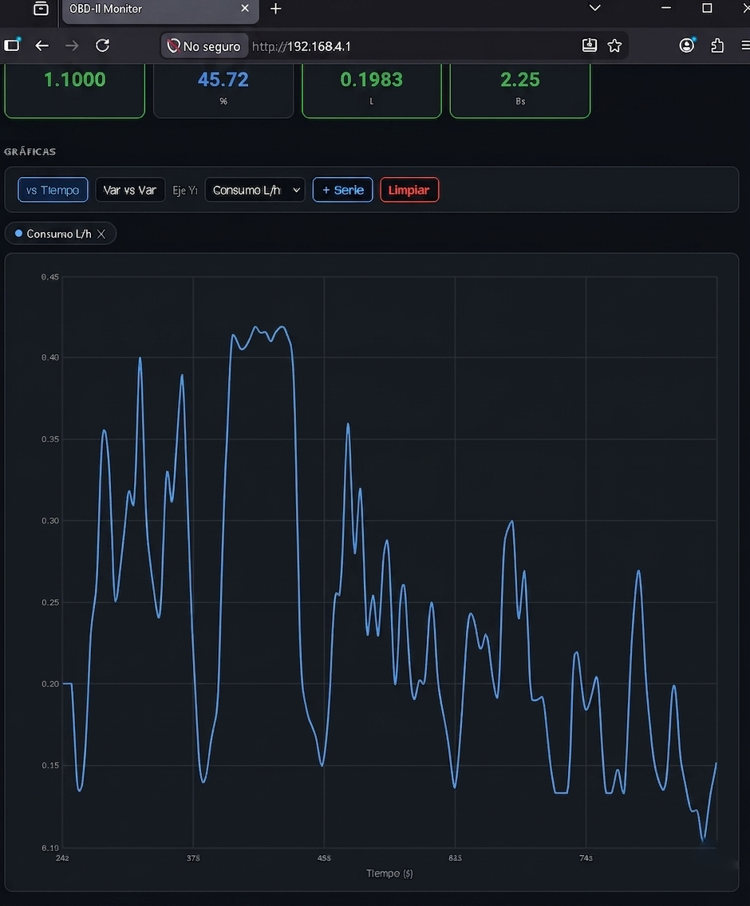
Images/GRAFICA_NISSAN.png
