ErickCalle/Monitoreo-Consumo-Combustible-La-Paz-Bolivia/Images/grafics2.png

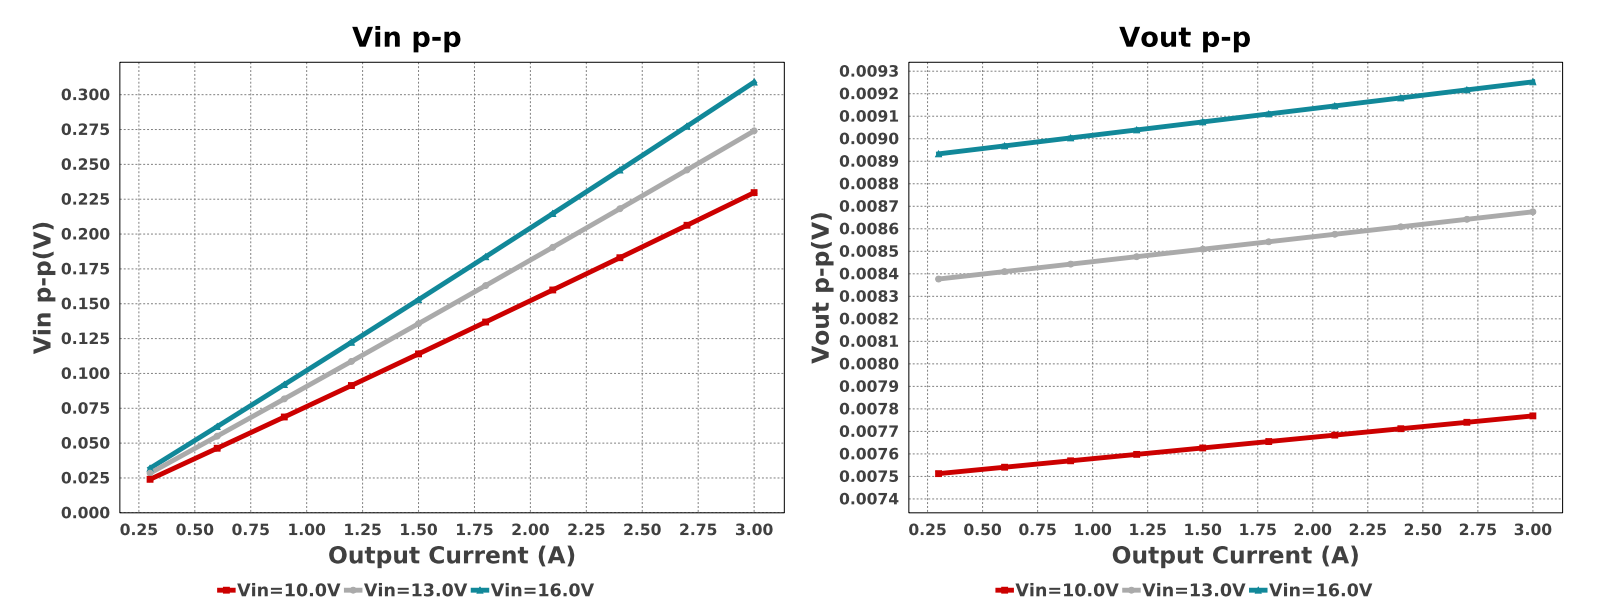
Images/grafics2.png
