ErickCalle/Monitoreo-Consumo-Combustible-La-Paz-Bolivia/Images/grafics.png

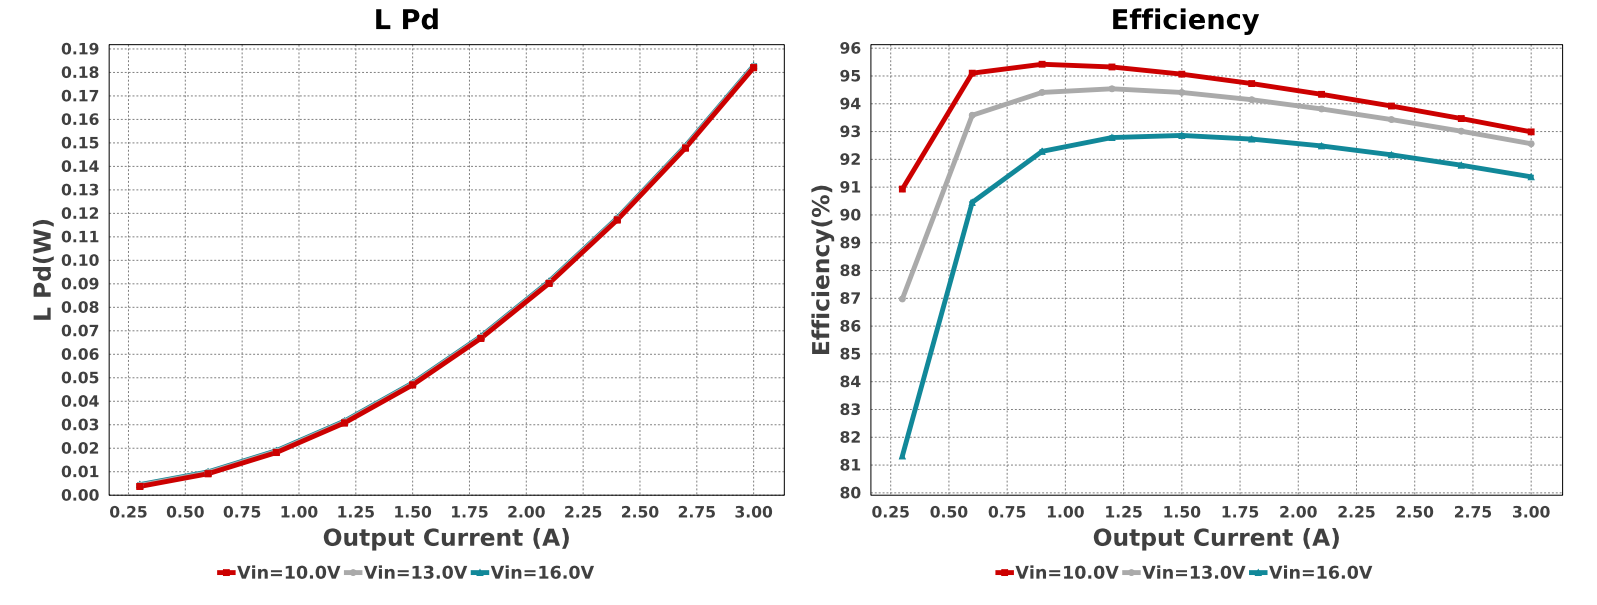
Images/grafics.png
