ErickCalle/Monitoreo-Consumo-Combustible-La-Paz-Bolivia/Images/HISTO.png

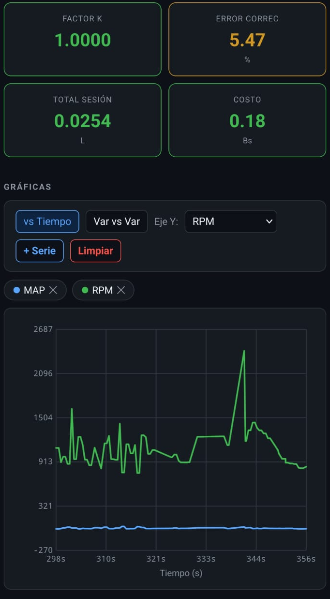
Images/HISTO.png
