ErickCalle/Monitoreo-Consumo-Combustible-La-Paz-Bolivia/Images/HMI.png

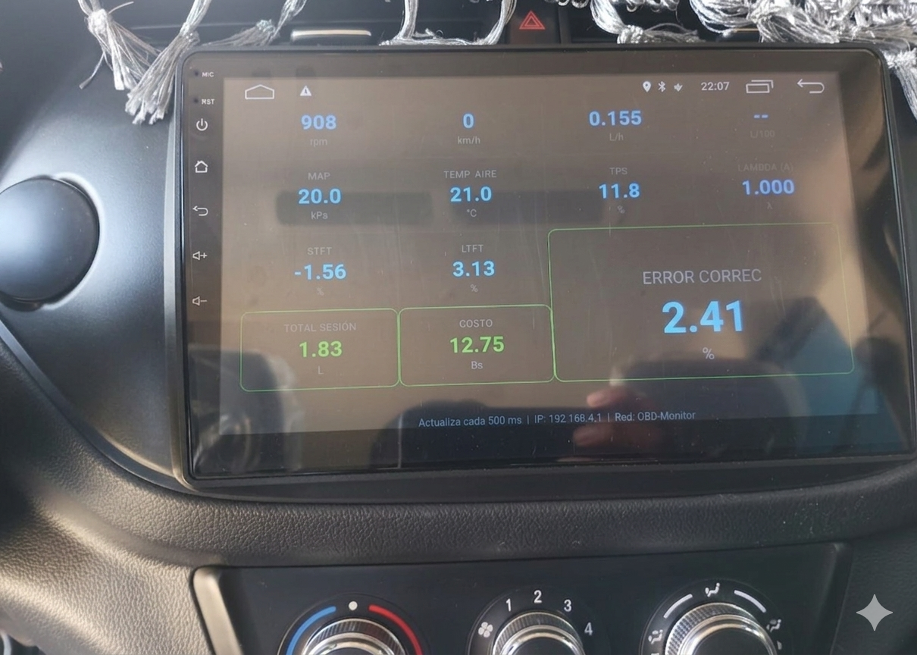
Images/HMI.png
