ErickCalle/Monitoreo-Consumo-Combustible-La-Paz-Bolivia/Images/HMI_CEL.png

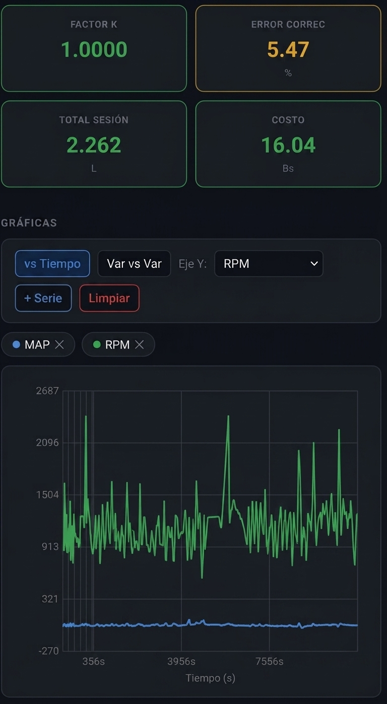
Images/HMI_CEL.png
