ErickCalle/Monitoreo-Consumo-Combustible-La-Paz-Bolivia/Images/HMI_NISSAN.png

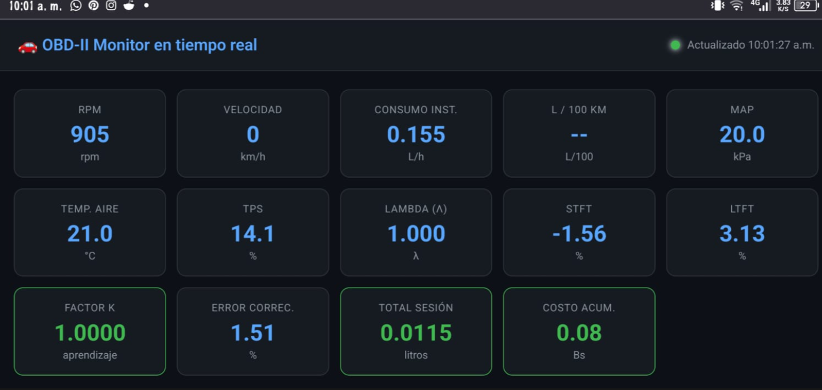
Images/HMI_NISSAN.png
