ErickCalle/Monitoreo-Consumo-Combustible-La-Paz-Bolivia/Images/HTML.png

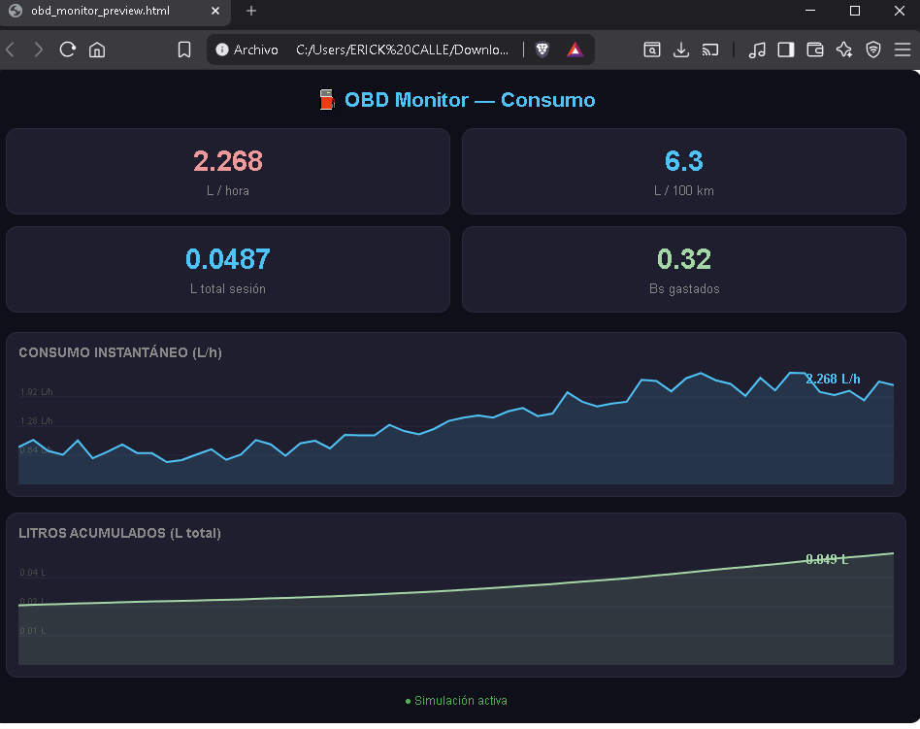
Images/HTML.png
