ErickCalle/Monitoreo-Consumo-Combustible-La-Paz-Bolivia/Images/IMPRESION_3D.jpg

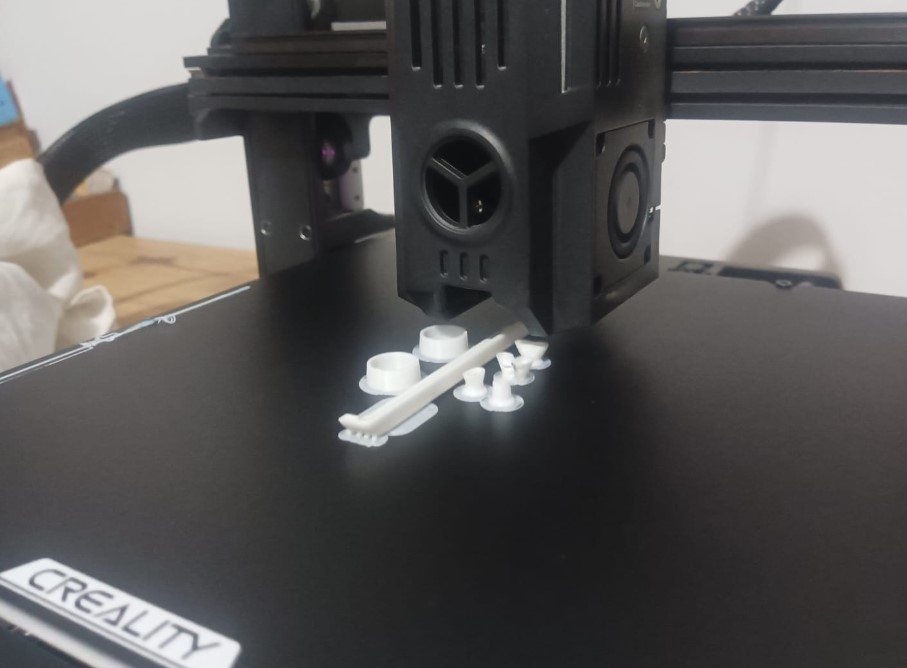
Images/IMPRESION_3D.jpg
