ErickCalle/Monitoreo-Consumo-Combustible-La-Paz-Bolivia/Images/INDICADOR.png

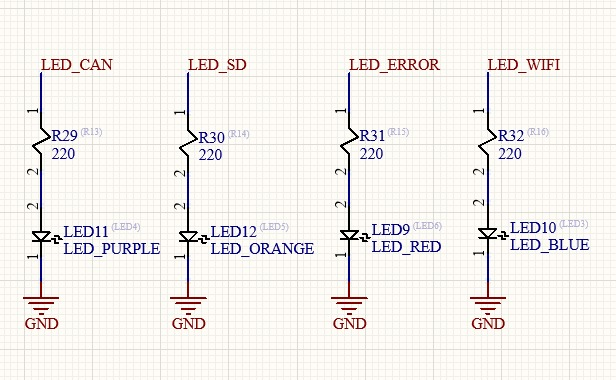
Images/INDICADOR.png
