ErickCalle/Monitoreo-Consumo-Combustible-La-Paz-Bolivia/Images/INTER.png

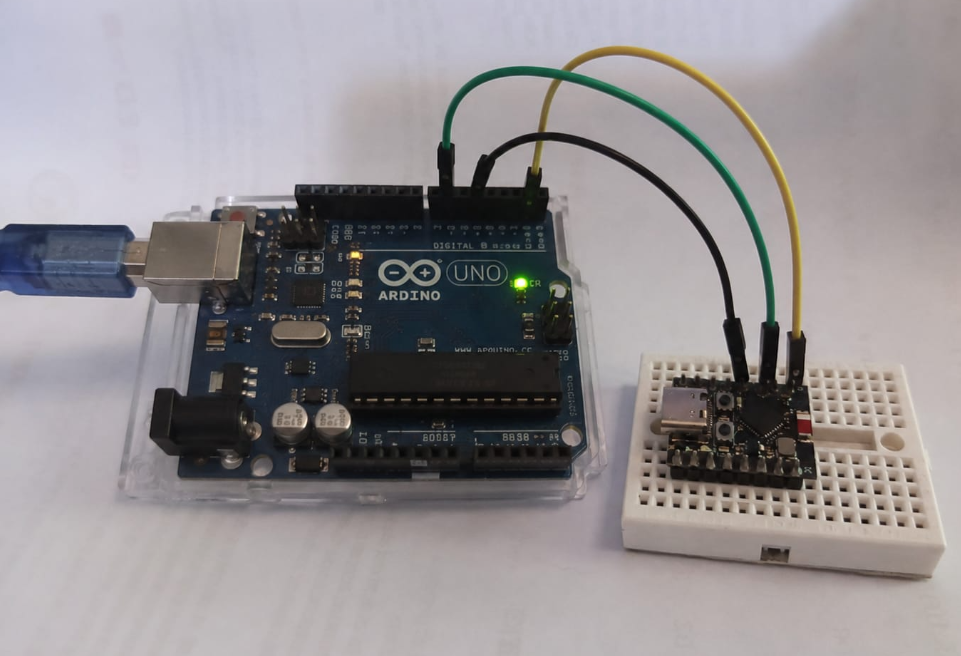
Images/INTER.png
