ErickCalle/Monitoreo-Consumo-Combustible-La-Paz-Bolivia/Images/LARGO.jpg

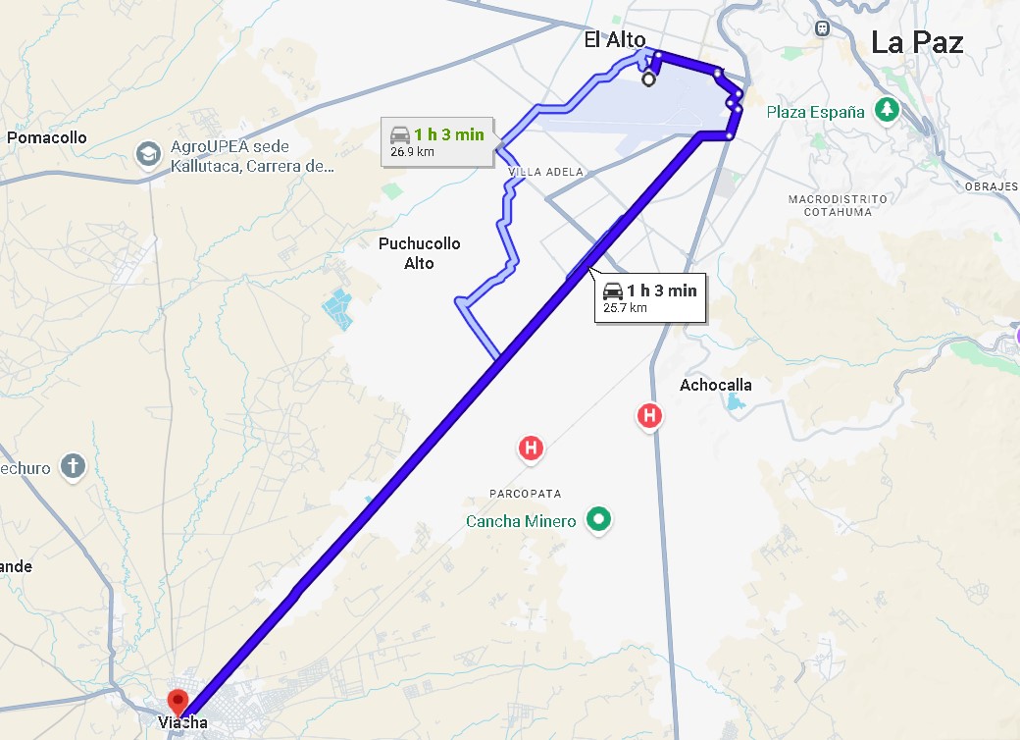
Images/LARGO.jpg
