ErickCalle/Monitoreo-Consumo-Combustible-La-Paz-Bolivia/Images/LATENCIA.png

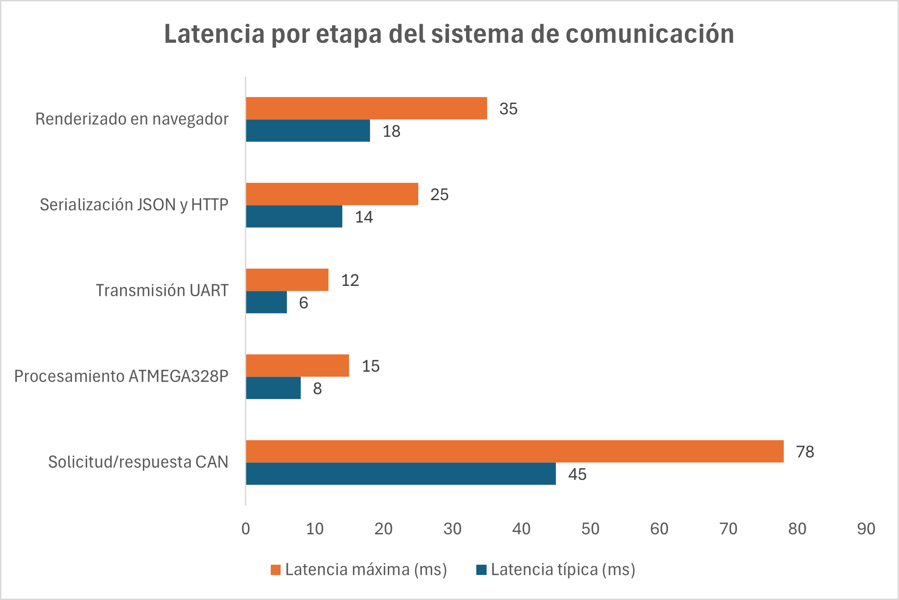
Images/LATENCIA.png
