ErickCalle/Monitoreo-Consumo-Combustible-La-Paz-Bolivia/Images/LCD3D.png

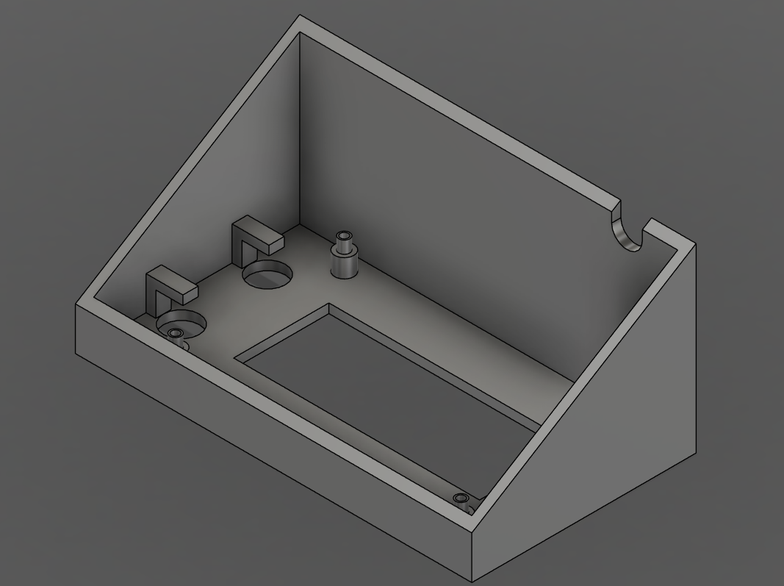
Images/LCD3D.png
