ErickCalle/Monitoreo-Consumo-Combustible-La-Paz-Bolivia/Images/LCD.png

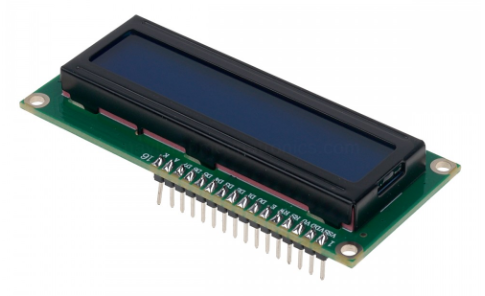
Images/LCD.png
