ErickCalle/Monitoreo-Consumo-Combustible-La-Paz-Bolivia/Images/LINEA.png

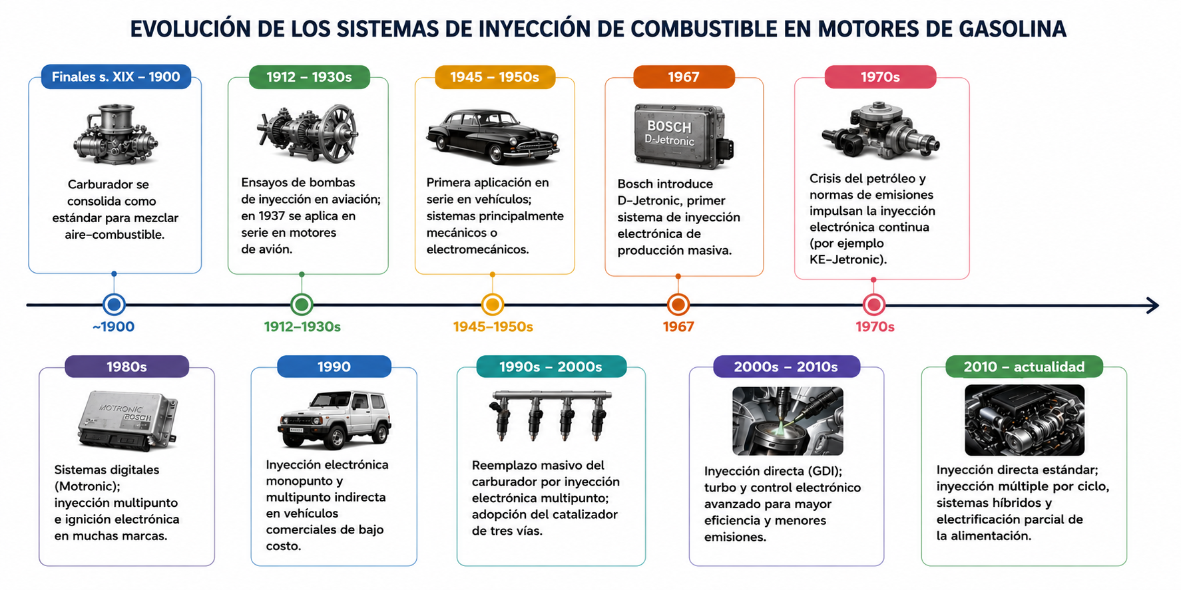
Images/LINEA.png
