ErickCalle/Monitoreo-Consumo-Combustible-La-Paz-Bolivia/Images/maf_sensor.png

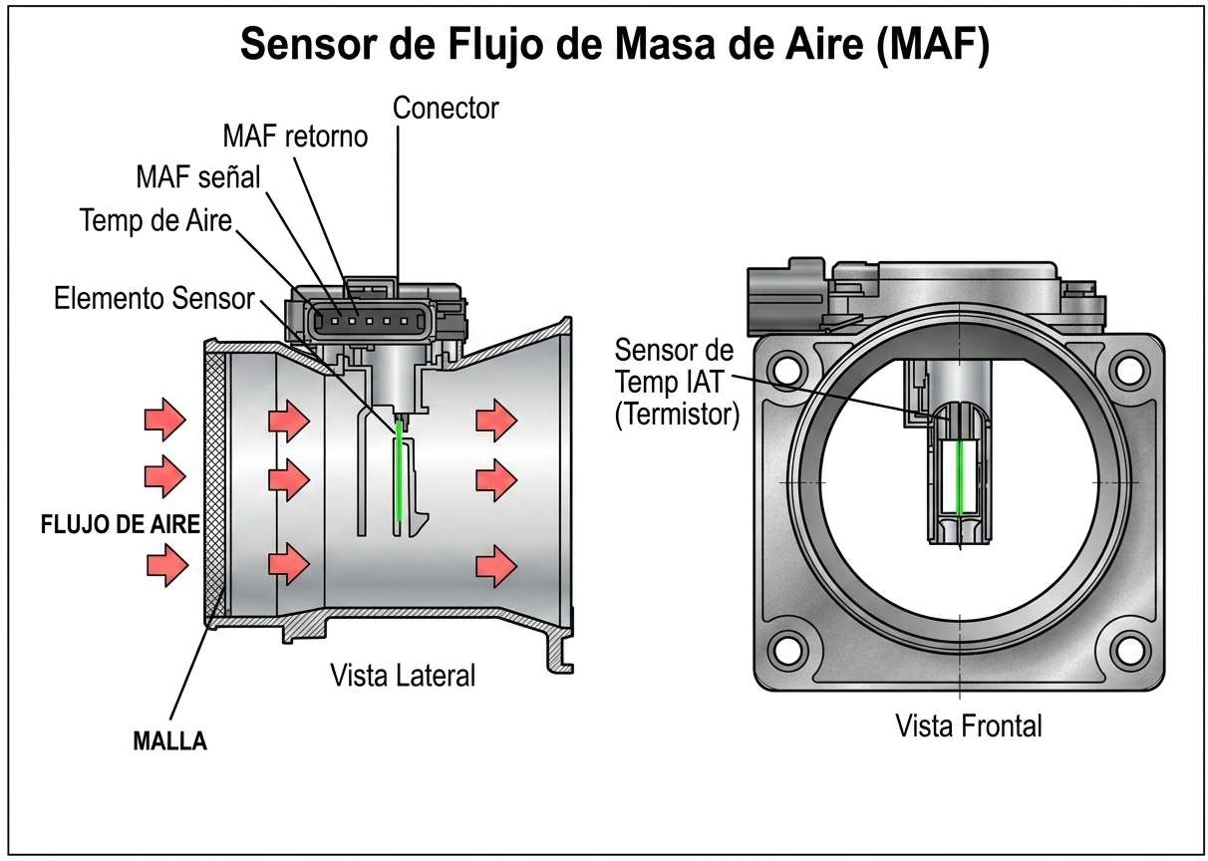
Images/maf_sensor.png
