ErickCalle/Monitoreo-Consumo-Combustible-La-Paz-Bolivia/Images/mAP2.png

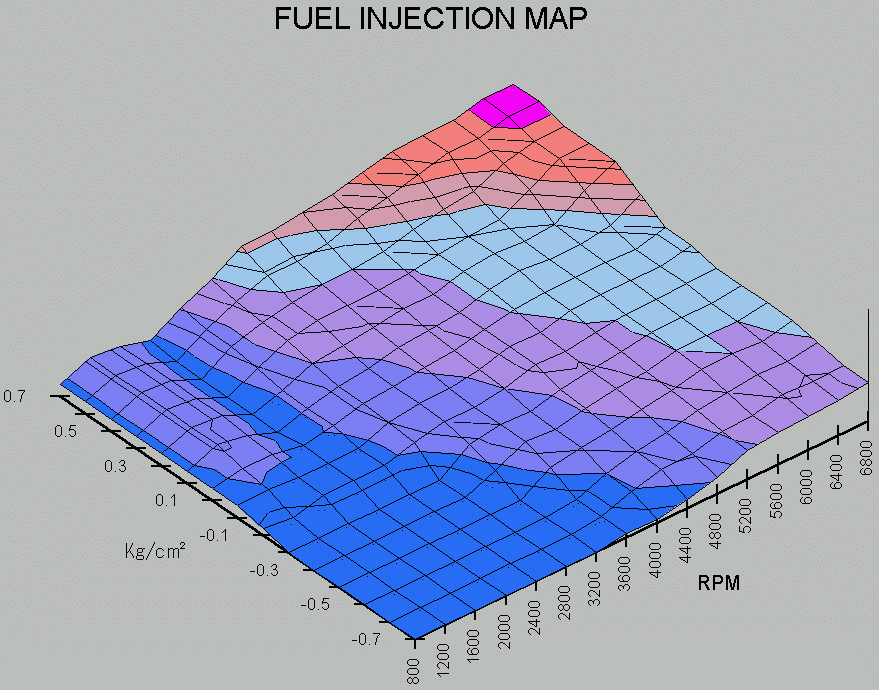
Images/mAP2.png
