ErickCalle/Monitoreo-Consumo-Combustible-La-Paz-Bolivia/Images/MCP2515.png

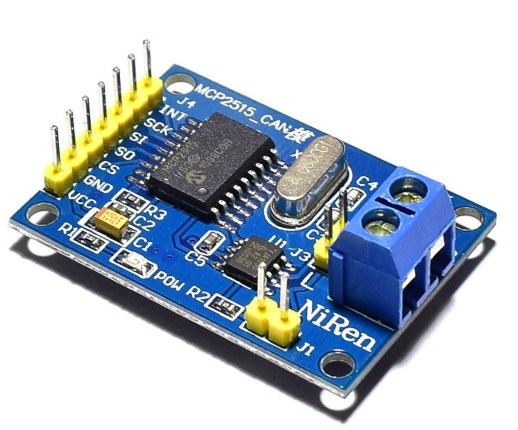
Images/MCP2515.png
