ErickCalle/Monitoreo-Consumo-Combustible-La-Paz-Bolivia/Images/MEDIA.jpg

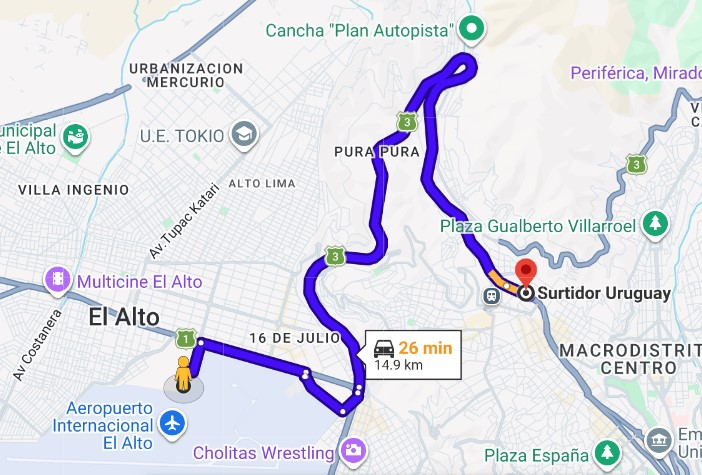
Images/MEDIA.jpg
