ErickCalle/Monitoreo-Consumo-Combustible-La-Paz-Bolivia/Images/MICRO.png

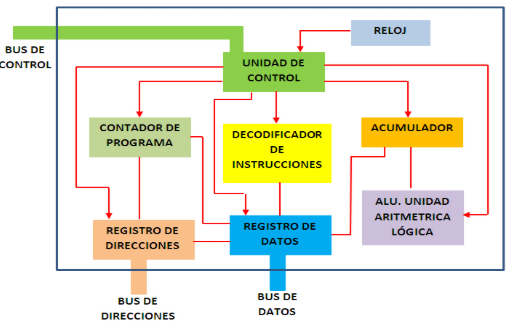
Images/MICRO.png
