ErickCalle/Monitoreo-Consumo-Combustible-La-Paz-Bolivia/Images/MICRO_E.png

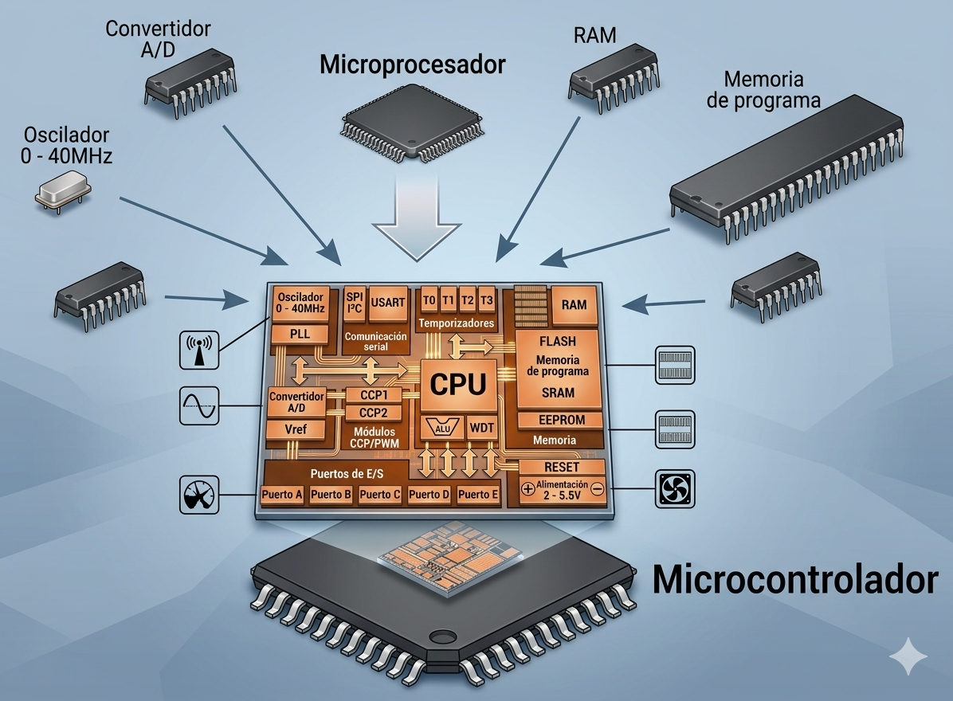
Images/MICRO_E.png
