ErickCalle/Monitoreo-Consumo-Combustible-La-Paz-Bolivia/Images/MULTI.jpg

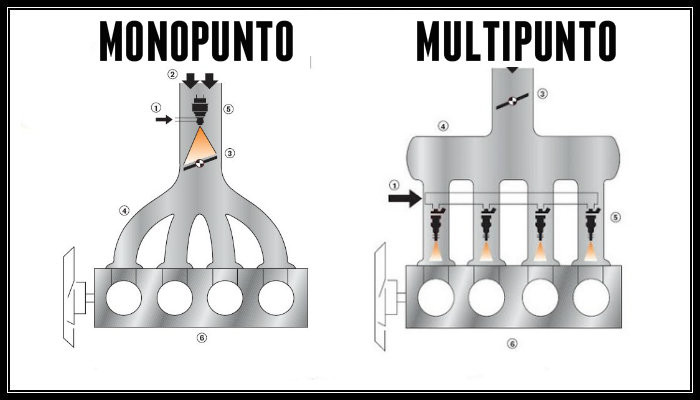
Images/MULTI.jpg
