ErickCalle/Monitoreo-Consumo-Combustible-La-Paz-Bolivia/Images/OBD.png

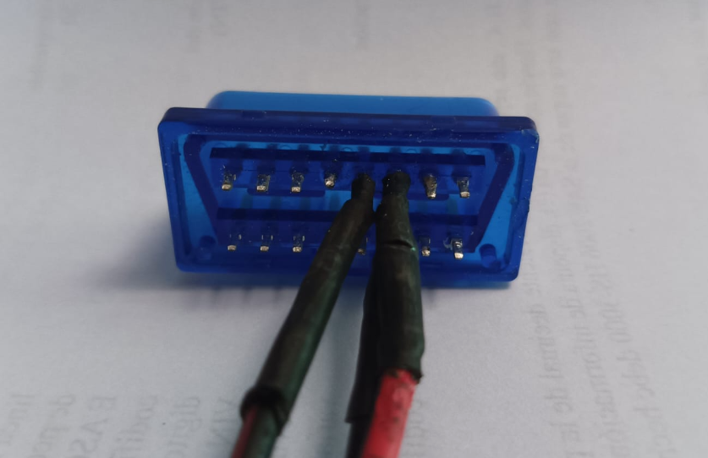
Images/OBD.png
