ErickCalle/Monitoreo-Consumo-Combustible-La-Paz-Bolivia/Images/OBD_CON.jpeg

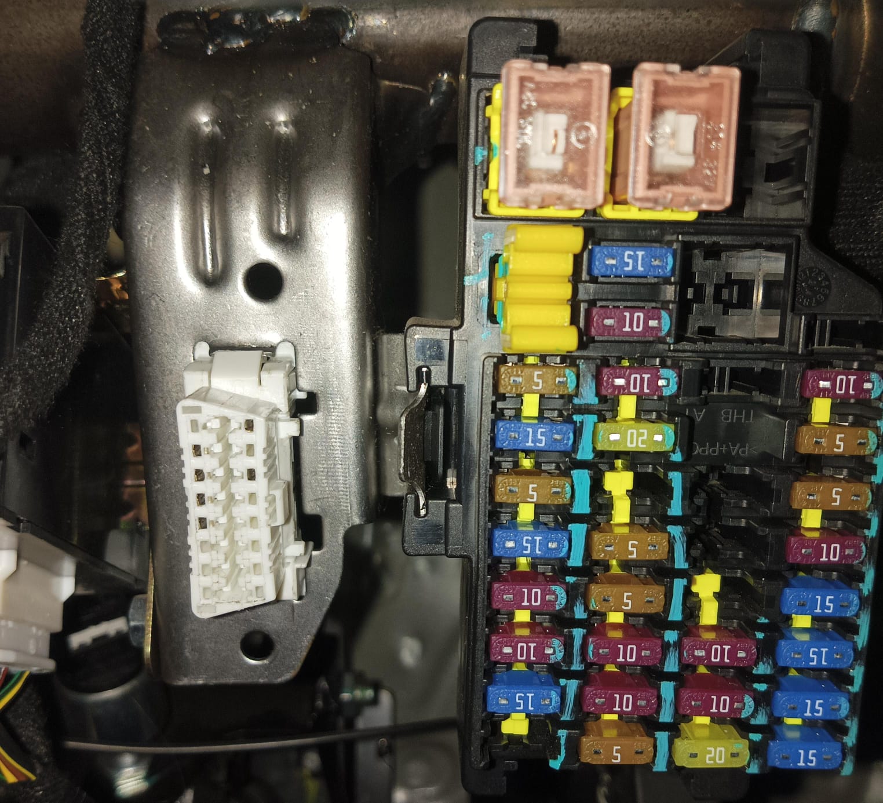
Images/OBD_CON.jpeg
