ErickCalle/Monitoreo-Consumo-Combustible-La-Paz-Bolivia/Images/pcb.png

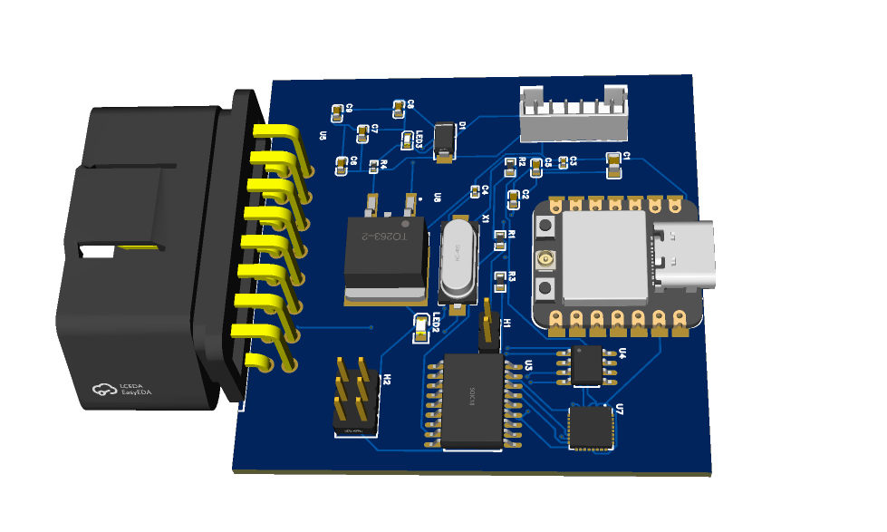
Images/pcb.png
