ErickCalle/Monitoreo-Consumo-Combustible-La-Paz-Bolivia/Images/PERI.png

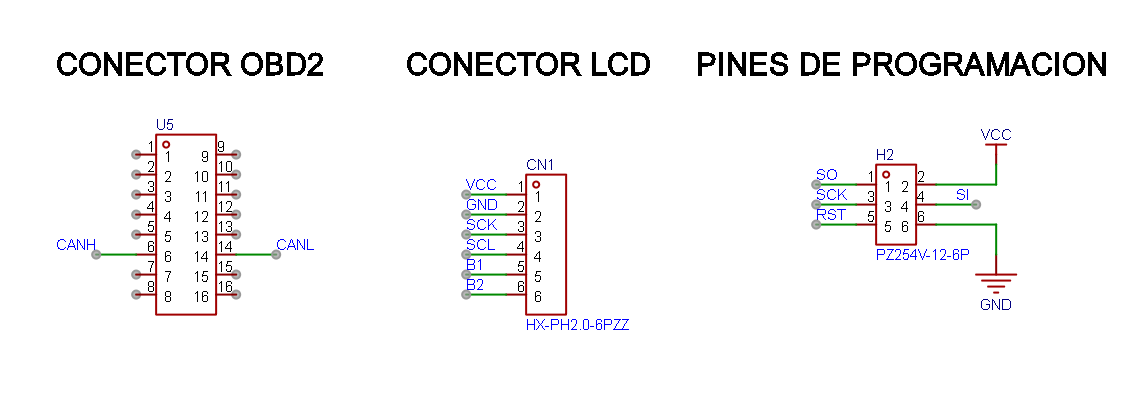
Images/PERI.png
