ErickCalle/Monitoreo-Consumo-Combustible-La-Paz-Bolivia/Images/pids_changan.png

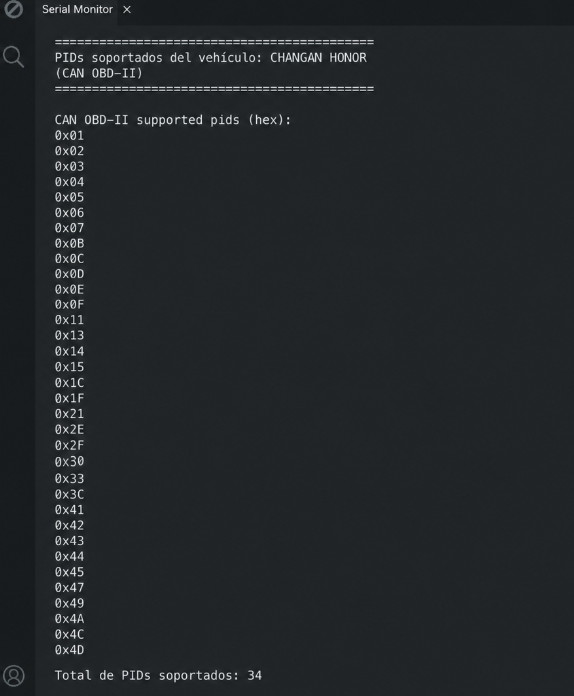
Images/pids_changan.png
