ErickCalle/Monitoreo-Consumo-Combustible-La-Paz-Bolivia/Images/pids_vanette.png

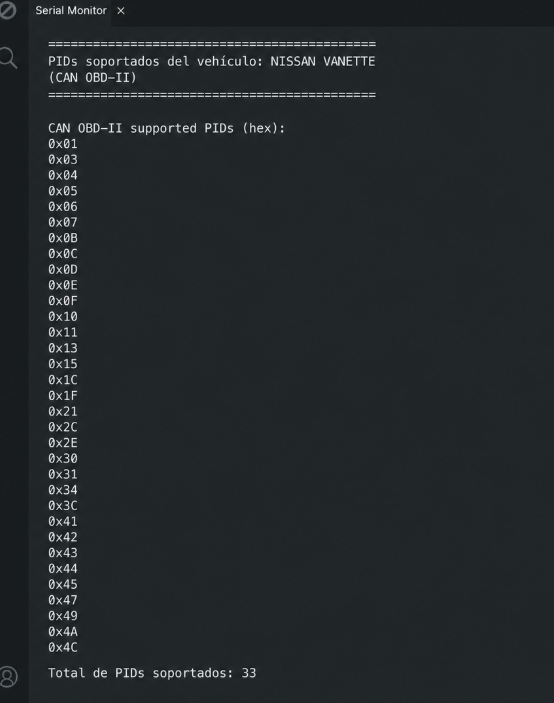
Images/pids_vanette.png
