ErickCalle/Monitoreo-Consumo-Combustible-La-Paz-Bolivia/Images/pistas_clearance.png

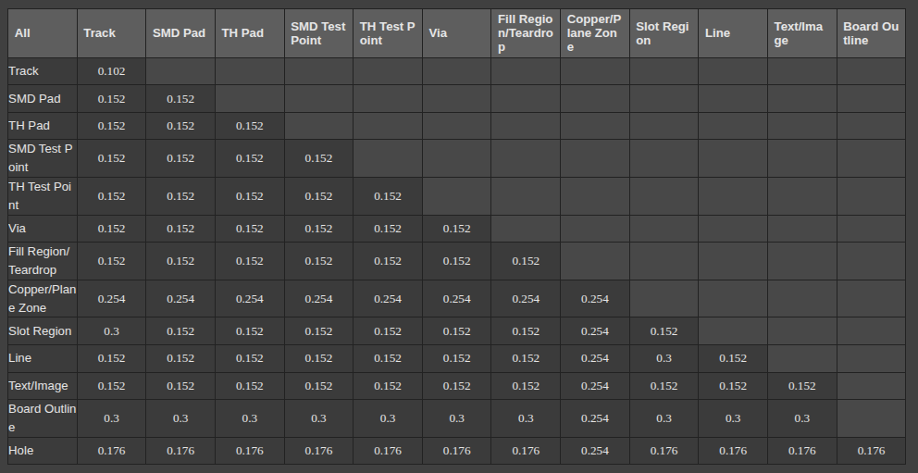
Images/pistas_clearance.png
