ErickCalle/Monitoreo-Consumo-Combustible-La-Paz-Bolivia/Images/PROGRAMACION.png

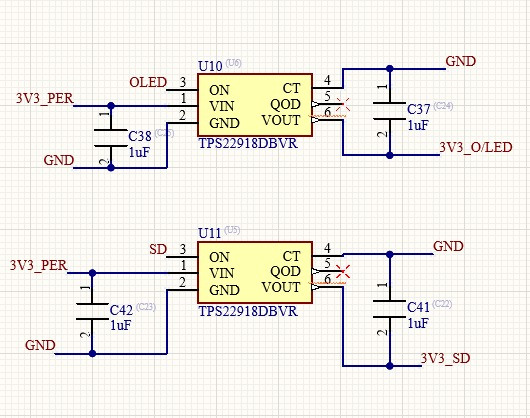
Images/PROGRAMACION.png
