ErickCalle/Monitoreo-Consumo-Combustible-La-Paz-Bolivia/Images/RADAR.png

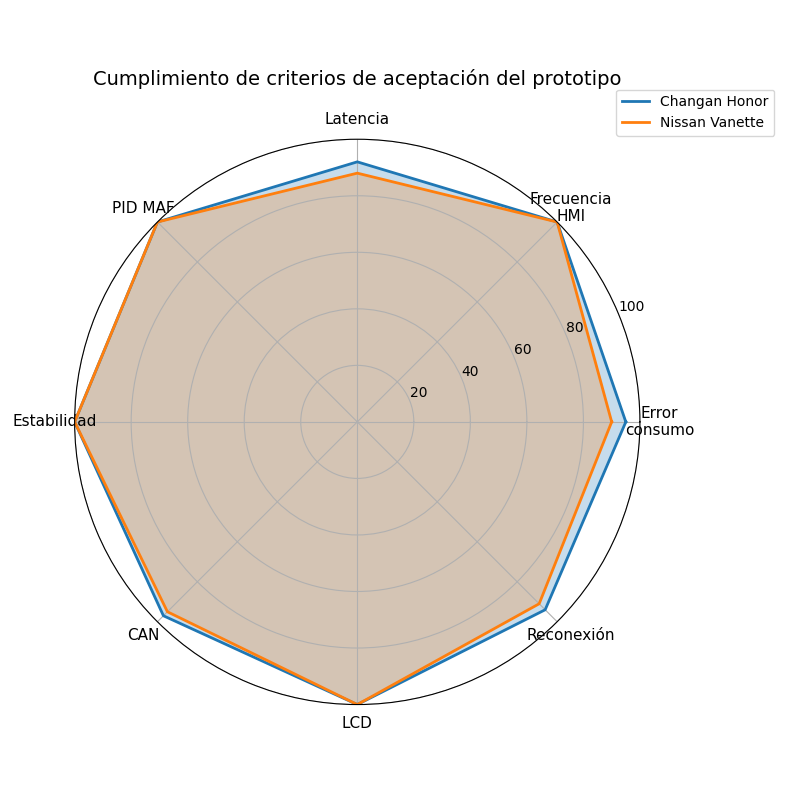
Images/RADAR.png
