ErickCalle/Monitoreo-Consumo-Combustible-La-Paz-Bolivia/Images/REAL.png

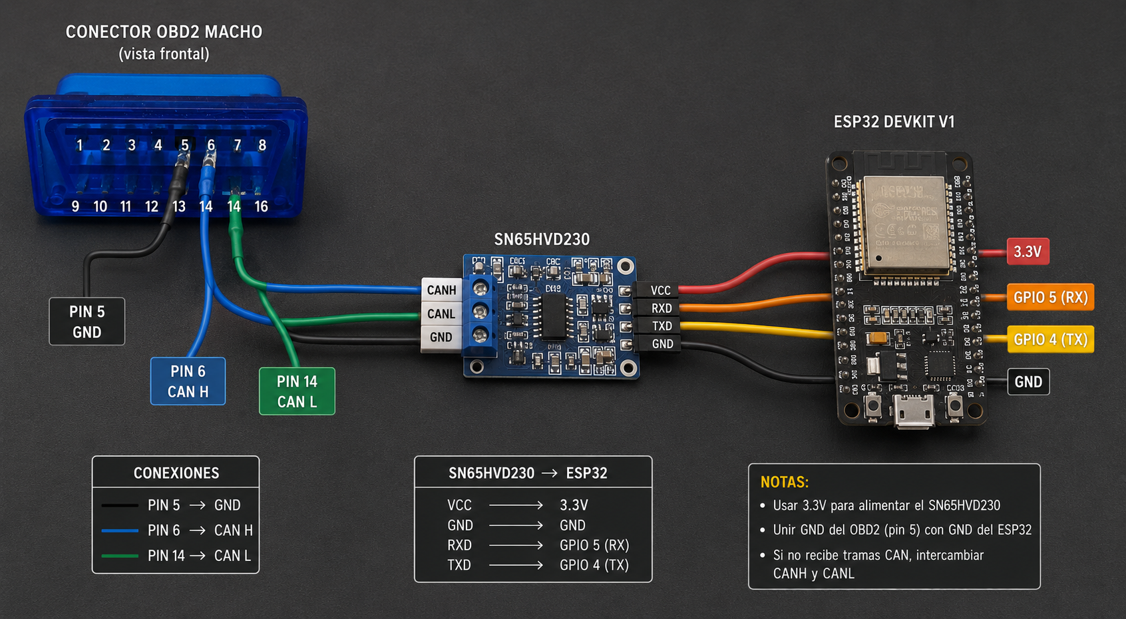
Images/REAL.png
