ErickCalle/Monitoreo-Consumo-Combustible-La-Paz-Bolivia/Images/regu.png

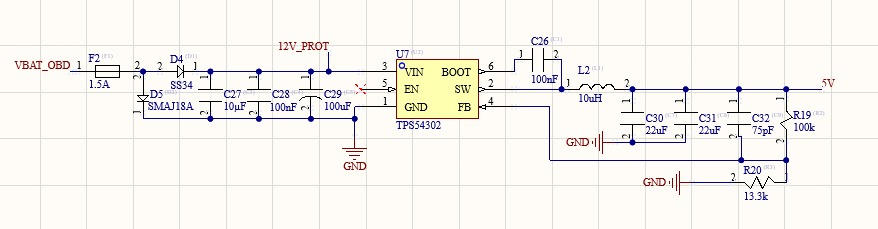
Images/regu.png
