ErickCalle/Monitoreo-Consumo-Combustible-La-Paz-Bolivia/Images/regum.png

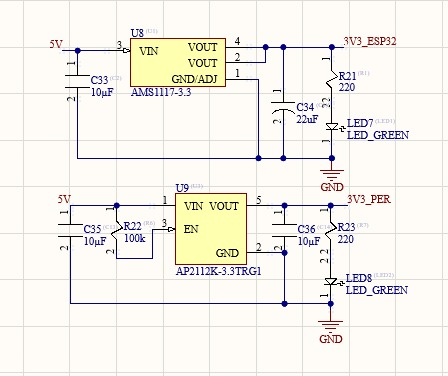
Images/regum.png
