ErickCalle/Monitoreo-Consumo-Combustible-La-Paz-Bolivia/Images/RPM_MAP_CHANGAN.png

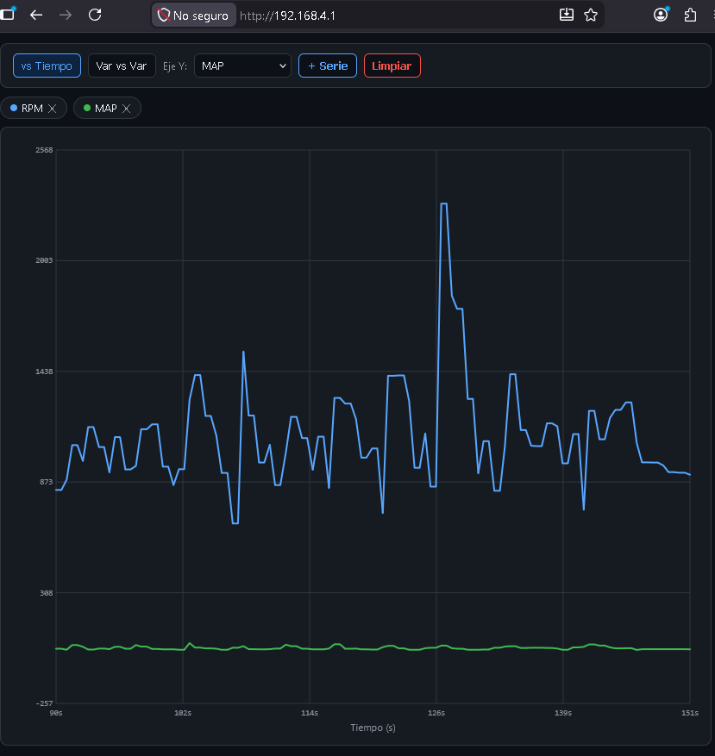
Images/RPM_MAP_CHANGAN.png
