ErickCalle/Monitoreo-Consumo-Combustible-La-Paz-Bolivia/Images/RPM_MAP_NISSAN.png

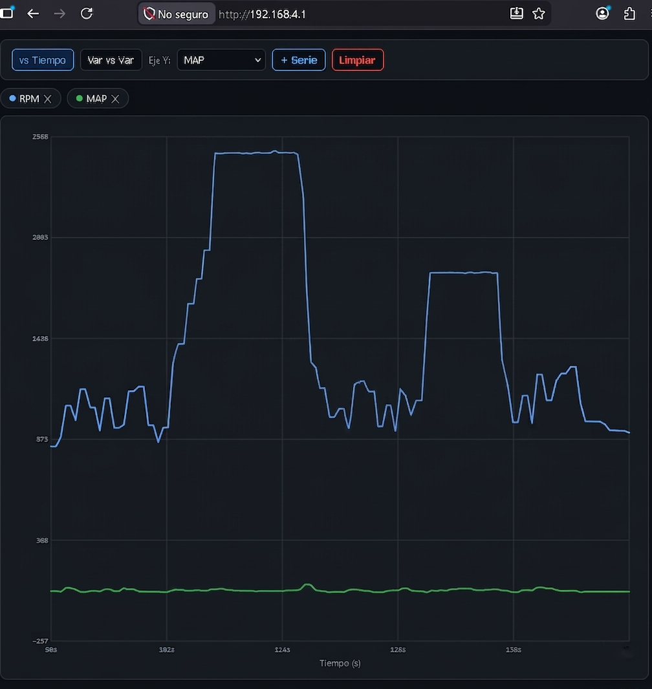
Images/RPM_MAP_NISSAN.png
