ErickCalle/Monitoreo-Consumo-Combustible-La-Paz-Bolivia/Images/rpm_sniffer.png

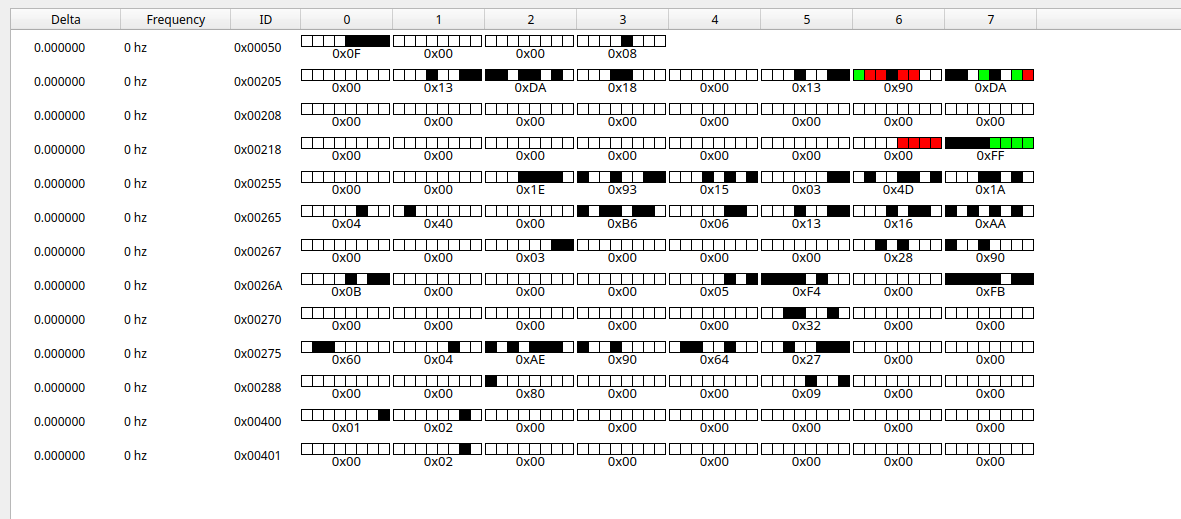
Images/rpm_sniffer.png
