ErickCalle/Monitoreo-Consumo-Combustible-La-Paz-Bolivia/Images/RUTA.png

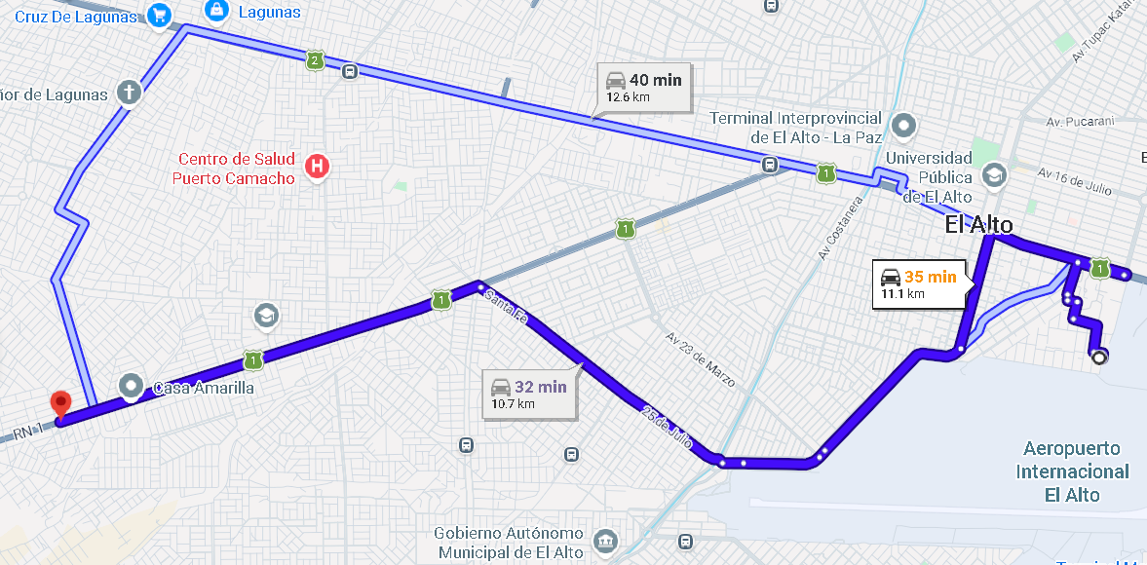
Images/RUTA.png
