ErickCalle/Monitoreo-Consumo-Combustible-La-Paz-Bolivia/Images/RUTA_CHANGAN.png

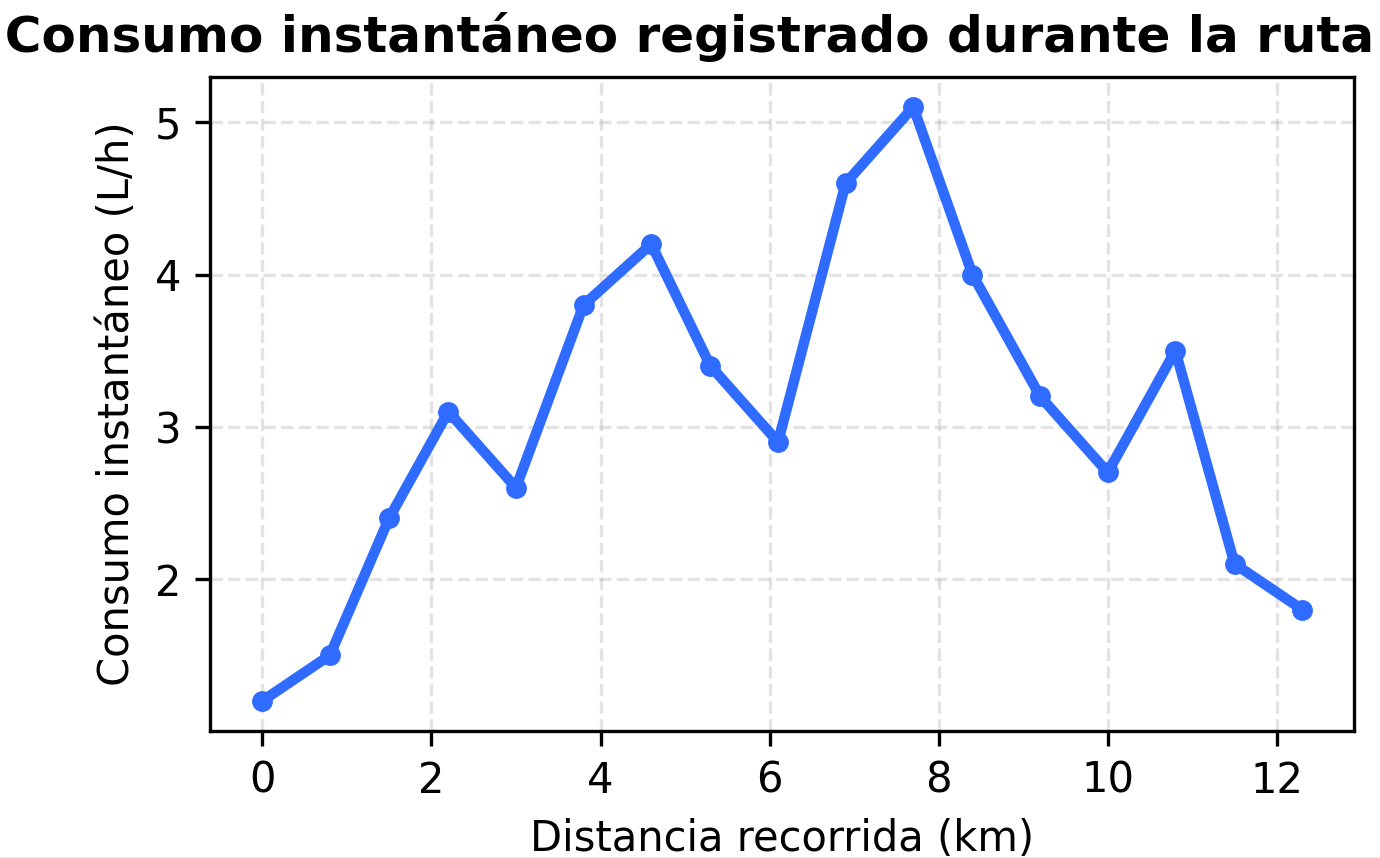
Images/RUTA_CHANGAN.png
