ErickCalle/Monitoreo-Consumo-Combustible-La-Paz-Bolivia/Images/RUTA_NISSAN.png

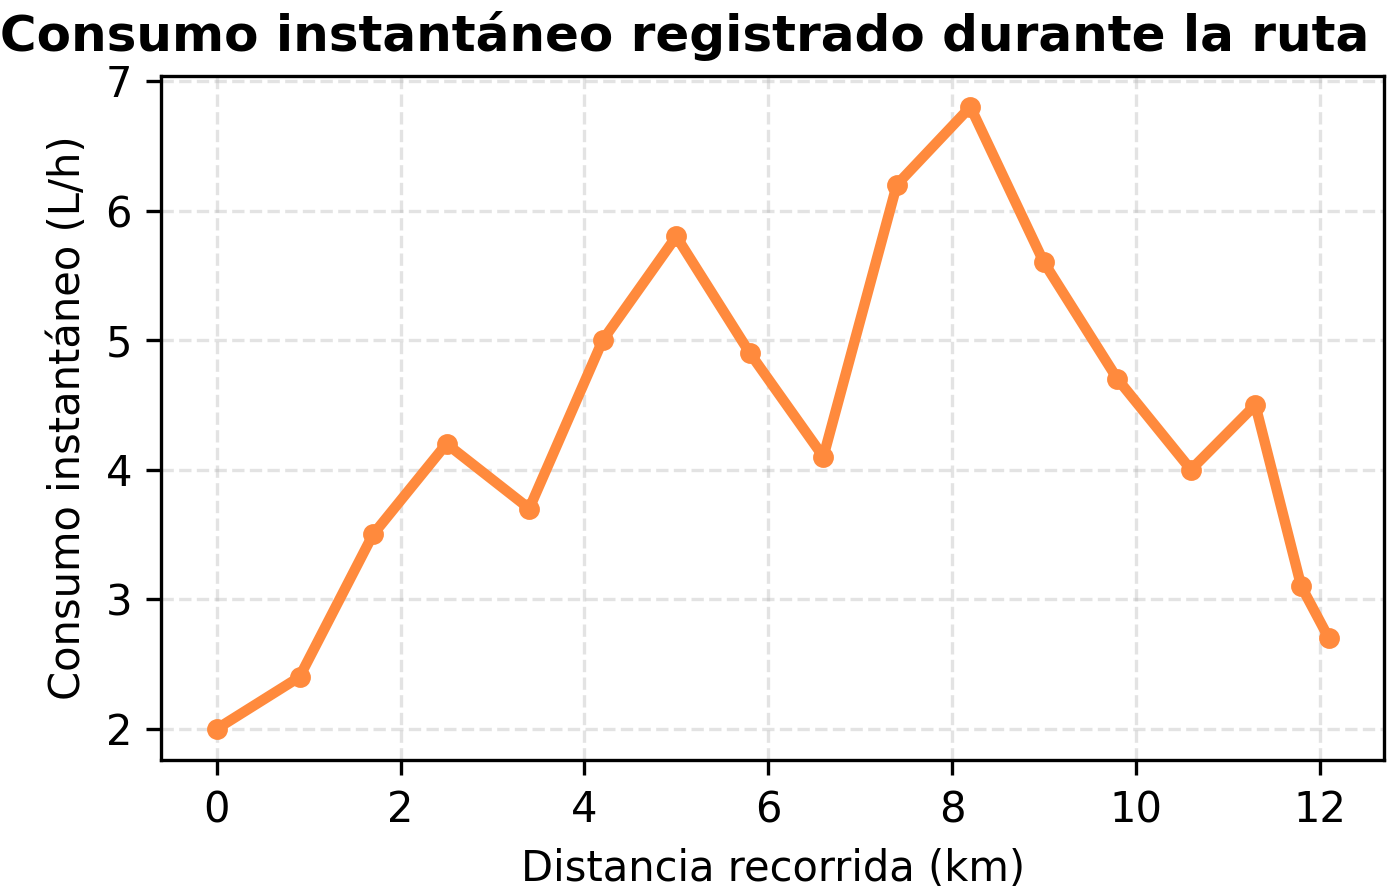
Images/RUTA_NISSAN.png
