ErickCalle/Monitoreo-Consumo-Combustible-La-Paz-Bolivia/Images/Savvy.png

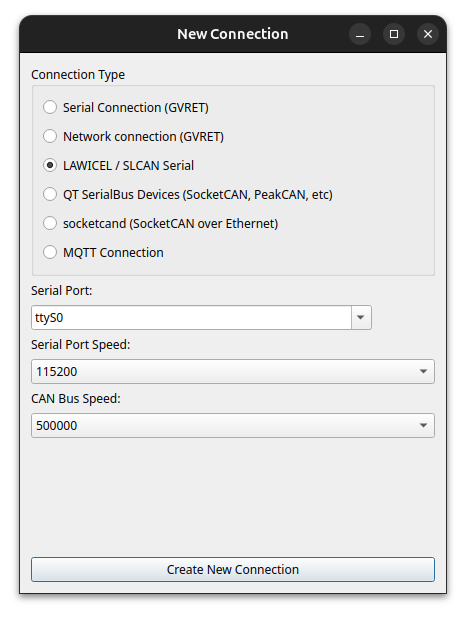
Images/Savvy.png
