ErickCalle/Monitoreo-Consumo-Combustible-La-Paz-Bolivia/Images/sd.png

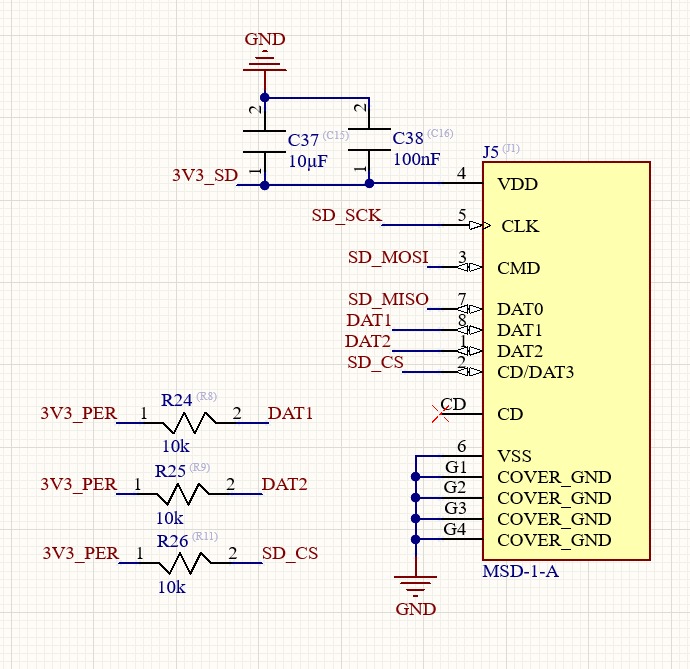
Images/sd.png
