ErickCalle/Monitoreo-Consumo-Combustible-La-Paz-Bolivia/Images/SEC_OBDII.png

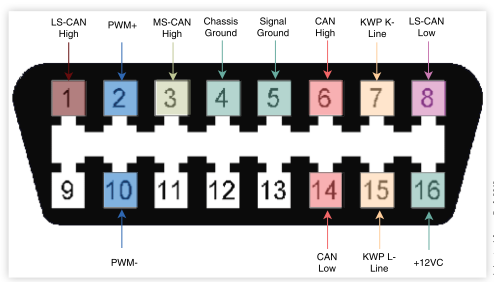
Images/SEC_OBDII.png
