ErickCalle/Monitoreo-Consumo-Combustible-La-Paz-Bolivia/Images/Serial.png

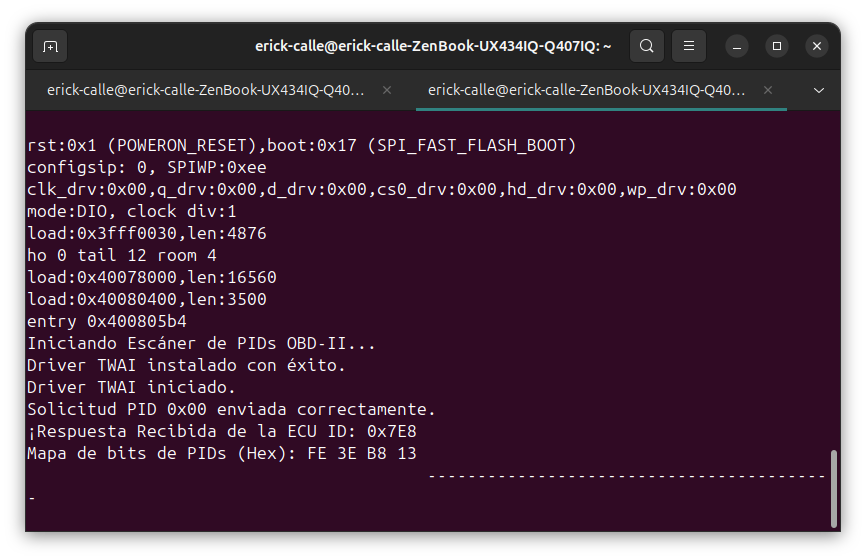
Images/Serial.png
