ErickCalle/Monitoreo-Consumo-Combustible-La-Paz-Bolivia/Images/simulacion_pcb_proto.jpg

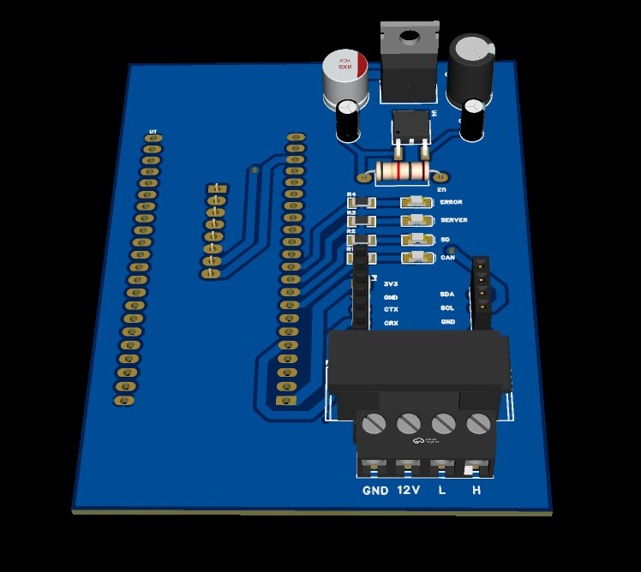
Images/simulacion_pcb_proto.jpg
