ErickCalle/Monitoreo-Consumo-Combustible-La-Paz-Bolivia/Images/sistema.png

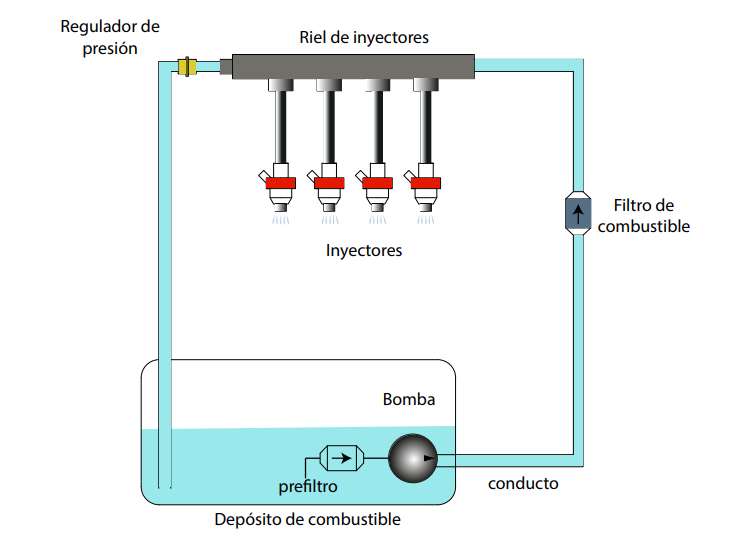
Images/sistema.png
