ErickCalle/Monitoreo-Consumo-Combustible-La-Paz-Bolivia/Images/sn65.png

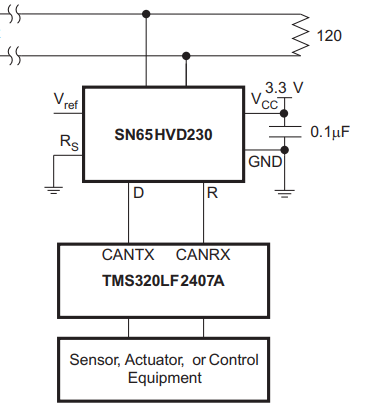
Images/sn65.png
