ErickCalle/Monitoreo-Consumo-Combustible-La-Paz-Bolivia/Images/Sniffer.png

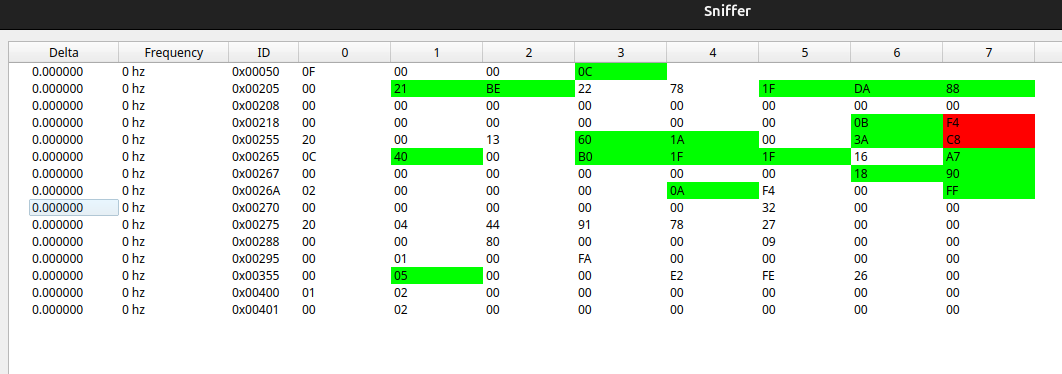
Images/Sniffer.png
