ErickCalle/Monitoreo-Consumo-Combustible-La-Paz-Bolivia/Images/Sonda.JPG

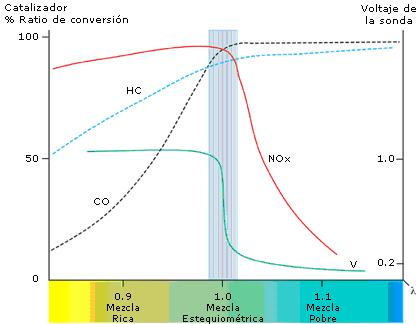
Images/Sonda.JPG
