ErickCalle/Monitoreo-Consumo-Combustible-La-Paz-Bolivia/Images/ss36_forward_char.png

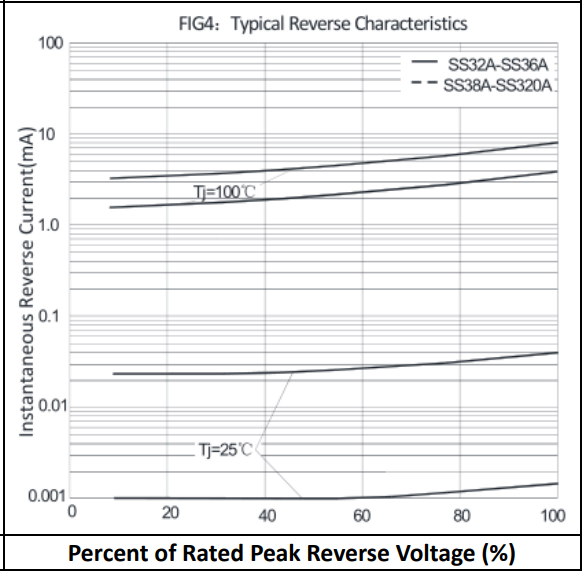
Images/ss36_forward_char.png
