ErickCalle/Monitoreo-Consumo-Combustible-La-Paz-Bolivia/Images/ss36_io_tl.png

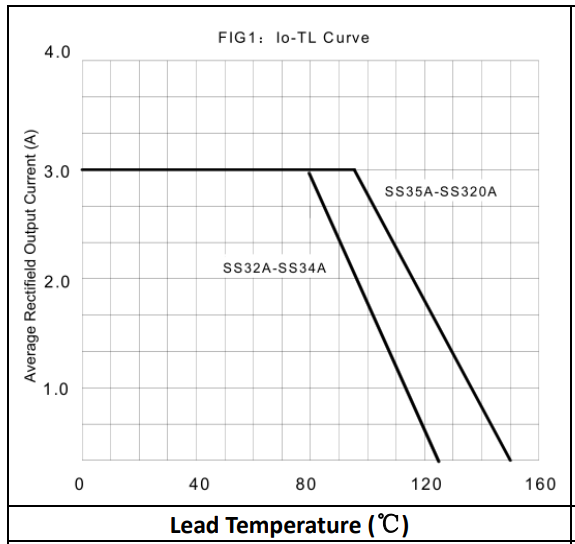
Images/ss36_io_tl.png
