ErickCalle/Monitoreo-Consumo-Combustible-La-Paz-Bolivia/Images/ss36_package.png

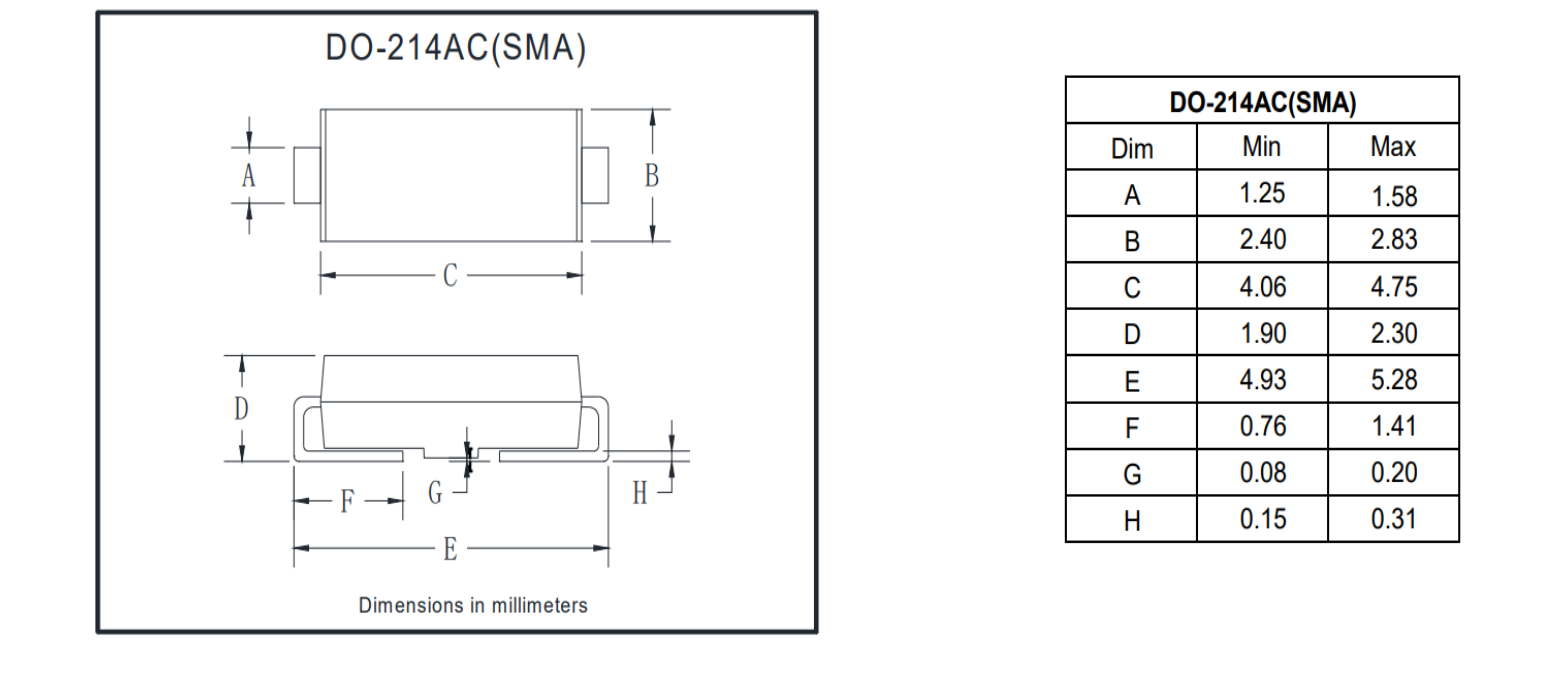
Images/ss36_package.png
