ErickCalle/Monitoreo-Consumo-Combustible-La-Paz-Bolivia/Images/ss36_reverse_char.png

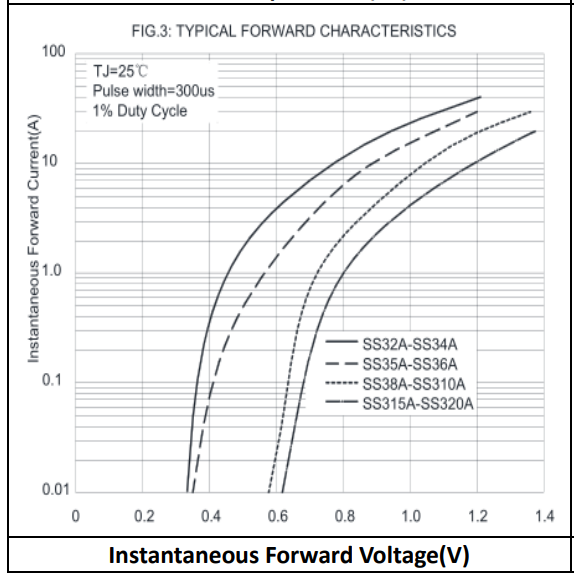
Images/ss36_reverse_char.png
