ErickCalle/Monitoreo-Consumo-Combustible-La-Paz-Bolivia/Images/TAPA_EDITADA.jpg

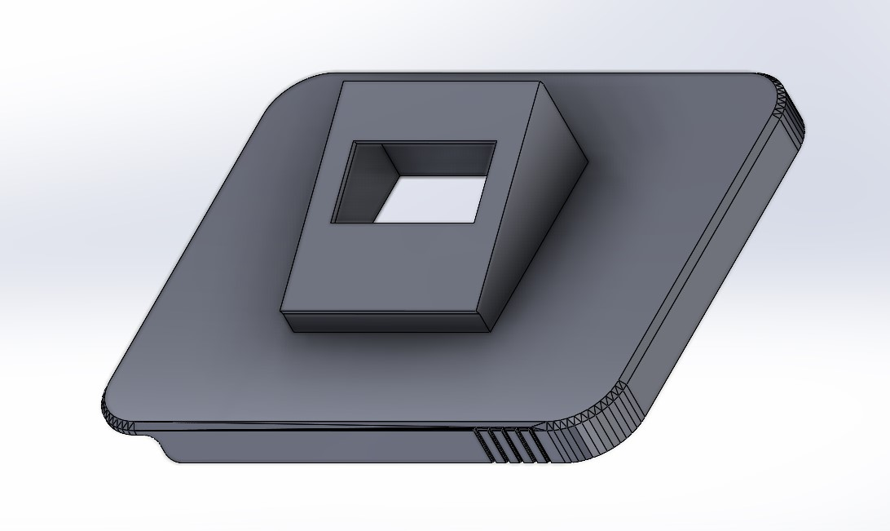
Images/TAPA_EDITADA.jpg
