ErickCalle/Monitoreo-Consumo-Combustible-La-Paz-Bolivia/Images/TAPA_SUPERIOR.jpeg

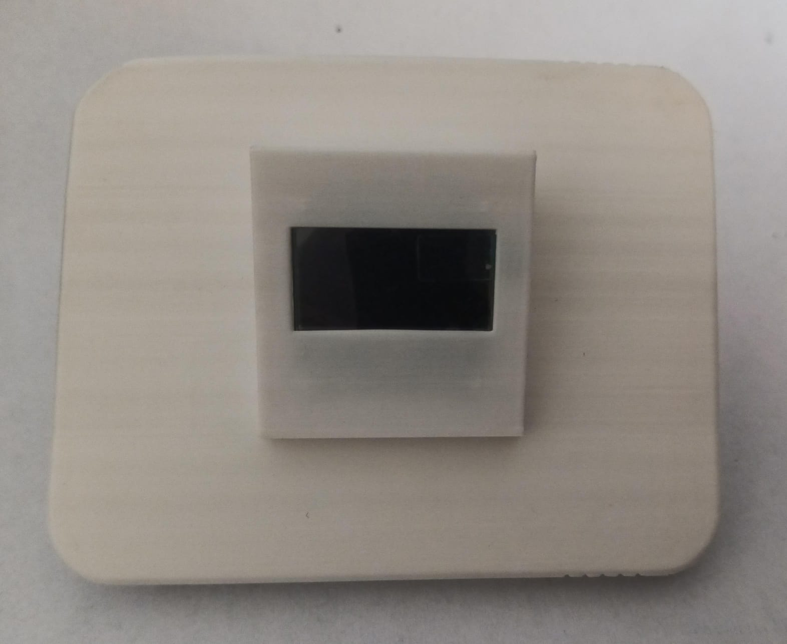
Images/TAPA_SUPERIOR.jpeg
