ErickCalle/Monitoreo-Consumo-Combustible-La-Paz-Bolivia/Images/top.png

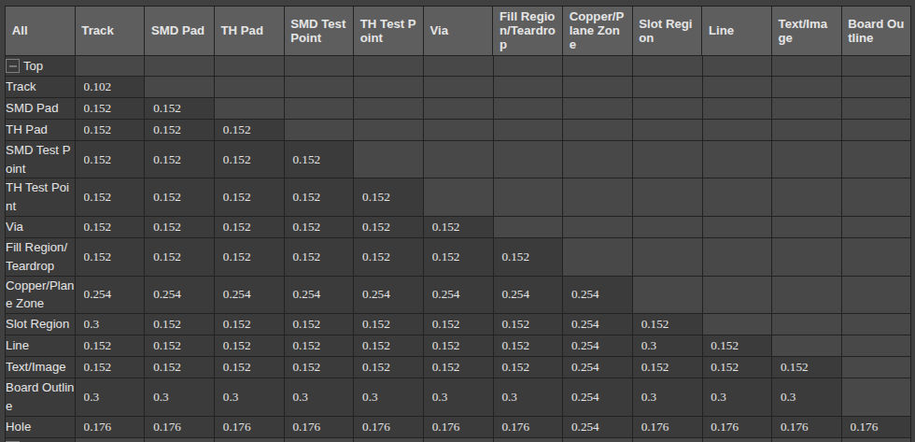
Images/top.png
