ErickCalle/Monitoreo-Consumo-Combustible-La-Paz-Bolivia/Images/top_pcb_proto.jpeg

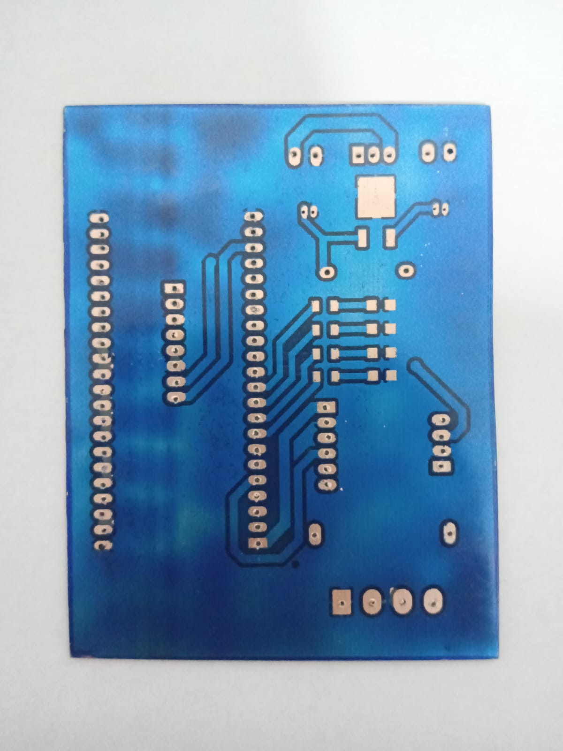
Images/top_pcb_proto.jpeg
