ErickCalle/Monitoreo-Consumo-Combustible-La-Paz-Bolivia/Images/TRANSICION_PCB.png

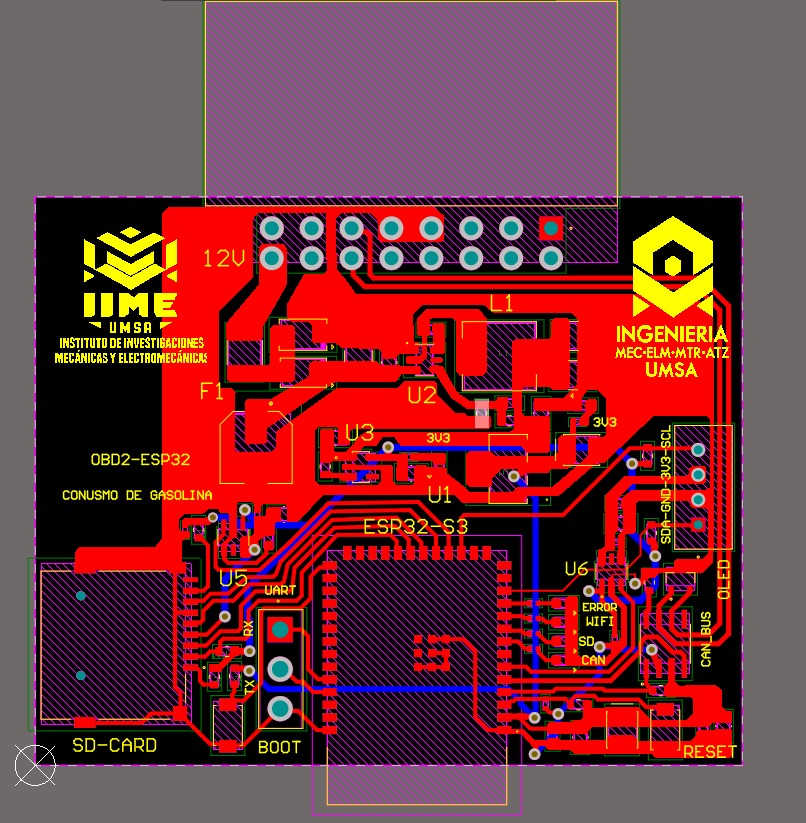
Images/TRANSICION_PCB.png
