ErickCalle/Monitoreo-Consumo-Combustible-La-Paz-Bolivia/Images/transitorios_automotriz.png

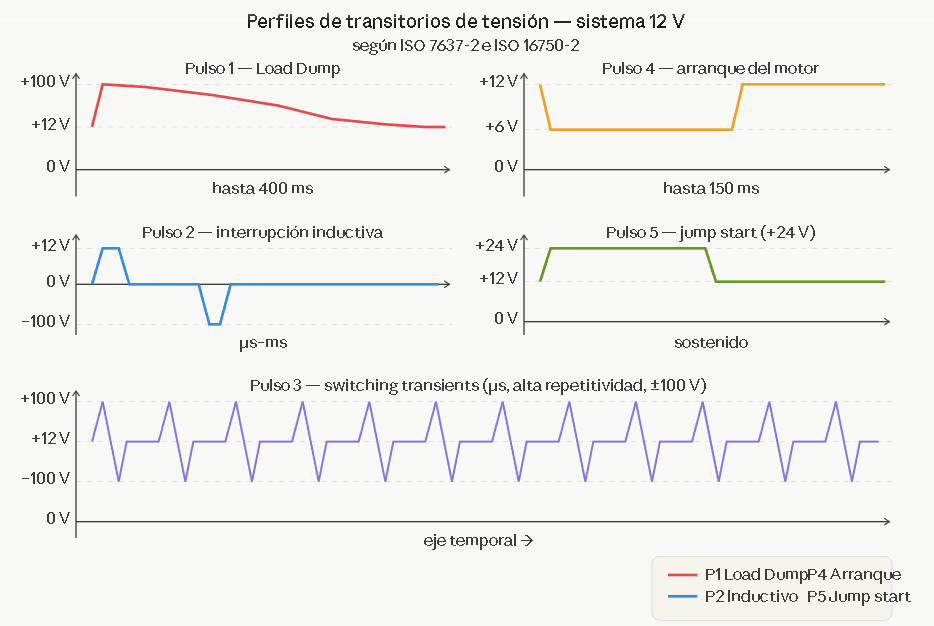
Images/transitorios_automotriz.png
