ErickCalle/Monitoreo-Consumo-Combustible-La-Paz-Bolivia/Images/UART.png

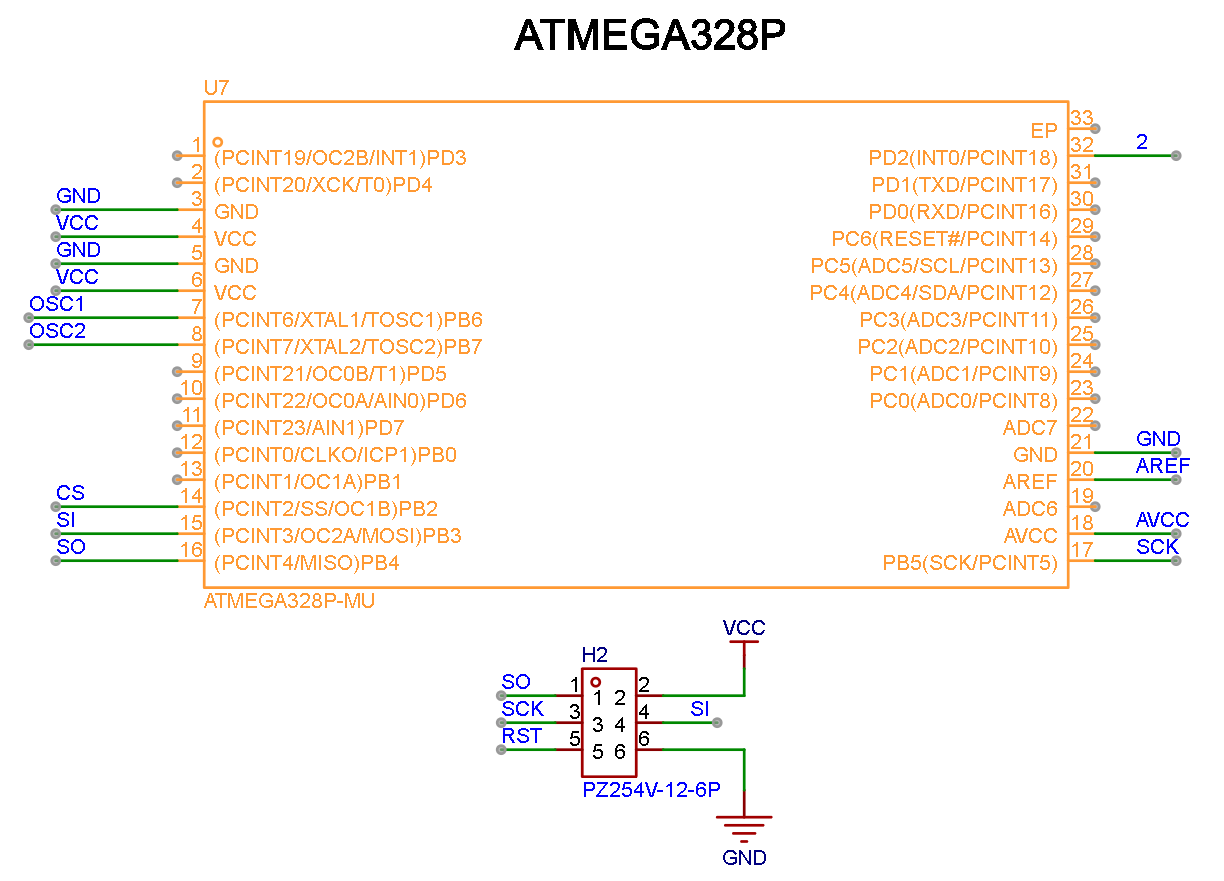
Images/UART.png
