ErickCalle/Monitoreo-Consumo-Combustible-La-Paz-Bolivia/Images/vanette.png

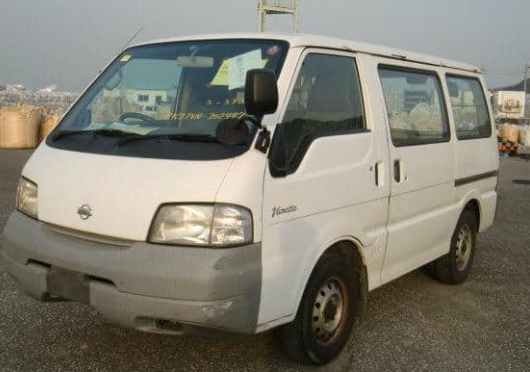
Images/vanette.png
