ErickCalle/Monitoreo-Consumo-Combustible-La-Paz-Bolivia/Images/ve_curve_fit.png

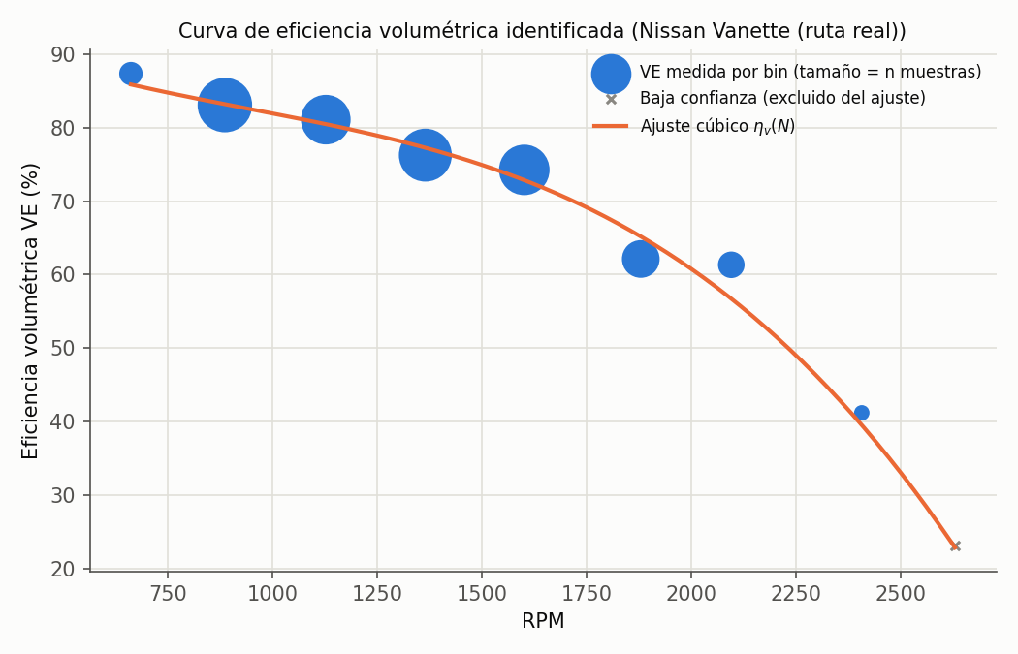
Images/ve_curve_fit.png
