ErickCalle/Monitoreo-Consumo-Combustible-La-Paz-Bolivia/Images/ve_curve_fit_vanette.png

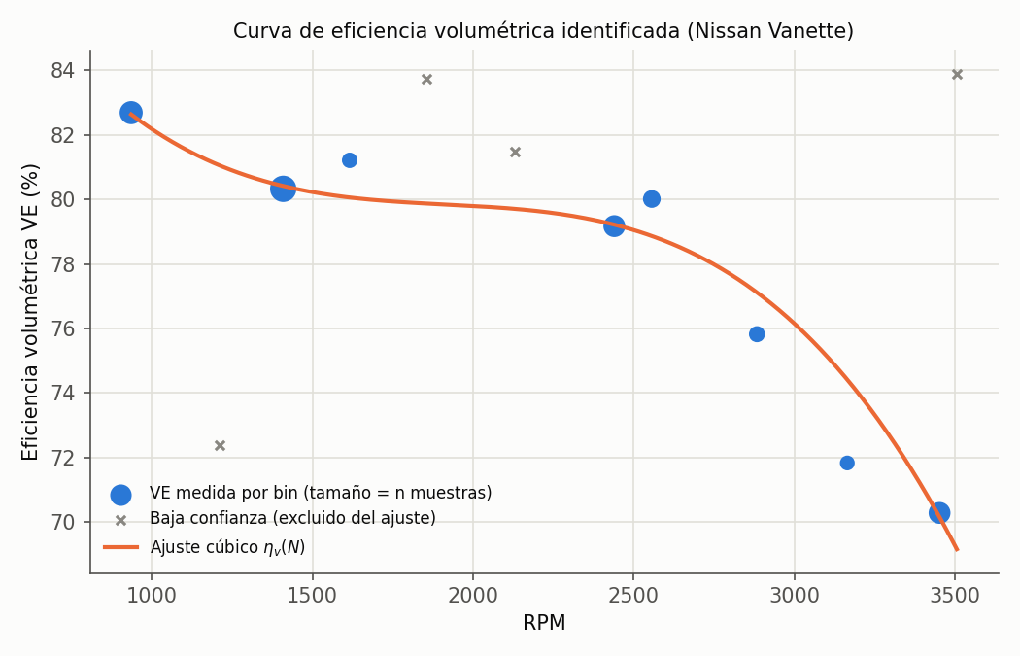
Images/ve_curve_fit_vanette.png
