ErickCalle/Monitoreo-Consumo-Combustible-La-Paz-Bolivia/Images/visu.png

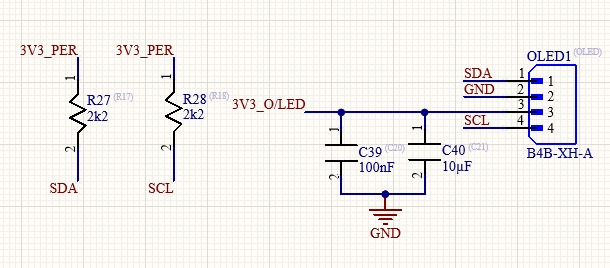
Images/visu.png
