ErickCalle/Monitoreo-Consumo-Combustible-La-Paz-Bolivia/Images/webech.png

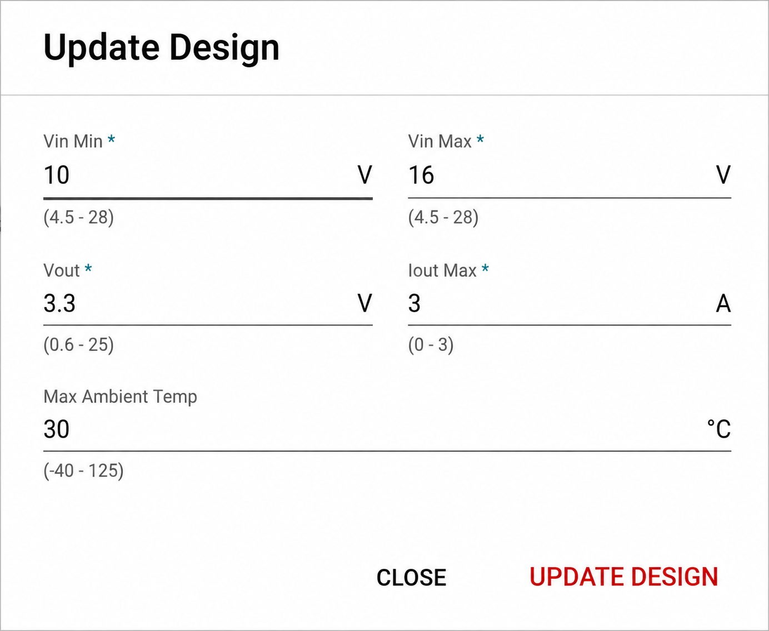
Images/webech.png
