ErickCalle/Monitoreo-Consumo-Combustible-La-Paz-Bolivia/Images/pcb_proto_ensamblada.jpeg

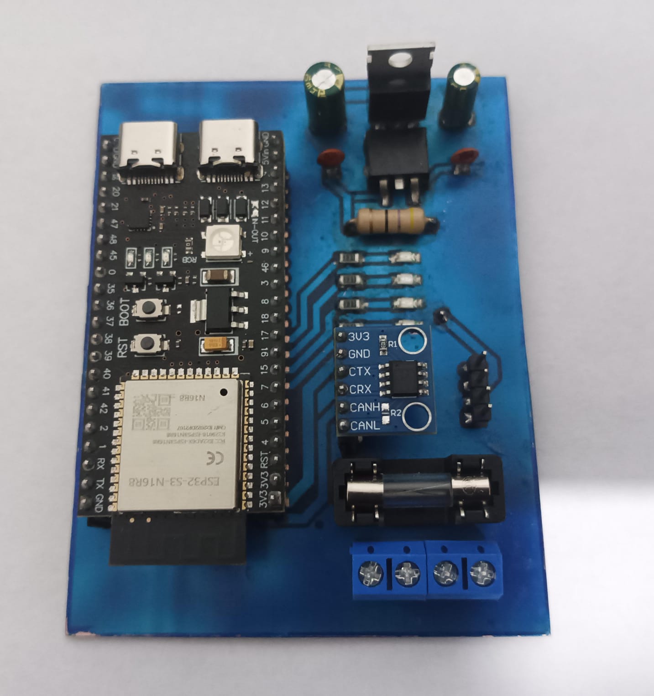
Images/pcb_proto_ensamblada.jpeg
