ErickCalle/Monitoreo-Consumo-Combustible-La-Paz-Bolivia/Images/PROTO_ENSAMBLADA.jpeg

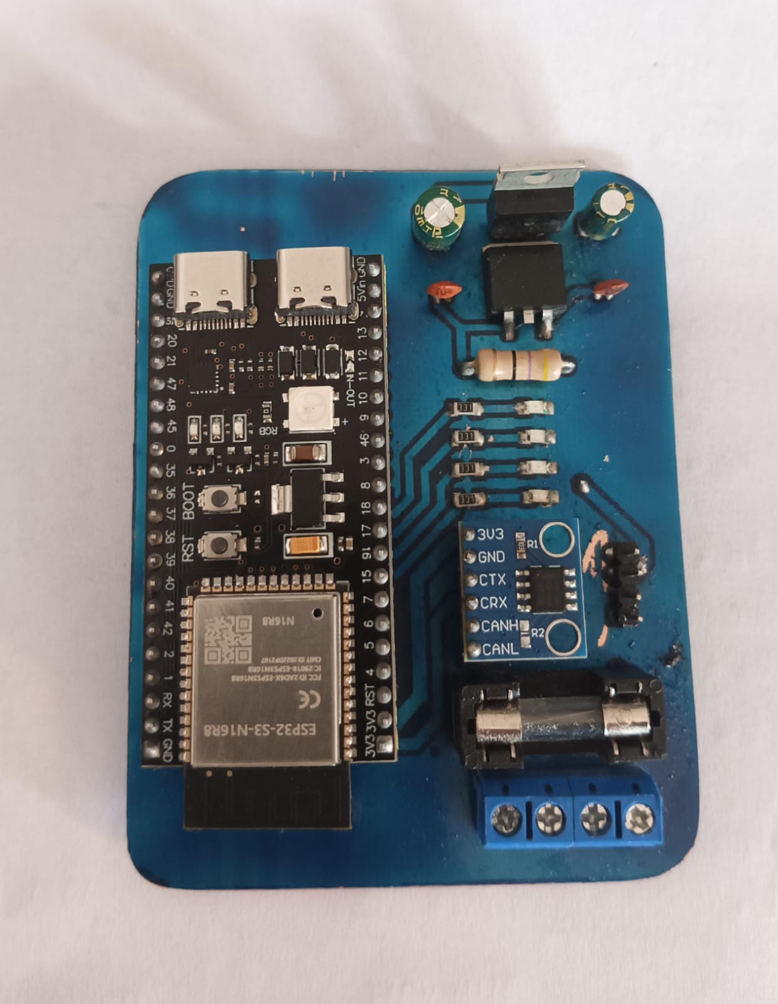
Images/PROTO_ENSAMBLADA.jpeg
