ErickCalle/Monitoreo-Consumo-Combustible-La-Paz-Bolivia/Images/STL_MAKEWORD.jpg

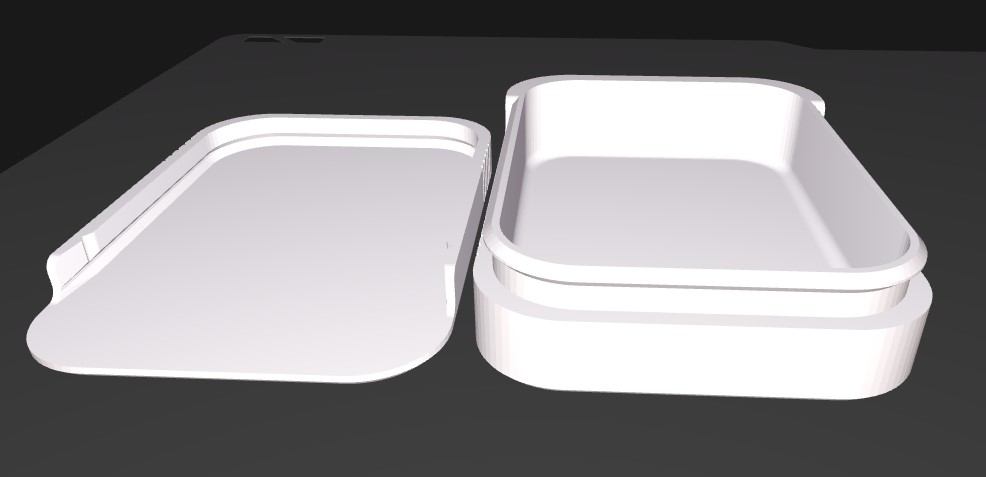
Images/STL_MAKEWORD.jpg
