ErickCalle/Monitoreo-Consumo-Combustible-La-Paz-Bolivia/CODIGOS/sd_log_validator/trip_001.csv

uptime_ms | rpm | speed_kmh | map_kpa | iat_c | coolant_c | ve_pct | maf_gs | fuel_gs | instant_Lh | instant_L100km | trip_km | trip_fuel_L | trip_avg_L100km | can_status | trip_cost_bs
11009 | 0 | 0.0 | 62.0 | 37.0 | 59.0 | 60.0 | 0.00 | 0.000 | 0.00 | 0.00 | 0.000 | 0.0000 | 0.00 | 1 | 0.00
12009 | 1415 | 0.0 | 26.0 | 37.0 | 59.0 | 72.5 | 4.00 | 0.282 | 1.36 | 0.00 | 0.000 | 0.0004 | 0.00 | 1 | 0.00
13009 | 1320 | 0.0 | 24.0 | 37.0 | 59.0 | 70.8 | 3.36 | 0.238 | 1.15 | 0.00 | 0.000 | 0.0008 | 0.00 | 1 | 0.01
14009 | 1258 | 0.0 | 21.0 | 37.0 | 59.0 | 69.8 | 2.76 | 0.195 | 0.94 | 0.00 | 0.000 | 0.0010 | 0.00 | 1 | 0.01
15009 | 1185 | 0.0 | 20.0 | 37.0 | 59.0 | 68.5 | 2.43 | 0.172 | 0.83 | 0.00 | 0.000 | 0.0013 | 0.00 | 1 | 0.01
16009 | 1137 | 0.0 | 20.0 | 37.0 | 59.0 | 67.6 | 2.30 | 0.163 | 0.79 | 0.00 | 0.000 | 0.0015 | 0.00 | 1 | 0.01
17009 | 1099 | 0.0 | 20.0 | 37.0 | 58.0 | 67.0 | 2.21 | 0.156 | 0.75 | 0.00 | 0.000 | 0.0017 | 0.00 | 1 | 0.01
18009 | 1053 | 0.0 | 20.0 | 37.0 | 58.0 | 66.2 | 2.09 | 0.148 | 0.71 | 0.00 | 0.000 | 0.0020 | 0.00 | 1 | 0.01
19009 | 1039 | 0.0 | 19.0 | 37.0 | 58.0 | 65.9 | 1.95 | 0.138 | 0.67 | 0.00 | 0.000 | 0.0021 | 0.00 | 1 | 0.01
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
