ErickCalle/Monitoreo-Consumo-Combustible-La-Paz-Bolivia/CODIGOS/sd_log_validator/trip_002.csv

uptime_ms | rpm | speed_kmh | map_kpa | iat_c | coolant_c | ve_pct | maf_gs | fuel_gs | instant_Lh | instant_L100km | trip_km | trip_fuel_L | trip_avg_L100km | can_status | trip_cost_bs
26195 | 0 | 0.0 | 62.0 | 10.0 | 7.0 | 60.0 | 0.00 | 0.000 | 0.00 | 0.00 | 0.000 | 0.0000 | 0.00 | 1 | 0.00
27195 | 0 | 0.0 | 63.0 | 10.0 | 7.0 | 60.0 | 0.00 | 0.000 | 0.00 | 0.00 | 0.000 | 0.0000 | 0.00 | 1 | 0.00
28195 | 0 | 0.0 | 62.0 | 10.0 | 7.0 | 60.0 | 0.00 | 0.000 | 0.00 | 0.00 | 0.000 | 0.0000 | 0.00 | 1 | 0.00
29195 | 0 | 0.0 | 62.0 | 10.0 | 7.0 | 60.0 | 0.00 | 0.000 | 0.00 | 0.00 | 0.000 | 0.0000 | 0.00 | 1 | 0.00
30195 | 0 | 0.0 | 62.0 | 10.0 | 7.0 | 60.0 | 0.00 | 0.000 | 0.00 | 0.00 | 0.000 | 0.0000 | 0.00 | 1 | 0.00
31195 | 0 | 0.0 | 63.0 | 10.0 | 7.0 | 60.0 | 0.00 | 0.000 | 0.00 | 0.00 | 0.000 | 0.0000 | 0.00 | 1 | 0.00
32195 | 0 | 0.0 | 62.0 | 10.0 | 7.0 | 60.0 | 0.00 | 0.000 | 0.00 | 0.00 | 0.000 | 0.0000 | 0.00 | 1 | 0.00
33195 | 0 | 0.0 | 62.0 | 10.0 | 7.0 | 60.0 | 0.00 | 0.000 | 0.00 | 0.00 | 0.000 | 0.0000 | 0.00 | 1 | 0.00
34195 | 305 | 0.0 | 61.0 | 10.0 | 7.0 | 60.0 | 1.83 | 0.129 | 0.63 | 0.00 | 0.000 | 0.0001 | 0.00 | 1 | 0.00
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
