ErickCalle/Monitoreo-Consumo-Combustible-La-Paz-Bolivia/(commit log)

2026-08-28 Commit inicial: tesis, firmware ESP32-S3 y herramientas de análisis
    Sistema de monitoreo de consumo de combustible orientado a la mejora
    de la eficiencia energética en el transporte público urbano de La Paz
    (UMSA, mecatrónica). Incluye el documento de tesis (LaTeX), el
    firmware del prototipo (PlatformIO/ESP32-S3) y los scripts de Python
    usados para calibración, validación y generación de figuras.
    [driveCycles_7 días.csv, map_altitude_report.csv, partitions.csv, sd_log_report.csv, speed_density_drive_log.csv, speed_density_log.csv, trip_001.csv, trip_002.csv]
2026-08-28 Agregar README con descripción del proyecto, fotos y resultados reales
    Portada del repositorio: descripción del sistema, foto del prototipo,
    captura del panel web en uso real, gráfica de resultados de validación
    (Capítulo 4) y estructura del repositorio.
2026-09-01 Placa preliminar (EasyEDA/Robokit), limpieza de estilo y organización
    - Cap. 3: nueva sección "Placa preliminar (EasyEDA)" con esquemático,
    simulación 3D y fotos de la placa fabricada por Robokit, antes del
    diseño de la placa final en Altium.
    - Cap. 4: corrige la descripción de la placa preliminar (regulador
    lineal simple, no la topología de dos rieles) y referencia cruzada
    a las nuevas figuras del Cap. 3.
    - Cap. 5: costo real de fabricación (Robokit, 150 Bs) y BOM de la
    placa preliminar; recalculo en cascada del presupuesto total, tabla
    comercial, payback y figuras 5.1/5.3.
    - Apéndice: títulos normalizados (ya no en Title Case).
    - Pase de estilo en los 17 scripts de Py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
    [map_altitude_report.csv, speed_density_drive_log.csv, speed_density_log.csv]
2026-09-02 Placa preliminar ensamblada, correcciones de contenido y limpieza de bibliografía
    - Cap. 3: foto de la placa preliminar ensamblada; Tabla 3.15 (BOM) pasa
    a longtable para evitar el desborde de página; Figura 3.12 aclara que
    es del Changan Honor; §3.6 referencia el repositorio de GitHub;
    descargo de alcance (estudio, no implementación) al inicio de la
    sección de lazo cerrado; §3.3.2/3.3.3 corregidas para reflejar la
    pantalla OLED única y la estructura real del CSV del firmware.
    - Bibliografía: 273 -> 160 entradas. Elimina referencias sin usar,
    citas dentro de párrafos comentados, duplicados reales (SAE J1979
    bajo 5 claves, datasheet SN65HVD230 bajo 3) y fuentes de baja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
2026-09-04 Carcasa del prototipo (impresión 3D) y precio de venta (utilidad + IVA)
    - Cap. 3: nueva sección de diseño de la carcasa del prototipo (STL base
    de MakerWorld, tapa editada en SolidWorks para la OLED, impresión en
    PLA con Creality Ender V3 KE); la carcasa de la placa final queda
    pendiente para cuando el tribunal la solicite.
    - Cap. 5: costo de material de la carcasa (Bs 4,81) sumado al total del
    prototipo (706,92 Bs), con recálculo en cascada de presupuesto,
    payback y figuras. Nueva tabla de precio de venta estimado (utilidad
    20% + IVA 13% sobre el costo marginal por unidad).
    - Corrige dos casos más del bug de espaciado tras \% (babel/es-tabla).
    [breakeven_plot.py, presupuesto_pie.py]
2026-09-04 Precio de venta: agregar columna del prototipo real junto a la unidad adicional
    La Tabla 5.13 ahora muestra utilidad+IVA aplicados sobre dos bases de
    costo distintas lado a lado: el prototipo tal como se construyó
    (706,92 Bs) y el costo marginal de una unidad adicional vía placa
    final (772,22 Bs, el que ya se usaba), para que no haya ambigüedad
    sobre a cuál corresponde cada precio de venta.
2026-09-04 Aclarar por qué el costo de gasolina no va en la columna de venta a escala
    La Tabla 5.13 ya excluía correctamente Pruebas y validación (316,32 Bs,
    incluida la gasolina de las pruebas tanque a tanque) del costo marginal
    por unidad adicional (772,22 Bs) -- ese gasto es de validar este
    prototipo, no de producir una unidad más. Se deja explícito en el
    párrafo introductorio en vez de quedar implícito en el cálculo.
2026-09-04 Agregar tercera columna: precio del prototipo sin combustible de prueba
    La Tabla 5.13 ahora tiene tres escenarios de precio de venta: el
    prototipo tal como se construyó (958,58 Bs), la unidad adicional vía
    placa final (1.047,13 Bs), y el prototipo actual excluyendo solo el
    combustible de las pruebas tanque a tanque (750,67 Bs), bajo el
    supuesto de que esas pruebas ya se hicieron y ese gasto no se traslada
    a un comprador de esta misma unidad.
2026-09-06 Agregar Resumen del proyecto, pasar Cap. 1 a tiempo presente y unificar coma decimal
    - Nuevo capitulo RESUMEN antes del Capitulo 1, sintetizando el proyecto
    a partir de la Introduccion y los resultados reales de validacion/costos.
    - Capitulo 1 reescrito en tiempo presente (el sistema ya esta implementado),
    incluyendo Alcances y Limites; se corrige de paso un ESP32C3 obsoleto
    (debia ser ESP32-S3) y pequenos errores de gramatica.
    - Barrido de todo el documento (CAP2, CAP2.1, CAP3, CAP4, CAP5, APENDICE)
    reemplazando el punto decimal por coma en numeros de prosa, tablas y
    formulas, respetando codigo fuente, IPs, numeros de parte, dimensiones
    LaTeX y referencias de seccion/version que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
2026-09-06 Añadir como se logró cada alcance y confirmar cada límite en el Capítulo 1
    - En Alcances (1.6.1): cada punto ahora indica concretamente como se logro
    (controlador CAN TWAI + SN65HVD230, modelo Speed-Density calibrado,
    panel web via SoftAP, validacion con MAPE 2,75% vs ELM327 y 4,84% vs
    aforo real sobre 9 tramos de ruta).
    - En Limites (1.6.2): cada punto ahora indica como se confirmo en la
    practica (pruebas exclusivas en Nissan Vanette y Changan Honor, ambos
    con OBD-II verificado, sin acceso a minibuses, evaluacion separada por
    vehiculo debido a su distinto estado mecanico).
2026-09-06 Cambiar 3.3 por 3,3 en el numero de parte AMS1117-3.3 y AP2112K-3.3TRG1
    Por pedido explicito: se unifica tambien el "3.3" dentro del nombre del
    componente (no solo en menciones de voltaje sueltas) en los 4 archivos
    donde aparece: CAP3, CAP5 (tabla de costos), CAP6 (conclusiones) y
    APENDICE (titulos de Apendice J y K, notas de las hojas de datos).
2026-09-06 Agregar TCM (transmission control module) a los tipos de modulo de control en 2.1.1
2026-09-06 Ampliar teoria del ESP32-S3 como SoC, quitar secciones redundantes y ampliar Futuro y tendencias
    - Nueva subsubseccion "Sistema en chip (SoC): el caso del ESP32-S3" en
    2.9.3 (Arquitectura de microcontroladores), explicando el concepto de
    SoC y describiendo el ESP32-S3-WROOM-1-N16R8 realmente usado en el
    proyecto (Xtensa LX7 dual-core, TWAI nativo, WiFi 2,4 GHz, BLE 5.0,
    16 MB Flash + 8 MB PSRAM).
    - Se eliminan las subsecciones 2.9.9 "Ejemplos practicos y casos de
    estudio" y 2.9.10 "Medidor de consumo de combustible con
    microcontrolador" (redundantes con contenido ya cubierto en otras
    secciones, e incluian una referencia obsoleta a ATmega328P+MCP2515
    que no corresponde al hard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
2026-09-06 Reordenar Capitulo 3: protoboard -> prototipo EasyEDA -> diseno final Altium
    Se reordena la seccion 3.3 (Diseno de hardware) para seguir el flujo
    cronologico real del proyecto:
    1. Modulos individuales probados en protoboard (CAN, OLED, SD, WiFi/web).
    2. Placa preliminar en EasyEDA + carcasa del prototipo (impresion 3D).
    3. Diagrama esquematico general, diseno de la PCB en Altium Designer,
    parametros IPC-2221B, BOM y capacidades de fabricacion JLCPCB.
    No se modifico ningun contenido, solo el orden de dos bloques contiguos
    (verificado con diff de lineas ordenadas: contenido identico). Las
    transiciones de texto ya existentes ("antes de proceder con el diseno
    de la placa final...", "una vez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
2026-09-06 Agregar foto de la tapa impresa (CAP3) y del ensamblaje de la PCB (CAP4)
    - CAP3: reemplaza el placeholder "[Pendiente: fotografia de la tapa]"
    por la foto real (TAPA_SUPERIOR.jpeg); se actualiza el texto ("esta
    pendiente de impresion" -> "ya impresas") y la nota de la figura.
    Se actualiza tambien la Tabla 5.8 (CAP5): "Tapa (pendiente de
    impresion)" -> "Tapa (impresa)".
    - CAP4 (4.1.3, Placa preliminar en EasyEDA): se agrega una figura con
    la foto real del ensamblaje (PROTO_ENSAMBLADA.jpeg), justo despues
    de describir el armado del prototipo en protoboard (4.1.2), en vez
    de solo remitir al lector al Capitulo 3.
2026-09-07 Corregir objetivos con doble verbo y evitar verbos repetidos entre ellos
    - Objetivo General: "Desarrollar e implementar" -> "Implementar".
    - Objetivo especifico (datos OBD-II): "Adquirir y registrar" -> "Recopilar".
    - Objetivo especifico (plataforma IoT): "Disenar e implementar" -> "Integrar".
    - De paso se limpian espacios dobles sueltos ("ESP32 conectado",
    "adaptador ,") en ese ultimo objetivo.
    Verbos finales, uno por objetivo y sin repetirse entre los 7:
    Implementar, Determinar, Desarrollar, Recopilar, Disenar, Integrar, Evaluar.
2026-09-07 Quitar archivo temporal de Word (~$CARTA.docx) e ignorar temporales .docx a futuro
2026-09-19 Cambiar titulo del proyecto a "analisis de la autonomia" y calcular autonomia alcanzada
    - Nuevo titulo en toda la tesis (portada, Resumen, README): "Sistema de
    monitoreo del consumo de combustible para el analisis de la autonomia
    en vehiculos de transporte publico urbano de la ciudad de La Paz",
    en vez de "orientado a la mejora de la eficiencia energetica...".
    - Se reemplaza la frase "mejora/optimizacion de la eficiencia energetica"
    por "analisis de la autonomia" donde describia el proposito del
    proyecto (Resumen, CAP1 Justificacion y Objetivos General/Especificos);
    se deja intacta la teoria generica sobre eficiencia energetica de
    motores en el Capitulo 2, que no es una afirmac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
2026-09-19 Simplificar Capitulo 6: menos parentesis, sin "objetivo cumplido", mas directo
    - Conclusiones respecto a los objetivos planteados: reescrita por
    completo. La intro ahora dice "Se lograron los objetivos planteados
    en el Capitulo 1, con los siguientes puntos:" en vez de una frase
    mas larga sobre "retomar cada objetivo y concluir sobre su grado de
    cumplimiento". Cada punto queda en un par de oraciones: el objetivo
    en negrilla, seguido directamente del dato que lo confirma, sin la
    coletilla repetida "Objetivo cumplido" / "queda cumplido" / "queda
    satisfecho" al final de cada uno, y con muchos menos parentesis
    encadenados.
    - Se recortan parentesis extensos en las conclusiones de h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
2026-09-19 Explicar que es WebSocket antes de usarlo por primera vez (Capitulo 3)
    El documento mencionaba WebSocket mas de una decena de veces (paginas
    de diseno de hardware, software y las conclusiones) sin explicarlo
    nunca: solo se nombraba como la tecnologia usada para el panel web en
    tiempo real. Se agrega un parrafo breve en 3.3.4 ("Arquitectura del
    Servidor Web Embebido"), justo antes de su primer uso tecnico real,
    que explica el protocolo (conexion TCP persistente y bidireccional,
    handshake sobre HTTP, sin el sobrecosto de repetir peticiones HTTP) y
    por que encaja con la necesidad de empujar datos en tiempo real al
    panel web. Se cita el estandar real del protocolo (RFC 6455, Fette y
    Melnikov, 20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
2026-09-20 Acortar el Resumen, quitando redundancia
    Se reduce la extension del Resumen (de 4 parrafos densos a la misma
    estructura pero mas directa): se quita el listado completo de
    parametros del motor (RPM, MAP, IAT, STFT/LTFT) por una mencion
    generica, y se eliminan las coletillas repetidas de cierre
    ("resultados que respaldan la viabilidad tecnica de la propuesta",
    "lo que respalda la pertinencia de una solucion local...") que decian
    esencialmente lo mismo dos veces. Los datos numericos (MAPE, autonomia,
    costos) se mantienen intactos, sin fabricar ni quitar ninguna cifra.
2026-09-20 Agregar MAPE al glosario de siglas y abreviaturas
2026-09-22 Generalizar el titulo a vehiculos a gasolina con inyeccion electronica
    - Nuevo titulo en portada, Resumen y README: "Sistema de monitoreo del
    consumo de combustible para el analisis de la autonomia en vehiculos
    a gasolina con inyeccion electronica", quitando la referencia directa
    al transporte publico urbano de La Paz del titulo.
    - Capitulo 1 (Introduccion, Justificacion, Objetivos especificos y
    Limites): se generaliza el alcance definitorio de "transporte publico
    de la ciudad de La Paz" a "vehiculos a gasolina con inyeccion
    electronica", dejando La Paz, su transporte urbano y los minibuses
    como ejemplos concretos de aplicacion (marcados explicitamente con
    "por ejemplo" / "co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
2026-09-26 Cambiar tesis por proyecto de grado en todo el documento
    Se reemplaza "tesis" por "proyecto de grado" en todas las menciones
    que se refieren a este trabajo:
    - CAP5/cap5.tex: "moneda de referencia ya utilizada en el resto de
    la tesis" -> "...del proyecto de grado" (unica ocurrencia real en
    el PDF renderizado, fuera del titulo/portada ya corregidos antes).
    - README.md y CODIGOS/esp32s3_obd2_speeddensity/README.md: referencias
    a capitulos, estructura del repositorio y el PDF compilado.
    - Comentarios internos no renderizados (encabezados "% Tesis: ..." en
    CAP3, una nota en CAP4, y un comentario en .gitignore), por
    consistencia.
    Se deja intacta la unica ocurrencia real restante: la sec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
2026-10-12 Agregar modulo K-Line (ISO 9141-2) con L9637D para vehiculos sin CAN
    Nueva carpeta CODIGOS/K_LINE/ con un modulo de adquisicion alternativo
    a can_obd2.h/.cpp, para vehiculos cuya ECU responde por K-Line (pin 7
    del OBD-II) en vez de CAN. Misma arquitectura que el modulo CAN
    existente (VehicleData, fuel_calc, patron Init/CheckContact/Task).
    Verificado contra fuentes primarias, no inventado:
    - Pinout del L9637D contra su datasheet oficial de STMicroelectronics
    (tabla "PIN CONNECTION" y "ISO Application Circuit").
    - Formato de trama, checksum y los tiempos W0-W5/P1-P4 contra el
    propio estandar ISO 9141-2:1994(E) (clausulas 6, 7, 11, 12 y Anexo A).
    Incluye README.md con el pinout completo,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
2026-10-12 Completar K_LINE como proyecto standalone igual al esp32s3_obd2_speeddensity
    Antes K_LINE solo tenia el modulo de adquisicion (kline_obd2.h/.cpp) y
    pedia copiarlo a mano al proyecto CAN existente. Ahora es un proyecto
    PlatformIO completo e independiente, con la misma arquitectura:
    - sd_logger, web_server, display_oled, status_leds, power_sleep y
    types.h: copiados del proyecto CAN SIN cambios funcionales (si,
    mismo formato de CSV, mismo panel web con WebSocket e historial,
    misma logica de deep sleep). Esos modulos no saben ni les importa
    si los datos llegaron por CAN o K-Line, solo leen VehicleData.
    - 3 lineas de texto visible (panel web y pantalla OLED) cambian la
    etiqueta "CAN" p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
2026-10-18 Agregar sketch simple de K-Line (solo RPM) para probar en el banco
    Nuevo CODIGOS/kline_rpm_simple/kline_rpm_simple.ino: un unico archivo
    de Arduino IDE, sin dependencias externas, que inicializa el bus
    K-Line (ISO9141-2, L9637D) y lee unicamente PID 0x0C (RPM) en loop,
    imprimiendo por donde se corta el handshake si algo falla.
    Mismo cableado (GPIO38/39), misma temporizacion y mismo formato de
    trama ya verificados en CODIGOS/K_LINE/kline_obd2.cpp contra el
    datasheet del L9637D y el estandar ISO 9141-2 -- es un subconjunto de
    ese modulo, pensado para validar el handshake en el banco antes de
    agregar mas PIDs o integrarlo al proyecto completo.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
2026-10-18 Agregar fast init (ISO14230/KWP2000) como alternativa al init de 5 baudios
    El ECU de un vehiculo OBD-II por K-Line solo esta obligado a soportar
    UNO de los dos metodos de inicializacion (ISO 14230-4:2000, clausula
    4.4, "StartCommunication service": "ECU(s) ... shall only support ONE
    of the two following methods"), asi que una herramienta de diagnostico
    real siempre prueba los dos. El sketch ahora intenta primero el init
    lento de 5 baudios (ISO9141-2, sin cambios) y, si no contesta nada,
    intenta el fast init (25ms bajo + 25ms alto, StartCommunication Service
    0xC1 33 F1 81 66) antes de darse por vencido.
    Agrega tambien requestPidFastInit(), que arma el pedido de PID con el
    formato de encabeza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
2026-10-20 Ampliar teoria de materiales 3D y descripciones de componentes electronicos
    Atender observaciones de tribunales: (1) nueva seccion 2.10 en CAP2 con
    teoria de FDM/FFF y tabla comparativa PLA/ABS/PETG, y justificacion
    ampliada en CAP3 de por que se eligio PLA para el prototipo y PETG/ABS
    como recomendacion para una carcasa de produccion instalada en el
    vehiculo; (2) notas de figuras de la PCB preliminar y el protoboard
    (CAP3 y CAP4) ampliadas para describir que es y que hace cada
    componente visible, pensando en un tribunal sin formacion electronica.
2026-10-20 Agregar apendice con registro de viaje de ejemplo y formulas clave
    Nuevo Apendice Q: reproduce una muestra real de trip_003.csv (sesion en
    ralenti del Changan Honor, ya referenciada en la prueba de integridad
    de microSD del Capitulo 4) para mostrar como luce el registro de cada
    viaje generado por el sistema, y documenta en recuadro las dos
    ecuaciones centrales del modelo: la formula general de consumo
    (Ecuacion de FC en L/100km) y la formula de estimacion Speed-Density,
    la mas importante para vehiculos sin sensor MAF como el usado en la
    validacion.
2026-10-21 Agregar escaner completo de PIDs OBD-II por K-Line
    Sketch standalone para ESP32-S3 + L9637D (CODIGOS/kline_obd2_scanner):
    autotest del bus, inicio rapido (KWP2000) e inicio lento de 5 baudios
    (ISO 9141-2/KWP2000) con diagnostico bit a bit del eco en RX durante
    el envio de la direccion 0x33, deteccion de PIDs Modo 01 soportados y
    datos en vivo decodificados por consola serie. A diferencia de
    kline_rpm_simple (solo RPM), este escanea todo el rango de PIDs y
    sirve como herramienta de diagnostico para aislar fallas de
    comunicacion K-Line en banco.
2026-10-21 Numerar componentes de la Figura 4.1 y describirlos en una tabla
    Reemplaza la Nota en prosa de la Figura 4.1 (componentes sueltos del
    prototipo) por etiquetas numeradas superpuestas sobre la foto (1-5,
    una por componente) y una tabla nueva (Tabla 4.2) que describe que es
    y que hace cada uno, siguiendo el mismo patron solicitado por el
    tribunal para las demas figuras de montaje del Capitulo 3 y 4.
2026-10-21 Mover las ecuaciones enmarcadas del Apendice Q al Capitulo 3
    Elimina la seccion Q.3 del Apendice Q (formulas de consumo y
    Speed-Density en recuadro) y actualiza el titulo del apendice, que
    ahora solo documenta el registro de ejemplo (trip_003.csv). En su
    lugar, enmarca directamente las Ecuaciones 3.12 (FC en L/100km) y 3.15
    (Speed-Density) donde se derivan en el Capitulo 3, marcando esta
    ultima como la ecuacion mas importante del modelo de estimacion.
2026-10-29 Actualizar la placa preliminar de EasyEDA a Altium Designer
    La placa preliminar (esquematico, Figura 3.17, y vista 3D, Figura
    3.18) se redisenio en Altium Designer en vez de EasyEDA. Actualiza la
    atribucion de herramienta en todos los puntos donde se menciona:
    titulos de subseccion en CAP3/CAP4, notas de las Figuras 3.17/3.18,
    y en CAP5 la justificacion de costo de la placa preliminar y el
    origen del BOM exportado para la cotizacion LCSC. Tambien se quita
    EasyEDA de la lista de herramientas de desarrollo "sin costo de
    licenciamiento" del Capitulo 5, ya que el proyecto completo (placa
    final y preliminar) usa ahora Altium Designer.
2026-11-06 Cambiar el titulo del proyecto: quitar el enfoque de autonomia
    Nuevo titulo: "Sistema embebido de estimacion y monitoreo del consumo
    de combustible mediante el protocolo OBD-II en vehiculos a gasolina
    con inyeccion electronica". El titulo anterior incluia una clausula
    de proposito ("para el analisis de la autonomia") que no describe el
    sistema en si y que tampoco es el aporte central del proyecto.
    Se actualiza en consecuencia: portada, resumen, objetivo general y
    objetivos especificos de CAP1 (ya no mencionan la autonomia como meta
    del sistema), y las conclusiones de CAP6, donde el calculo de
    autonomia por tanque lleno se reencuadra como una aplicacion derivada
    de la estimacion de consumo (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
